hiteshbhoyar03/Cubesat/Electrical Power System_EPS/docs/eps pinout.xlsx

Sheet: Legend
PIN TYPE | REMARKS | Status | Date | Description | Item | Was | Is | Approved by | Protection Notes:
ANALOG | A | Created | 2025-06-10 | Created the sheet | Whole sheet |  | V1.0.0 | Hitesh
CAN | C
GPIO | G
I2C | I
USB_OTG | O
QUADSPI | Q
SPI | S
TIMER | T
UART | U
JTAG
NO CONNECTION | NC

Sheet: SRIC
PIN NUMBER | PIN SIGNAL | REMARK | PIN USAGE | Discription
PA05 | ADC1_IN10 |  | Ports | Adc Port for External device like bms
PA00 | ADC1_IN5 |  | Ports | Adc Port for External device like bms
PA01 | ADC1_IN6 |  | Ports | Adc Port for External device like bms
PA04 | ADC1_IN9 |  | Ports | Adc Port for External device like bms
PB09 | DEBUG_LED1_SR |  | Led | Digital OUTPUT:Active low push pull configuration Debug Led
PB08 | DEBUG_LED2_SR |  | Led | Digital OUTPUT:Active low push pull configuration Debug Led
PB07 | DEBUG_LED3_SR |  | Led | Digital OUTPUT:Active low push pull configuration Debug Led
PB06 | DEBUG_LED4_SR |  | Led | Digital OUTPUT:Active low push pull configuration Debug Led
PA12 | DONE_SR |  |  | Watchdog
PB13 | EN_3V3_1_BUCK_SR |  |  | Digital OUTPUT:Active high push pull configuration
PB14 | EN_3V3_1_SR |  |  | Digital OUTPUT:Active high push pull configuration
PB00 | EN_3V3_2_BUCK_SR |  |  | Digital OUTPUT:Active high push pull configuration
PB01 | EN_3V3_2_SR |  |  | Digital OUTPUT:Active high push pull configuration
PB15 | EN_5V_BOOST_SR |  |  | Digital OUTPUT:Active high push pull configuration
PA08 | EN_5V_SR |  |  | Digital OUTPUT:Active high push pull configuration
PA07 | EN_MCU_3V3_SR |  |  | Digital OUTPUT:Active high push pull configuration
PA06 | EN_MCU_BUCK_SR |  |  | Digital OUTPUT:Active high push pull configuration
PB02 | EN_UNREG1_SR |  |  | Digital OUTPUT:Active high push pull configuration
PB12 | EN_UNREG2_SR |  |  | Digital OUTPUT:Active high push pull configuration
PC13 | nEN_EPS_3V3_SR |  |  | Digital OUTPUT:Active low push pull configuration
PA11 | WAKE_SR
PH0-OSC_IN (PH0) | RCC_OSC_IN
PH1-OSC_OUT (PH1) | RCC_OSC_OUT
PC14-OSC32_IN (PC14) | RCC_OSC32_IN
PC15-OSC32_OUT (PC15) | RCC_OSC32_OUT
PA14 | SYS_JTCK-SWCLK |  |  | Jtag
PB03 | SYS EXTRA |  |  | Jtag
PA13 | SYS_JTMS-SWDIO |  |  | Jtag
PA10 | USART1_RX |  |  | DEBUG UART
PA09 | USART1_TX |  |  | DEBUG UART
PA03 | USART2_RX |  |  | Uart EPS -SR
PA02 | USART2_TX |  |  | Uart EPS -SR
PB11 | USART3_RX |  |  | Uart OBC -SR
PB10 | USART3_TX |  |  | Uart OBC -SR

Sheet: PMIC
PIN NUMBER | PIN SIGNAL | REMARK | PIN USAGE | Discription
PA05 | ADC1_IN05 | A |  | ISENS_3V3_1
PA06 | ADC1_IN06 | A |  | ISENS_MCU
PA07 | ADC1_IN07 | A |  | Iout_Z-
PC04 | ADC1_IN08 | A |  | Iout_Y+
PC05 | ADC1_IN09 | A |  | Iout_X-
PB00 | ADC1_IN10 | A |  | Iout_Z+
PB01 | ADC1_IN11 | A |  | Iout_Y-
PA00 | ADC1_IN12 | A |  | Iout_X+
PA01 | ADC1_IN13 | A |  | Vout_YZ
PA02 | ADC1_IN14 | A |  | Vout_ZX
PA03 | ADC1_IN15 | A |  | Vout_XY
PA04 | ADC1_IN16 | A |  | Vout_Panels
PC00 | ADC3_IN1 | A |  | ISENS_UNREG2
PC01 | ADC3_IN2 | A |  | ISENS_UNREG1
PC02 | ADC3_IN3 | A |  | ISENS_5V
PC03 | ADC3_IN4 | A |  | ISENS_3V3_2
PD00 | CAN1_RX | C | PC-104 | Can A
PD01 | CAN1_TX | C | PC-104 | Can A
PB12 | CAN2_RX | C | PC-104 | Can B
PB13 | CAN2_TX | C | PC-104 | Can B
PB06 | I2C1_SCL | I | Port
PB09 | I2C1_SDA | I | Port
PE01 | DEBUG_LED1 | G | Led | Digital OUTPUT:Active low push pull configuration Debug Led
PE02 | DEBUG_LED2 | G | Led | Digital OUTPUT:Active low push pull configuration Debug Led
PE03 | DEBUG_LED3 | G | Led | Digital OUTPUT:Active low push pull configuration Debug Led
PE04 | DEBUG_LED4 | G | Led | Digital OUTPUT:Active low push pull configuration Debug Led
PE05 | DEBUG_LED5 | G | Led | Digital OUTPUT:Active low push pull configuration Debug Led
PC08 | DONE | G |  | Watchdog
PD11 | EN_3V3_1_BUCK_PM | G |  | Digital OUTPUT:Active high push pull configuration
PE14 | EN_3V3_1_PM | G |  | Digital OUTPUT:Active high push pull configuration
PE15 | EN_3V3_2_BUCK_PM | G |  | Digital OUTPUT:Active high push pull configuration
PD10 | EN_3V3_2_PM | G |  | Digital OUTPUT:Active high push pull configuration
PB02 | EN_5V_BOOST_PM | G |  | Digital OUTPUT:Active high push pull configuration
PE07 | EN_5V_PM | G |  | Digital OUTPUT:Active high push pull configuration
PD08 | EN_MCU_3V3_PM | G |  | Digital OUTPUT:Active high push pull configuration
PD09 | EN_MCU_BUCK_PM | G |  | Digital OUTPUT:Active high push pull configuration
PE08 | EN_UNREG1_PM | G |  | Digital OUTPUT:Active high push pull configuration
PE09 | EN_UNREG2_PM | G |  | Digital OUTPUT:Active high push pull configuration
PC09 | WAKE | G |  | Watchdog
PE12 | QUADSPI_BK1_IO0 | Q |  | Mram
PE13 | QUADSPI_BK1_IO1 | Q |  | Mram
PE11 | QUADSPI_BK1_NCS | Q |  | Mram
PE10 | QUADSPI_CLK | Q |  | Mram
PH0-OSC_IN (PH0) | RCC_OSC_IN
PH1-OSC_OUT (PH1) | RCC_OSC_OUT
PC14-OSC32_IN (PC14) | RCC_OSC32_IN
PC15-OSC32_OUT (PC15) | RCC_OSC32_OUT
PB14 | SPI2_MISO | S |  | NA
PB15 | SPI2_MOSI | S |  | NA
PD03 | SPI2_SCK | S |  | NA
PA14 (JTCK/SWCLK) | SYS_JTCK-SWCLK |  |  | Jtag
PA15 (JTDI) | SYS_JTDI |  |  | Jtag
PB03 (JTDO/TRACESWO) | SYS_JTDO-SWO |  |  | Jtag
PA13 (JTMS/SWDIO) | SYS_JTMS-SWDIO |  |  | Jtag
PB04 (NJTRST) | SYS_JTRST |  |  | Jtag
PC06 | TIM3_CH1 | T |  | Battery Heater Pwm
PC07 | TIM3_CH2 | T |  | Battery Heater Pwm
PD12 | TIM4_CH1 | T |  | Mppt_Pwm1
PD13 | TIM4_CH2 | T |  | Mppt_Pwm2
PD14 | TIM4_CH3 | T |  | Mppt_Pwm3
PC11 | UART4_RX | U |  | Uart Port for External device like bms
PC10 | UART4_TX | U |  | Uart Port for External device like bms
PB07 | USART1_RX | U |  | DEBUG UART
PA09 | USART1_TX | U |  | DEBUG UART
PD06 | USART2_RX | U |  | Uart SR_EPS
PD05 | USART2_TX | U |  | Uart SR_EPS
PB11 | USART3_RX | U |  | Uart OBC -EPS
PB10 | USART3_TX | U |  | Uart OBC -EPS
PA11 | USB_OTG_FS_DM | O |  | micro usb port
PA12 | USB_OTG_FS_DP | O |  | micro usb port
PA10 | USB_OTG_FS_ID | O |  | micro usb port

Sheet: PMIC ordered
PIN NUMBER | PIN SIGNAL | REMARK
PA00 | ADC1_IN12 | A
PA01 | ADC1_IN13 | A
PA02 | ADC1_IN14 | A
PA03 | ADC1_IN15 | A
PA04 | ADC1_IN16 | A
PA05 | ADC1_IN05 | A
PA06 | ADC1_IN06 | A
PA07 | ADC1_IN07 | A
PA09 | USART1_TX | U
PA10 | USB_OTG_FS_ID | O
PA11 | USB_OTG_FS_DM | O
PA12 | USB_OTG_FS_DP | O
PA13 (JTMS/SWDIO) | SYS_JTMS-SWDIO
PA14 (JTCK/SWCLK) | SYS_JTCK-SWCLK
PA15 (JTDI) | SYS_JTDI
PB00 | ADC1_IN10 | A
PB01 | ADC1_IN11 | A
PB02 | EN_5V_BOOST_PM | G
PB03 (JTDO/TRACESWO) | SYS_JTDO-SWO
PB04 (NJTRST) | SYS_JTRST
PB06 | I2C1_SCL | I
PB07 | USART1_RX | U
PB09 | I2C1_SDA | I
PB10 | USART3_TX | U
PB11 | USART3_RX | U
PB12 | CAN2_RX | C
PB13 | CAN2_TX | C
PB14 | SPI2_MISO | S
PB15 | SPI2_MOSI | S
PC00 | ADC3_IN1 | A
PC01 | ADC3_IN2 | A
PC02 | ADC3_IN3 | A
PC03 | ADC3_IN4 | A
PC04 | ADC1_IN08 | A
PC05 | ADC1_IN09 | A
PC06 | TIM3_CH1 | T
PC07 | TIM3_CH2 | T
PC08 | DONE | G
PC09 | WAKE | G
PC10 | UART4_TX | U
PC11 | UART4_RX | U
PC14-OSC32_IN (PC14) | RCC_OSC32_IN
PC15-OSC32_OUT (PC15) | RCC_OSC32_OUT
PD00 | CAN1_RX | C
PD01 | CAN1_TX | C
PD03 | SPI2_SCK | S
PD05 | USART2_TX | U
PD06 | USART2_RX | U
PD08 | EN_MCU_3V3_PM | G
PD09 | EN_MCU_BUCK_PM | G
PD10 | EN_3V3_2_PM | G
PD11 | EN_3V3_1_BUCK_PM | G
PD12 | TIM4_CH1 | T
PD13 | TIM4_CH2 | T
PD14 | TIM4_CH3 | T
PE01 | DEBUG_LED1 | G
PE02 | DEBUG_LED2 | G
PE03 | DEBUG_LED3 | G
PE04 | DEBUG_LED4 | G
PE05 | DEBUG_LED5 | G
PE07 | EN_5V_PM | G
PE08 | EN_UNREG1_PM | G
PE09 | EN_UNREG2_PM | G
PE10 | QUADSPI_CLK | Q
PE11 | QUADSPI_BK1_NCS | Q
PE12 | QUADSPI_BK1_IO0 | Q
PE13 | QUADSPI_BK1_IO1 | Q
PE14 | EN_3V3_1_PM | G
PE15 | EN_3V3_2_BUCK_PM | G
PH0-OSC_IN (PH0) | RCC_OSC_IN
PH1-OSC_OUT (PH1) | RCC_OSC_OUT

Sheet: Uart Protocol data
 |  |  |  |  |  | PMIC_2_SRIC |  |  | SRIC_2_PMIC |  |  | OBC_2_SRIC |  |  | SRIC_2_OBC |  |  | OBC_2_PMIC |  |  | PMIC_2_OBC
 |  |  |  |  |  | DATA |  |  | DATA |  |  | DATA |  |  | DATA |  |  | DATA |  |  | DATA
SENDER | RECEIVER | HEADER1 | HEADER2 | Byte | Remark | Function | Byte | Remark | Function | Byte | Remark | Function | Byte | Remark | Function | Byte | Remark | Function | Byte | Remark | Function
 |  |  |  | 1 | HEADER1 | 0xEF | 1 | HEADER1 | 0xFE | 1 | HEADER1 | 0xBF | 1 | HEADER1 | 0xFB | 1 | HEADER1 | 0xBE | 1 | HEADER1 | 0xEB
ADCS | OBC | 0xAB |  | 2 | HEADER2 |  | 2 | HEADER2 |  | 2 | HEADER2 |  | 2 | HEADER2 |  | 2 | HEADER2 |  | 2 | HEADER2
OBC | ADCS | 0xBA |  | 3 | channel_0 | nEN_EPS_3V3 | 3 | channel_0 |  | 3 | channel_0 | EN_3V3_1_BUCK | 3 | channel_0 |  | 3 | channel_0 | EN_3V3_1_BUCK | 3 | channel_0
OBC | TEL1 | 0xBC |  | 4 | channel_1 |  | 4 | channel_1 |  | 4 | channel_1 | EN_3V3_1 | 4 | channel_1 |  | 4 | channel_1 | EN_3V3_1 | 4 | channel_1
OBC | TEL2 | 0xBD |  | 5 | channel_2 |  | 5 | channel_2 |  | 5 | channel_2 | EN_3V3_2_BUCK | 5 | channel_2 |  | 5 | channel_2 | EN_3V3_2_BUCK | 5 | channel_2
OBC | PMIC | 0xBE |  | 6 | channel_3 |  | 6 | channel_3 |  | 6 | channel_3 | EN_3V3_2 | 6 | channel_3 |  | 6 | channel_3 | EN_3V3_2 | 6 | channel_3
OBC | SRIC | 0xBF |  | 7 | channel_4 |  | 7 | channel_4 |  | 7 | channel_4 | EN_5V_BOOST | 7 | channel_4 |  | 7 | channel_4 | EN_5V_BOOST | 7 | channel_4
PMIC | SRIC | 0xEF |  | 8 | channel_5 |  | 8 | channel_5 |  | 8 | channel_5 | EN_5V | 8 | channel_5 |  | 8 | channel_5 | EN_5V | 8 | channel_5
PMIC | OBC | 0xEB |  | 9 | channel_6 |  | 9 | channel_6 |  | 9 | channel_6 | EN_UNREG1 | 9 | channel_6 |  | 9 | channel_6 | EN_UNREG1 | 9 | channel_6
SRIC | OBC | 0xFB |  | 10 | channel_7 |  | 10 | channel_7 |  | 10 | channel_7 | EN_UNREG2 | 10 | channel_7 |  | 10 | channel_7 | EN_UNREG2 | 10 | channel_7
SRIC | PMIC | 0xFE |  | 11 | channel_8 |  | 11 | channel_8 |  | 11 | channel_8 | EN_MCU_BUCK | 11 | channel_8 |  | 11 | channel_8 | EN_MCU_BUCK | 11 | channel_8
TEL1 | OBC | 0xCB |  | 12 | channel_9 |  | 12 | channel_9 |  | 12 | channel_9 | EN_MCU_3V3 | 12 | channel_9 |  | 12 | channel_9 | EN_MCU_3V3 | 12 | channel_9
TEL2 | OBC | 0xDB |  | 13 | channel_a |  | 13 | channel_a |  | 13 | channel_a | nEN_EPS_3V3 | 13 | channel_a |  | 13 | channel_a |  | 13 | channel_a
 |  |  |  | 14 | channel_b |  | 14 | channel_b |  | 14 | channel_b |  | 14 | channel_b |  | 14 | channel_b |  | 14 | channel_b
 |  |  |  | 15 | channel_c |  | 15 | channel_c |  | 15 | channel_c |  | 15 | channel_c |  | 15 | channel_c |  | 15 | channel_c
 |  |  |  | 16 | channel_d |  | 16 | channel_d |  | 16 | channel_d |  | 16 | channel_d |  | 16 | channel_d |  | 16 | channel_d
 |  |  |  | 17 | channel_e |  | 17 | channel_e |  | 17 | channel_e |  | 17 | channel_e |  | 17 | channel_e |  | 17 | channel_e
 |  |  |  | 18 | channel_f |  | 18 | channel_f |  | 18 | channel_f |  | 18 | channel_f |  | 18 | channel_f |  | 18 | channel_f
 |  |  |  | 19 | crc_low |  | 19 | crc_low |  | 19 | crc_low |  | 19 | crc_low |  | 19 | crc_low |  | 19 | crc_low
 |  |  |  | 20 | crc_high |  | 20 | crc_high |  | 20 | crc_high |  | 20 | crc_high |  | 20 | crc_high |  | 20 | crc_high

Sheet: PWR EN
 | BIT_7 | BIT_6 | BIT_5 | BIT_4 | BIT_3 | BIT_2 | BIT_1 | BIT_0
channel_0 | tbd | tbd | tbd | tbd | tbd | tbd | tbd | EN PWR | EN_3V3_1_BUCK | OBC 2 SRIC | OBC 2 PMIC
channel_1 | tbd | tbd | tbd | tbd | tbd | tbd | tbd | EN PWR | EN_3V3_1 | OBC 2 SRIC | OBC 2 PMIC
channel_2 | tbd | tbd | tbd | tbd | tbd | tbd | tbd | EN PWR | EN_3V3_2_BUCK | OBC 2 SRIC | OBC 2 PMIC
channel_3 | tbd | tbd | tbd | tbd | tbd | tbd | tbd | EN PWR | EN_3V3_2 | OBC 2 SRIC | OBC 2 PMIC
channel_4 | tbd | tbd | tbd | tbd | tbd | tbd | tbd | EN PWR | EN_5V_BOOST | OBC 2 SRIC | OBC 2 PMIC
channel_5 | tbd | tbd | tbd | tbd | tbd | tbd | tbd | EN PWR | EN_5V | OBC 2 SRIC | OBC 2 PMIC
channel_6 | tbd | tbd | tbd | tbd | tbd | tbd | tbd | EN PWR | EN_UNREG1 | OBC 2 SRIC | OBC 2 PMIC
channel_7 | tbd | tbd | tbd | tbd | tbd | tbd | tbd | EN PWR | EN_UNREG2 | OBC 2 SRIC | OBC 2 PMIC
channel_8 | tbd | tbd | tbd | tbd | tbd | tbd | tbd | EN PWR | EN_MCU_BUCK | OBC 2 SRIC | OBC 2 PMIC
channel_9 | tbd | tbd | tbd | tbd | tbd | tbd | tbd | EN PWR | EN_MCU_3V3 | OBC 2 SRIC | OBC 2 PMIC
channel_a | tbd | tbd | tbd | tbd | tbd | tbd | tbd | EN PWR | nEN_EPS_3V3 | OBC 2 SRIC
channel_0 | tbd | tbd | tbd | tbd | tbd | tbd | tbd | EN PWR | nEN_EPS_3V3 | PMIC 2 SRIC

Sheet: ADC BUFFER
SRIC |  | PMIC |  | PMIC
ADC1_IN5 | TBD | ADC1_IN05 | ISENS_3V3_1 | ADC3_IN1 | ISENS_UNREG2
ADC1_IN6 | TBD | ADC1_IN06 | ISENS_MCU | ADC3_IN2 | ISENS_UNREG1
ADC1_IN9 | TBD | ADC1_IN07 | Iout_Z- | ADC3_IN3 | ISENS_5V
ADC1_IN10 | TBD | ADC1_IN08 | Iout_Y+ | ADC3_IN4 | ISENS_3V3_2
Internal | VBAT | ADC1_IN09 | Iout_X- | Internal | Temperature
Internal | VREFINT | ADC1_IN10 | Iout_Z+ | Internal | VBAT
 |  | ADC1_IN11 | Iout_Y-
 |  | ADC1_IN12 | Iout_X+
 |  | ADC1_IN13 | Vout_YZ
 |  | ADC1_IN14 | Vout_ZX
 |  | ADC1_IN15 | Vout_XY
 |  | ADC1_IN16 | Vout_Panels
 |  | Internal | Temperature
 |  | Internal | VBAT
 |  | Internal | VREFINT
