hiteshbhoyar03/Cubesat/Sun Sensor/docs/sun sensor pinout.xlsx

Sheet: Legend
PIN TYPE | REMARKS | Status | Date | Description | Item | Was | Is | Approved by | Protection Notes:
ANALOG | A | Created | 2025-06-10 | Created the sheet | Whole sheet |  | V1.0.0 | Hitesh
GPIO | G
SPI | S
JTAG
NO CONNECTION | NC

Sheet: PinFunctions
PIN NUMBER | PIN SIGNAL | REMARK | PIN USAGE | Discription | Register Map
PA00 | ADC_IN0 | A | Y2_PSD1 |  | 0x00 | Y2_PSD1
PA01 | ADC_IN1 | A | X1_PSD1 |  | 0x01 | X1_PSD1
PA02 | ADC_IN2 | A | Y1_PSD1 |  | 0x02 | Y1_PSD1
PA03 | ADC_IN3 | A | X2_PSD1 |  | 0x03 | X2_PSD1
PA04 | ADC_IN4 | A | Y2_PSD2 |  | 0x04 | Y2_PSD2
PA05 | ADC_IN5 | A | X1_PSD2 |  | 0x05 | X1_PSD2
PA06 | ADC_IN6 | A | Y1_PSD2 |  | 0x06 | Y1_PSD2
PA07 | ADC_IN7 | A | X2_PSD2 |  | 0x07 | X2_PSD2
PA13 | SYS_SWDIO |  |  |  | 0x08 | Temp
PA14 | SYS_SWCLK |  |  |  | 0x09 | Vdd
PB0 | SPI1_MISO | S |  |  | 0x0A | position_x_psd1
PB1 | SPI1_MOSI | S |  |  | 0x0B | position_y_psd1
PB3 | SPI1_SCK | S |  |  | 0x0C | intensity_psd1
PB6 | GPIO | G | NCS | Digital INPUT: Active low input | 0x0D | position_x_psd2
 |  |  |  |  | 0x0E | position_y_psd2
 |  |  |  |  | 0x0F | intensity_psd2
