hiteshbhoyar03/Cubesat/OnBoard Computer_OBC/docs/obc pinout.xlsx

Sheet: Legend
PIN TYPE | REMARKS | Status | Date | Description | Item | Was | Is | Approved by | Protection Notes:
ANALOG | A | Created | 2025-06-10 | Created the sheet | Whole sheet |  | V1.0.0 | Hitesh
CAN | C
GPIO | G
I2C | I
USB_OTG | O
QUADSPI | Q
SPI | S
UART | U
JTAG
NO CONNECTION | NC

Sheet: PinFunctions
PIN NUMBER | PIN SIGNAL | REMARK | PIN USAGE | Discription
PA05 | ADC1_IN10 | A |  | tbd
PA06 | ADC1_IN11 | A |  | tbd
PA07 | ADC1_IN12 | A |  | tbd
PA00 | ADC1_IN5 | A |  | tbd
PA01 | ADC1_IN6 | A |  | tbd
PA02 | ADC1_IN7 | A |  | tbd
PA03 | ADC1_IN8 | A |  | tbd
PA04 | ADC1_IN9 | A |  | tbd
PC00 | ADC3_IN1 | A |  | tbd
PC01 | ADC3_IN2 | A |  | tbd
PC02 | ADC3_IN3 | A |  | tbd
PC03 | ADC3_IN4 | A |  | tbd
PD00 | CAN1_RX | C | PC-104 | Can A
PD01 | CAN1_TX | C | PC-104 | Can A
PB12 | CAN2_RX | C | PC-104 | Can B
PB13 | CAN2_TX | C | PC-104 | Can B
PG14 | I2C1_SCL | I
PG13 | I2C1_SDA | I
PF01 | I2C2_SCL | I | PC-104 | tbd
PF00 | I2C2_SDA | I | PC-104 | tbd
PG07 | I2C3_SCL | I | PC-104 | tbd
PC09 | I2C3_SDA | I | PC-104 | tbd
PG08 | LPUART1_RX | U |  | Uart Gps
PB11 | LPUART1_TX | U |  | Uart Gps
PD07 | DEBUG_LED1 | G | Led | Digital OUTPUT:Active low push pull configuration Debug Led
PG12 | DEBUG_LED2 | G | Led | Digital OUTPUT:Active low push pull configuration Debug Led
PG15 | DEBUG_LED3 | G | Led | Digital OUTPUT:Active low push pull configuration Debug Led
PB05 | DEBUG_LED4 | G | Led | Digital OUTPUT:Active low push pull configuration Debug Led
PB06 | DEBUG_LED5 | G | Led | Digital OUTPUT:Active low push pull configuration Debug Led
PB08 | DEBUG_LED6 | G | Led | Digital OUTPUT:Active low push pull configuration Debug Led
PB09 | DEBUG_LED7 | G | Led | Digital OUTPUT:Active low push pull configuration Debug Led
PE00 | DEBUG_LED8 | G | Led | Digital OUTPUT:Active low push pull configuration Debug Led
PF05 | DONE | G |  | Watchdog
PD8 | DRDY_MMC5983MA | G |  | Digital INPUT: Ready Interrupt from MMC5983MA
PB02 | INT1_ISM330ISN | G |  | Digital INPUT: Interrupt from ISM330ISN
PF11 | INT2_ISM330ISN | G |  | Digital INPUT: Interrupt from ISM330ISN
PA08 | n/a | G | PC-104 | tbd
PC07 | n/a | G | PC-104 | tbd
PC08 | n/a | G | PC-104 | tbd
PD10 | n/a | G | PC-104 | tbd
PD12 | n/a | G | PC-104 | tbd
PD13 | n/a | G | PC-104 | tbd
PD15 | n/a | G | PC-104 | tbd
PE07 | n/a | G | PC-104 | tbd
PE08 | n/a | G | PC-104 | tbd
PE09 | n/a | G | PC-104 | tbd
PG01 | n/a | G | PC-104 | tbd
PG02 | n/a | G | PC-104 | tbd
PG03 | n/a | G | PC-104 | tbd
PG04 | n/a | G | PC-104 | tbd
PG05 | n/a | G | PC-104 | tbd
PG06 | n/a | G | PC-104 | tbd
PB00 | nCS_ISM330ISN | G |  | Digital OUPUT: Active Low SPI Chip Select for ISM330ISN
PD9 | nCS_MMC5983MA | G |  | Digital OUPUT: Active Low SPI Chip Select for MMC5983MA
PC06 | nCS_MRAM1 | G |  | Digital OUPUT: Active Low SPI Chip Select for Mram1
PD14 | nCS_MRAM2 | G |  | Digital OUPUT: Active Low SPI Chip Select for Mram2
PF12 | nRESET_GPS | G |  | Digital OUPUT: Active Low Reset pin for Gps
PF03 | SPI1_nCS1 | G |  | Digital OUPUT: Active Low SPI Chip Select for Sunsensor1
PE03 | SPI1_nCS2 | G |  | Digital OUPUT: Active Low SPI Chip Select for Sunsensor2
PE02 | SPI1_nCS3 | G |  | Digital OUPUT: Active Low SPI Chip Select for Sunsensor3
PF04 | WAKE | G |  | Watchdog
PF08 | QUADSPI_BK1_IO0 | Q |  | Nor Flash
PF09 | QUADSPI_BK1_IO1 | Q |  | Nor Flash
PF07 | QUADSPI_BK1_IO2 | Q |  | Nor Flash
PF06 | QUADSPI_BK1_IO3 | Q |  | Nor Flash
PE11 | QUADSPI_BK1_NCS | Q |  | Nor Flash
PF10 | QUADSPI_CLK | Q |  | Nor Flash
PH00-OSC_IN (PH0) | RCC_OSC_IN
PH01-OSC_OUT (PH1) | RCC_OSC_OUT
PC14-OSC32_IN (PC14) | RCC_OSC32_IN
PC15-OSC32_OUT (PC15) | RCC_OSC32_OUT
PE14 | SPI1_MISO | S |  | Imu & Mag & Sunsensor
PE15 | SPI1_MOSI | S |  | Imu & Mag & Sunsensor
PE13 | SPI1_SCK | S |  | Imu & Mag & Sunsensor
PB14 | SPI2_MISO | S |  | Mram & PC-104
PB15 | SPI2_MOSI | S |  | Mram & PC-104
PB10 | SPI2_SCK | S |  | Mram & PC-104
PG10 | SPI3_MISO | S |  | PC-104
PG11 | SPI3_MOSI | S |  | PC-104
PG09 | SPI3_SCK | S |  | PC-104
PA14 (JTCK/SWCLK) | SYS_JTCK-SWCLK |  |  | Jtag
PA15 (JTDI) | SYS_JTDI |  |  | Jtag
PB03 (JTDO/TRACESWO) | SYS_JTDO-SWO |  |  | Jtag
PA13 (JTMS/SWDIO) | SYS_JTMS-SWDIO |  |  | Jtag
PB04 (NJTRST) | SYS_JTRST |  |  | Jtag
PC11 | UART4_RX | U |  | Uart OBC -EPS
PC10 | UART4_TX | U |  | Uart OBC -EPS
PD02 | UART5_RX | U |  | Uart OBC -SR
PC12 | UART5_TX | U |  | Uart OBC -SR
PB07 | USART1_RX | U |  | DEBUG UART
PA09 | USART1_TX | U |  | DEBUG UART
PD03 | USART2_CTS | U |  | Telemetry1
PD04 | USART2_RTS | U |  | Telemetry1
PD06 | USART2_RX | U |  | Telemetry1
PD05 | USART2_TX | U |  | Telemetry1
PD11 | USART3_CTS | U |  | Telemetry2
PB01 | USART3_RTS | U |  | Telemetry2
PC05 | USART3_RX | U |  | Telemetry2
PC04 | USART3_TX | U |  | Telemetry2
PA11 | USB_OTG_FS_DM | O |  | micro usb port
PA12 | USB_OTG_FS_DP | O |  | micro usb port
PA10 | USB_OTG_FS_ID | O |  | micro usb port
