hiteshbhoyar03/Cubesat/Battery Board/gallery/battery board back blue.png

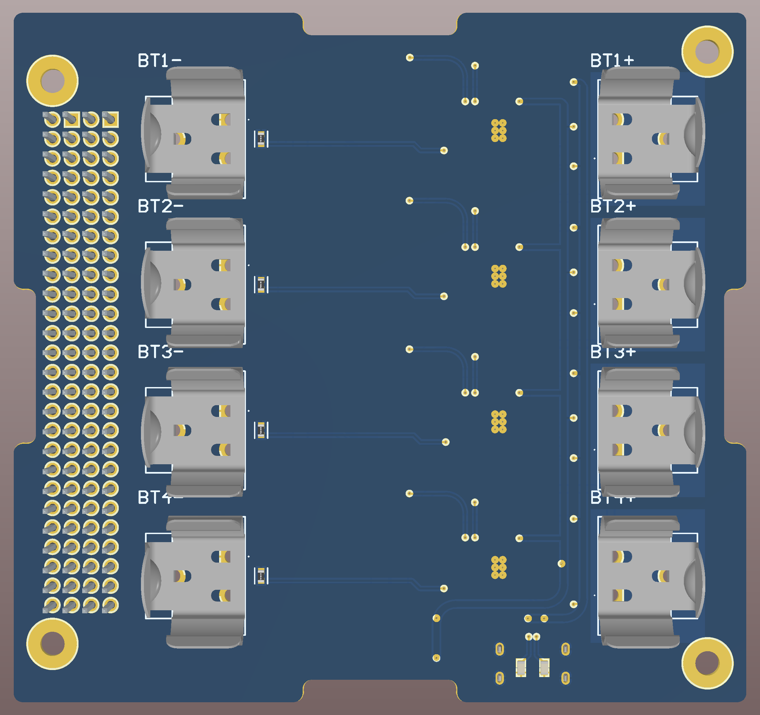
Battery Board/gallery/battery board back blue.png
