hiteshbhoyar03/Cubesat/Battery Board/gallery/battery board front blue.png

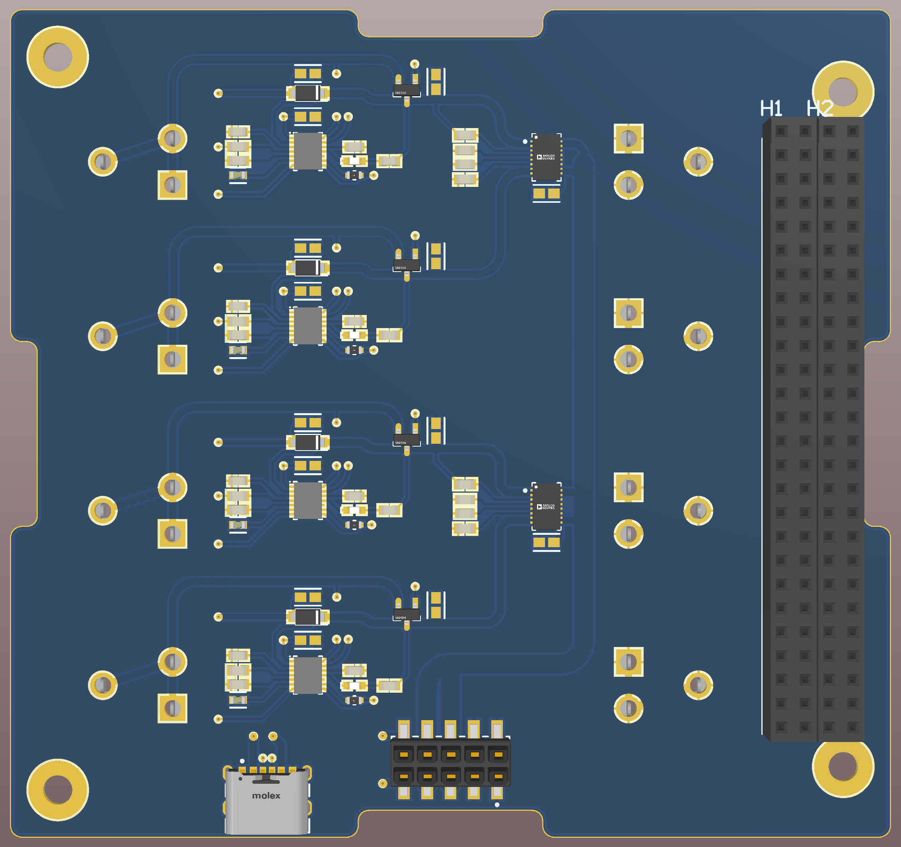
Battery Board/gallery/battery board front blue.png
