hiteshbhoyar03/Cubesat/Battery Board/gallery/battery board layer 1.png

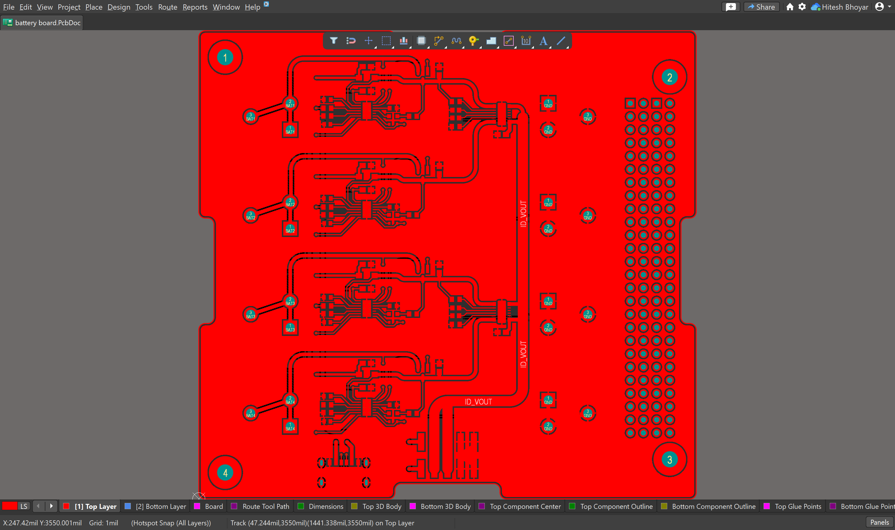
Battery Board/gallery/battery board layer 1.png
