hiteshbhoyar03/Cubesat/Battery Board/gallery/battery board layer 2.png

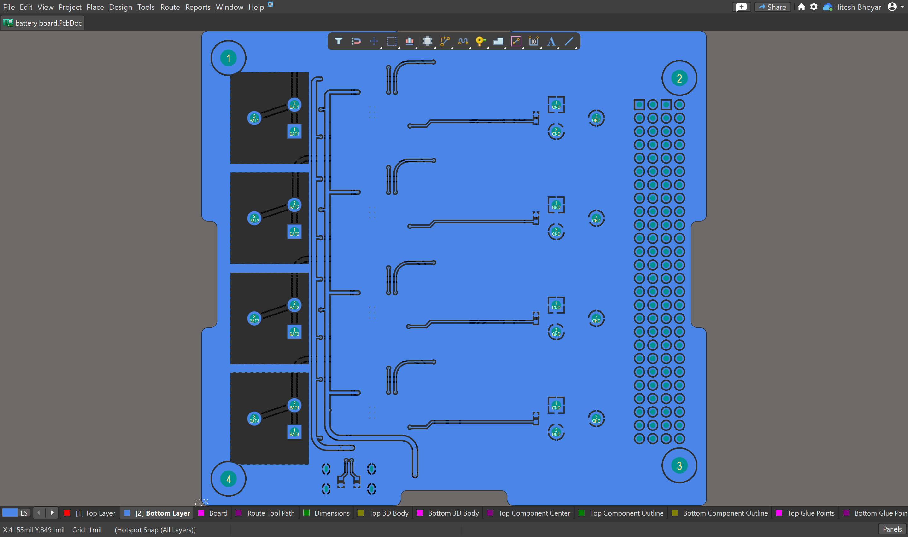
Battery Board/gallery/battery board layer 2.png
