hiteshbhoyar03/Cubesat/Electrical Power System_EPS/gallery/EPS_v1 back blue.png

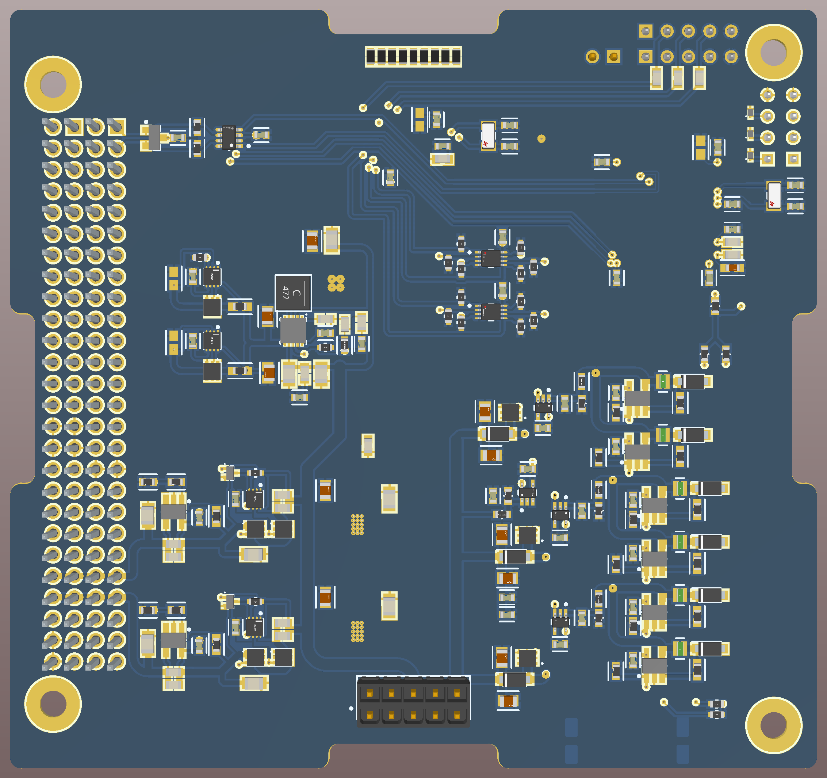
Electrical Power System_EPS/gallery/EPS_v1 back blue.png
