hiteshbhoyar03/Cubesat/Electrical Power System_EPS/gallery/EPS_v1 layer 1.png

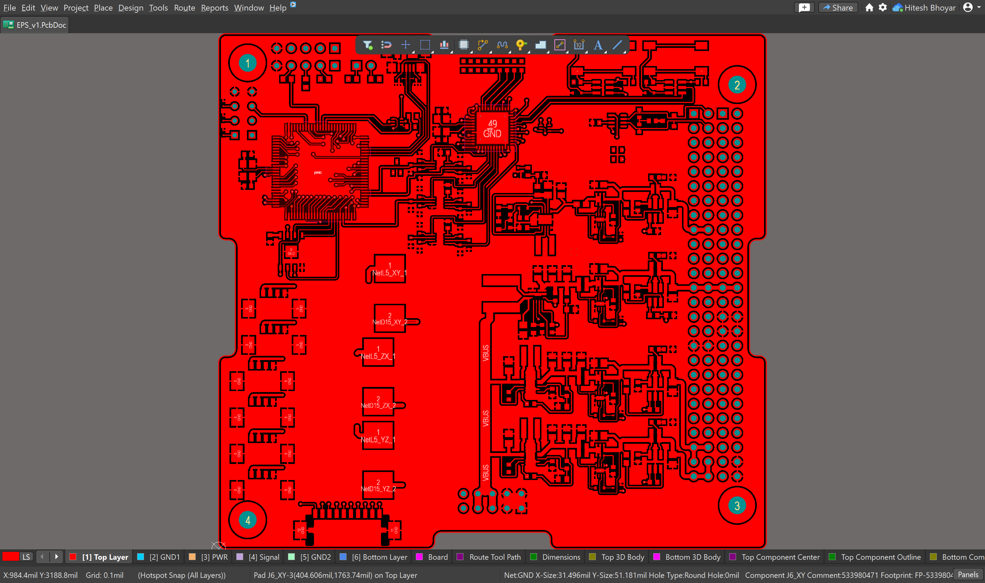
Electrical Power System_EPS/gallery/EPS_v1 layer 1.png
