hiteshbhoyar03/Cubesat/Electrical Power System_EPS/gallery/EPS_v1 layer 5.png

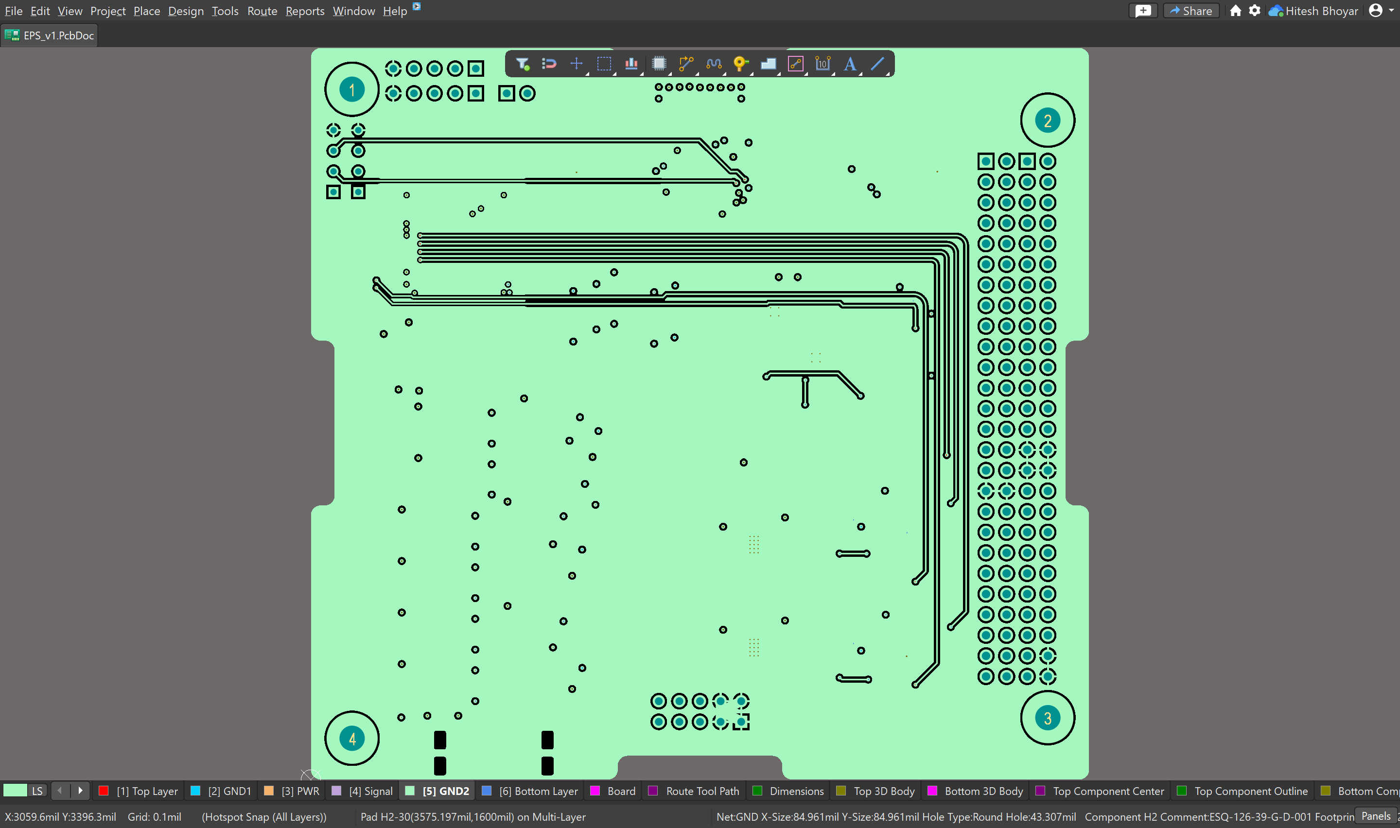
Electrical Power System_EPS/gallery/EPS_v1 layer 5.png
