hiteshbhoyar03/Cubesat/OnBoard Computer_OBC/gallery/obc back blue.png

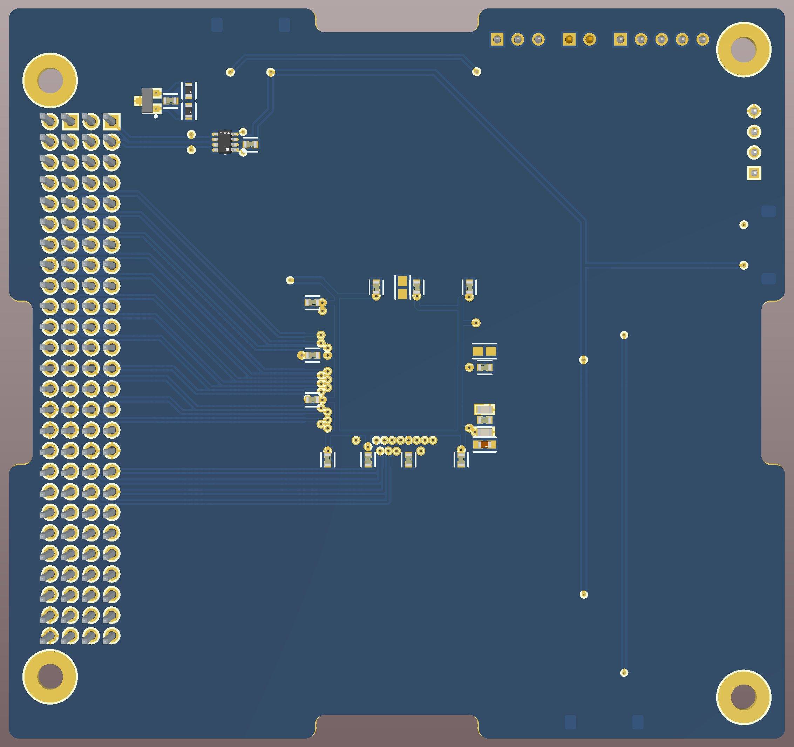
OnBoard Computer_OBC/gallery/obc back blue.png
