hiteshbhoyar03/Cubesat/OnBoard Computer_OBC/gallery/obc front blue.png

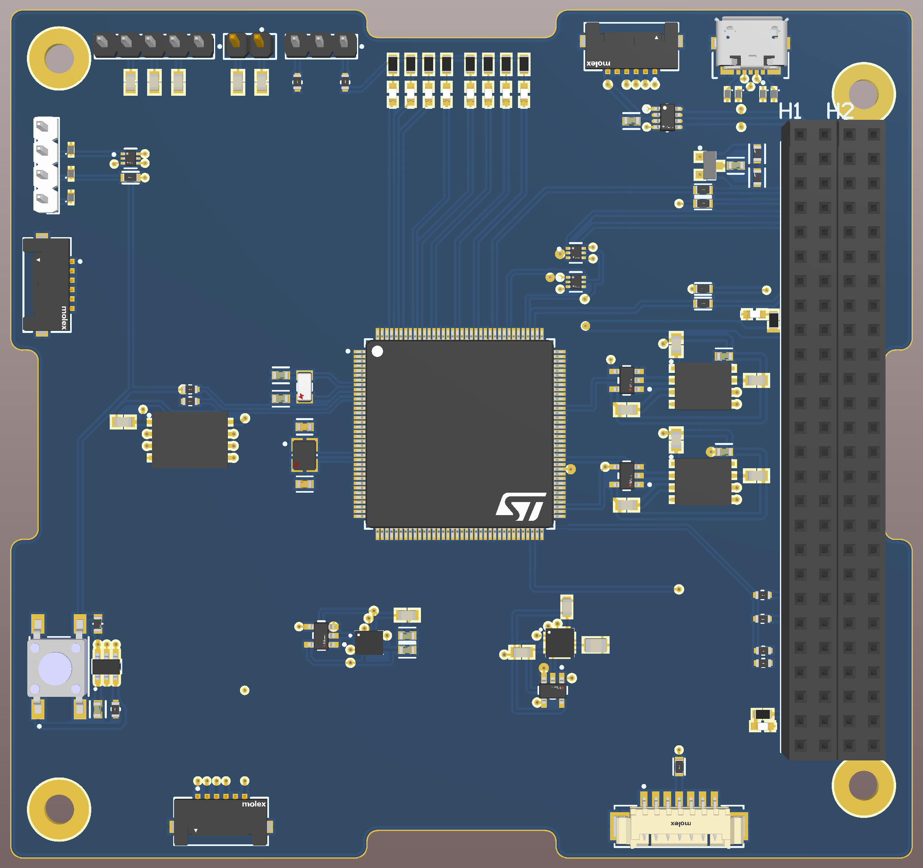
OnBoard Computer_OBC/gallery/obc front blue.png
