hiteshbhoyar03/Cubesat/OnBoard Computer_OBC/gallery/obc layer 1.png

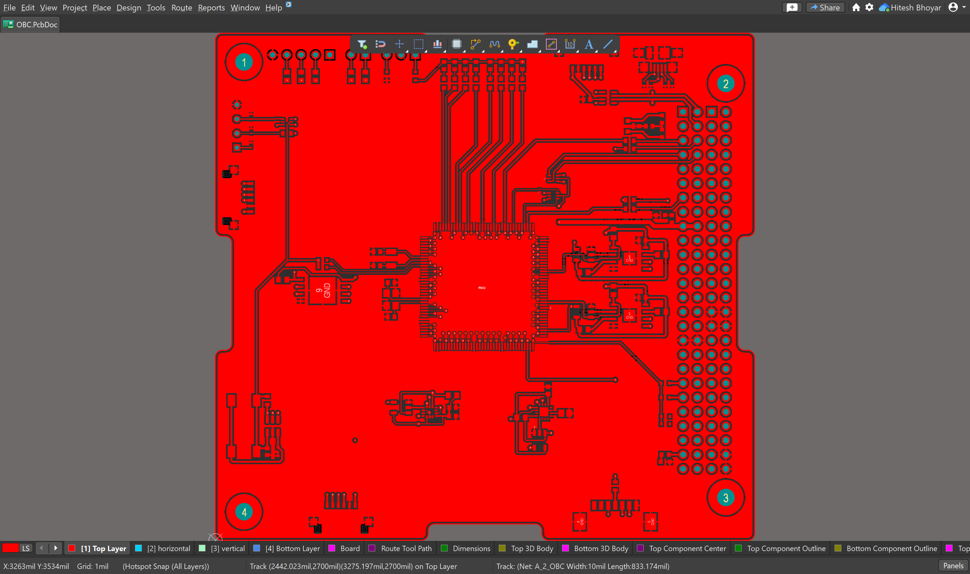
OnBoard Computer_OBC/gallery/obc layer 1.png
