hiteshbhoyar03/Cubesat/OnBoard Computer_OBC/gallery/obc layer 2.png

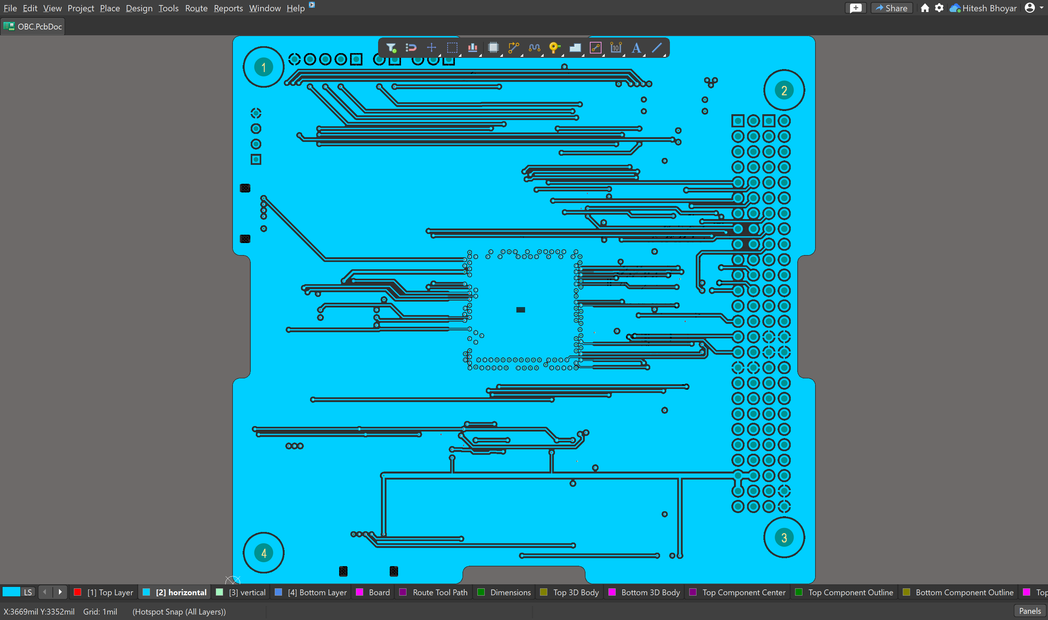
OnBoard Computer_OBC/gallery/obc layer 2.png
