hiteshbhoyar03/Cubesat/OnBoard Computer_OBC/gallery/obc layer 3.png

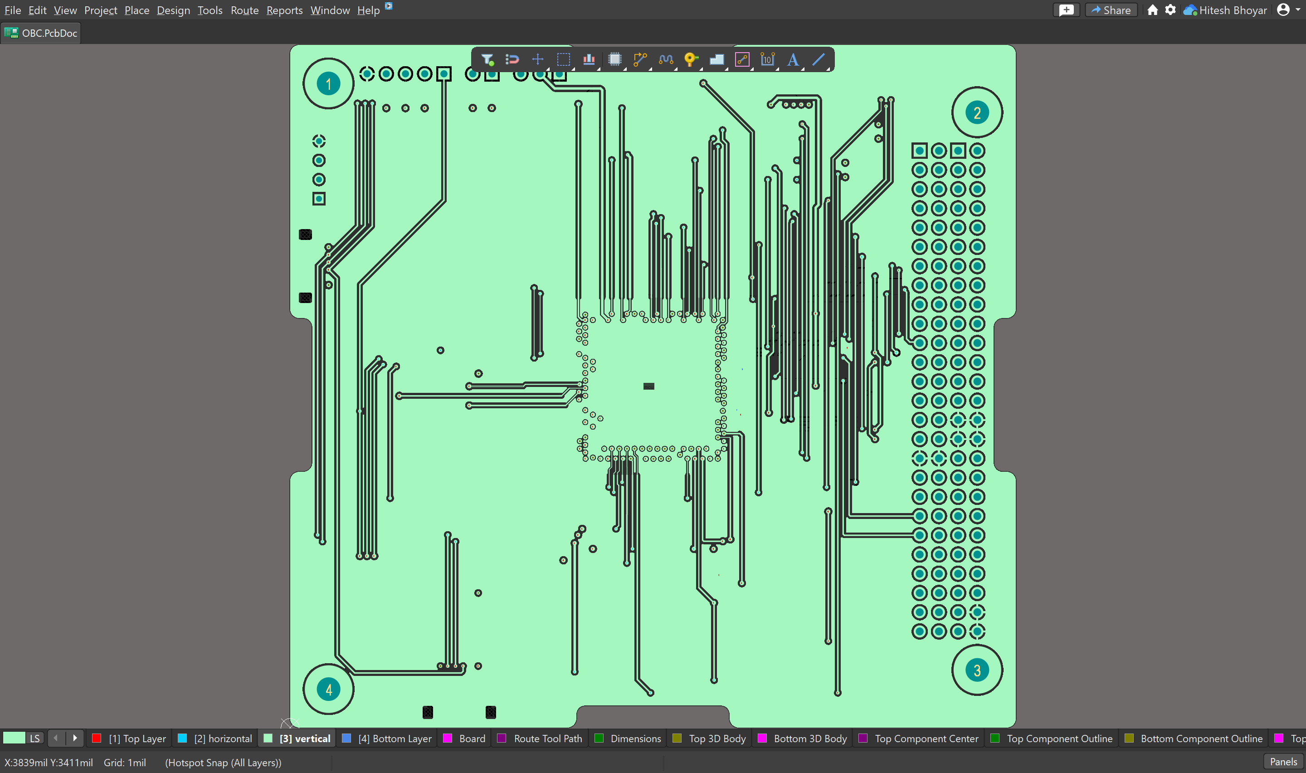
OnBoard Computer_OBC/gallery/obc layer 3.png
