hiteshbhoyar03/Cubesat/OnBoard Computer_OBC/gallery/obc layer 4.png

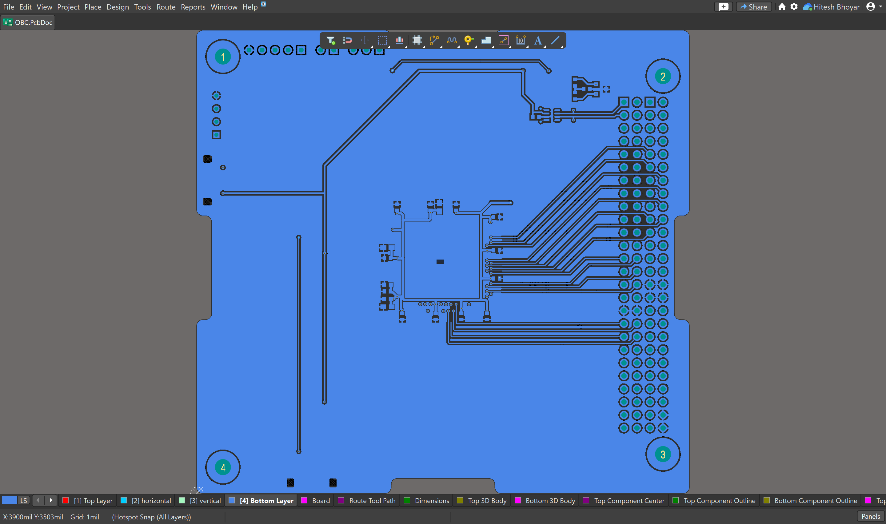
OnBoard Computer_OBC/gallery/obc layer 4.png
