hiteshbhoyar03/Cubesat/Sun Sensor/gallery/sunsensor back blue.png

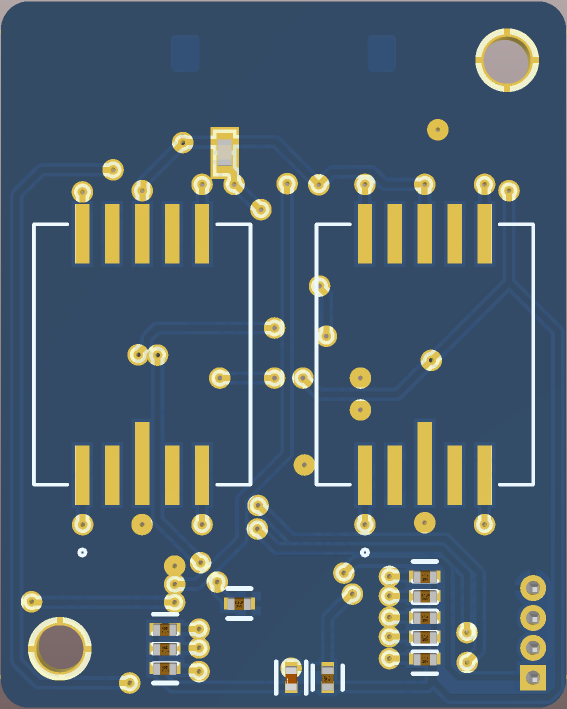
Sun Sensor/gallery/sunsensor back blue.png
