hiteshbhoyar03/Cubesat/Sun Sensor/gallery/sunsensor front blue.png

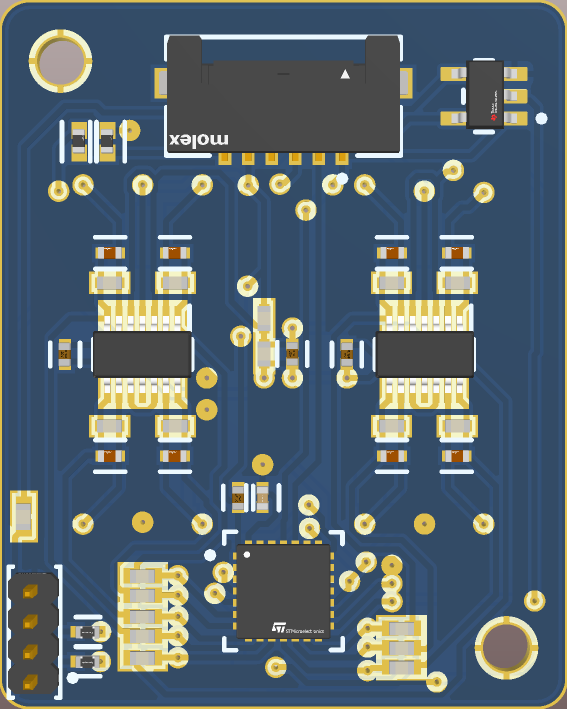
Sun Sensor/gallery/sunsensor front blue.png
