hiteshbhoyar03/Cubesat/Sun Sensor/gallery/sunsensor layer 1.png

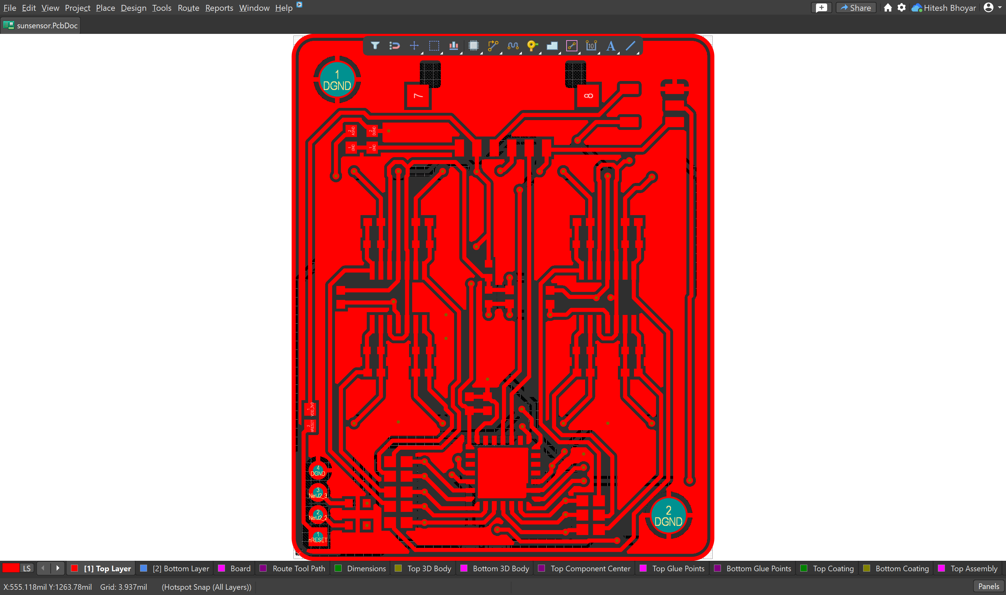
Sun Sensor/gallery/sunsensor layer 1.png
