hiteshbhoyar03/Cubesat/Sun Sensor/gallery/sunsensor layer 2.png

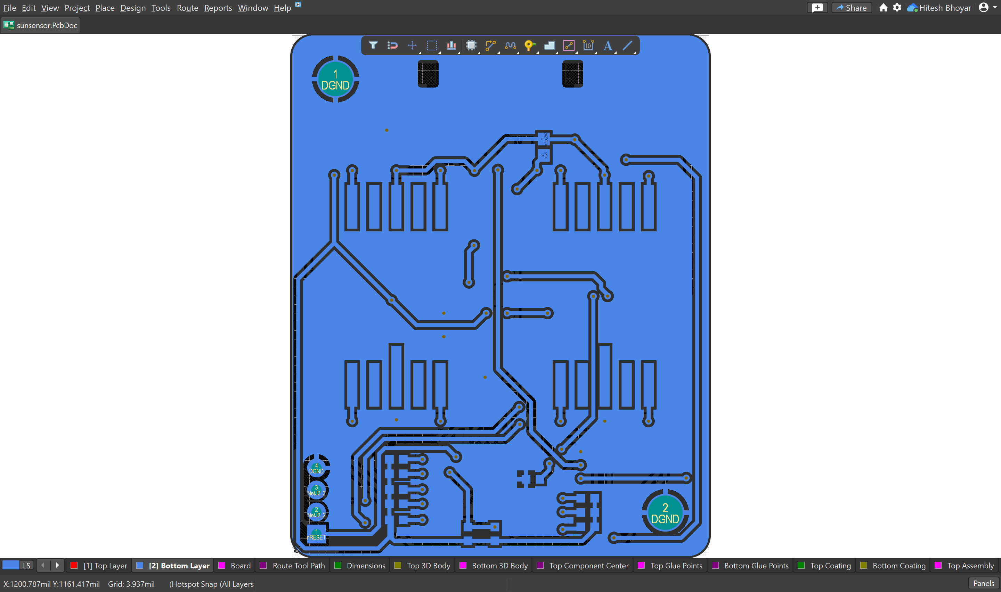
Sun Sensor/gallery/sunsensor layer 2.png
