hiteshbhoyar03/Cubesat/Schematic battery board.pdf

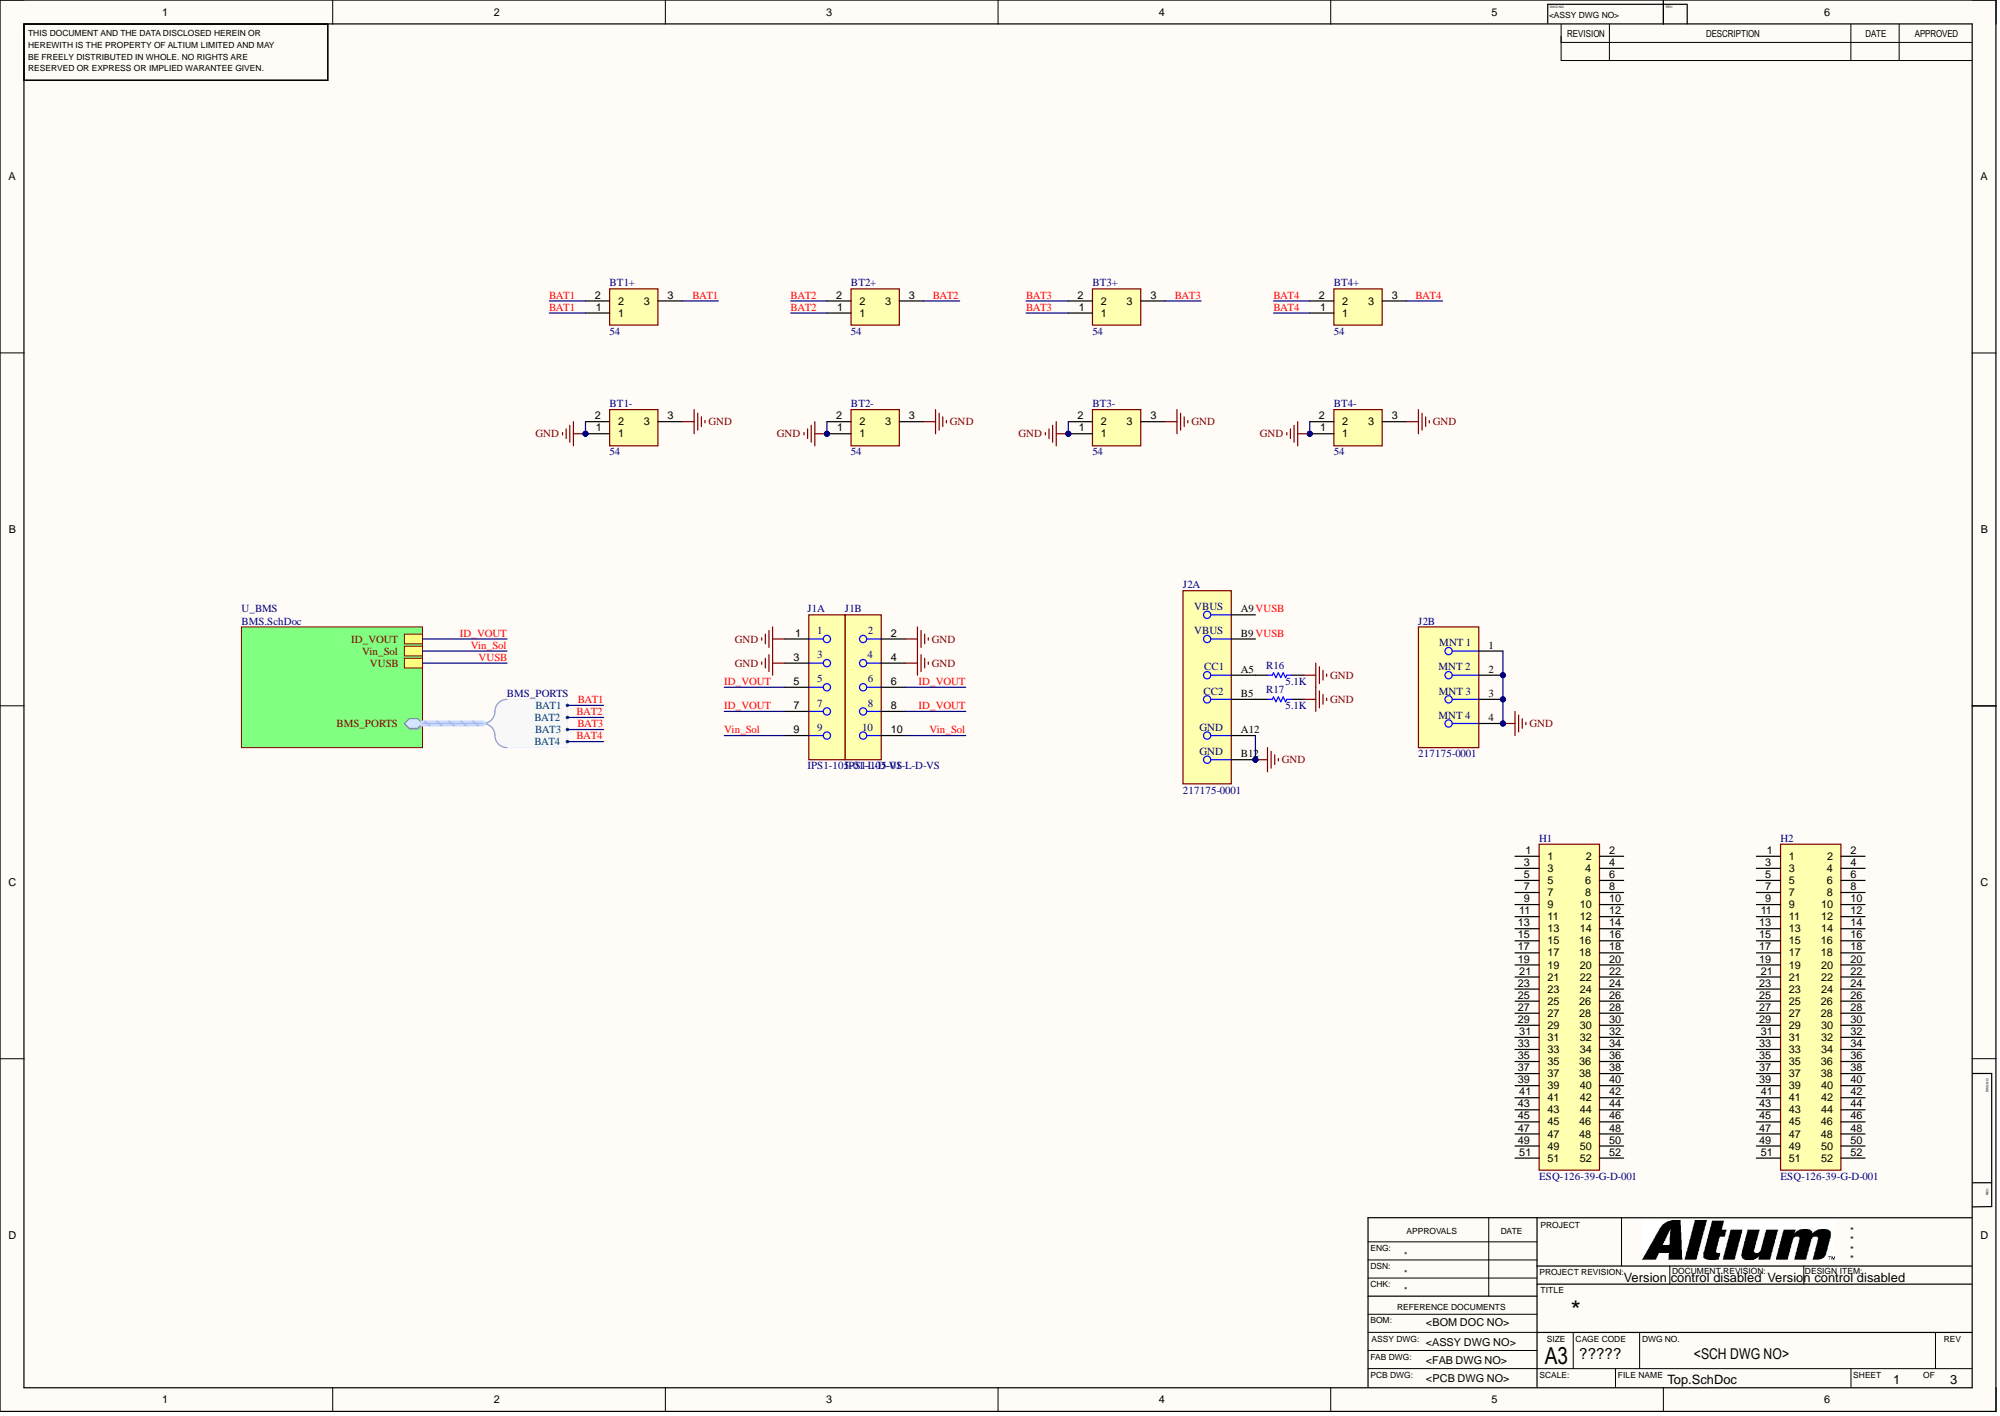
[picture p31: page 1]
<SCH DWG NO>; SIZE; DWG NO.; FILE NAME; SHEET; CAGE CODE; ASSY DWG:; FAB DWG:; PCB DWG:; <PCB DWG NO>; PROJECT REVISION:; DOCUMENT REVISION:; DESIGN ITEM:; Version; control disabled Version control disabled; MNT 1; MNT 2; MNT 3; MNT 4; BMS_PORTS BAT1

DWG NO: <ASSY DWG NO> | REV:

THIS DOCUMENT AND THE DATA DISCLOSED HEREIN OR HEREWITH IS THE PROPERTY OF ALTIUM LIMITED AND MAY BE FREELY DISTRIBUTED IN WHOLE. NO RIGHTS ARE RESERVED OR EXPRESS OR IMPLIED WARANTEE GIVEN. | BT1+ BT2+ BT3+ BT4+ | REVISION | DESCRIPTION | DATE | APPROVED

DWG NO: REV:

DATE | PROJECT | * * APPROVALS * *

ENG: *

DSN: *

CHK: *

REFERENCE DOCUMENTS
<BOM DOC NO>

<FAB DWG NO>

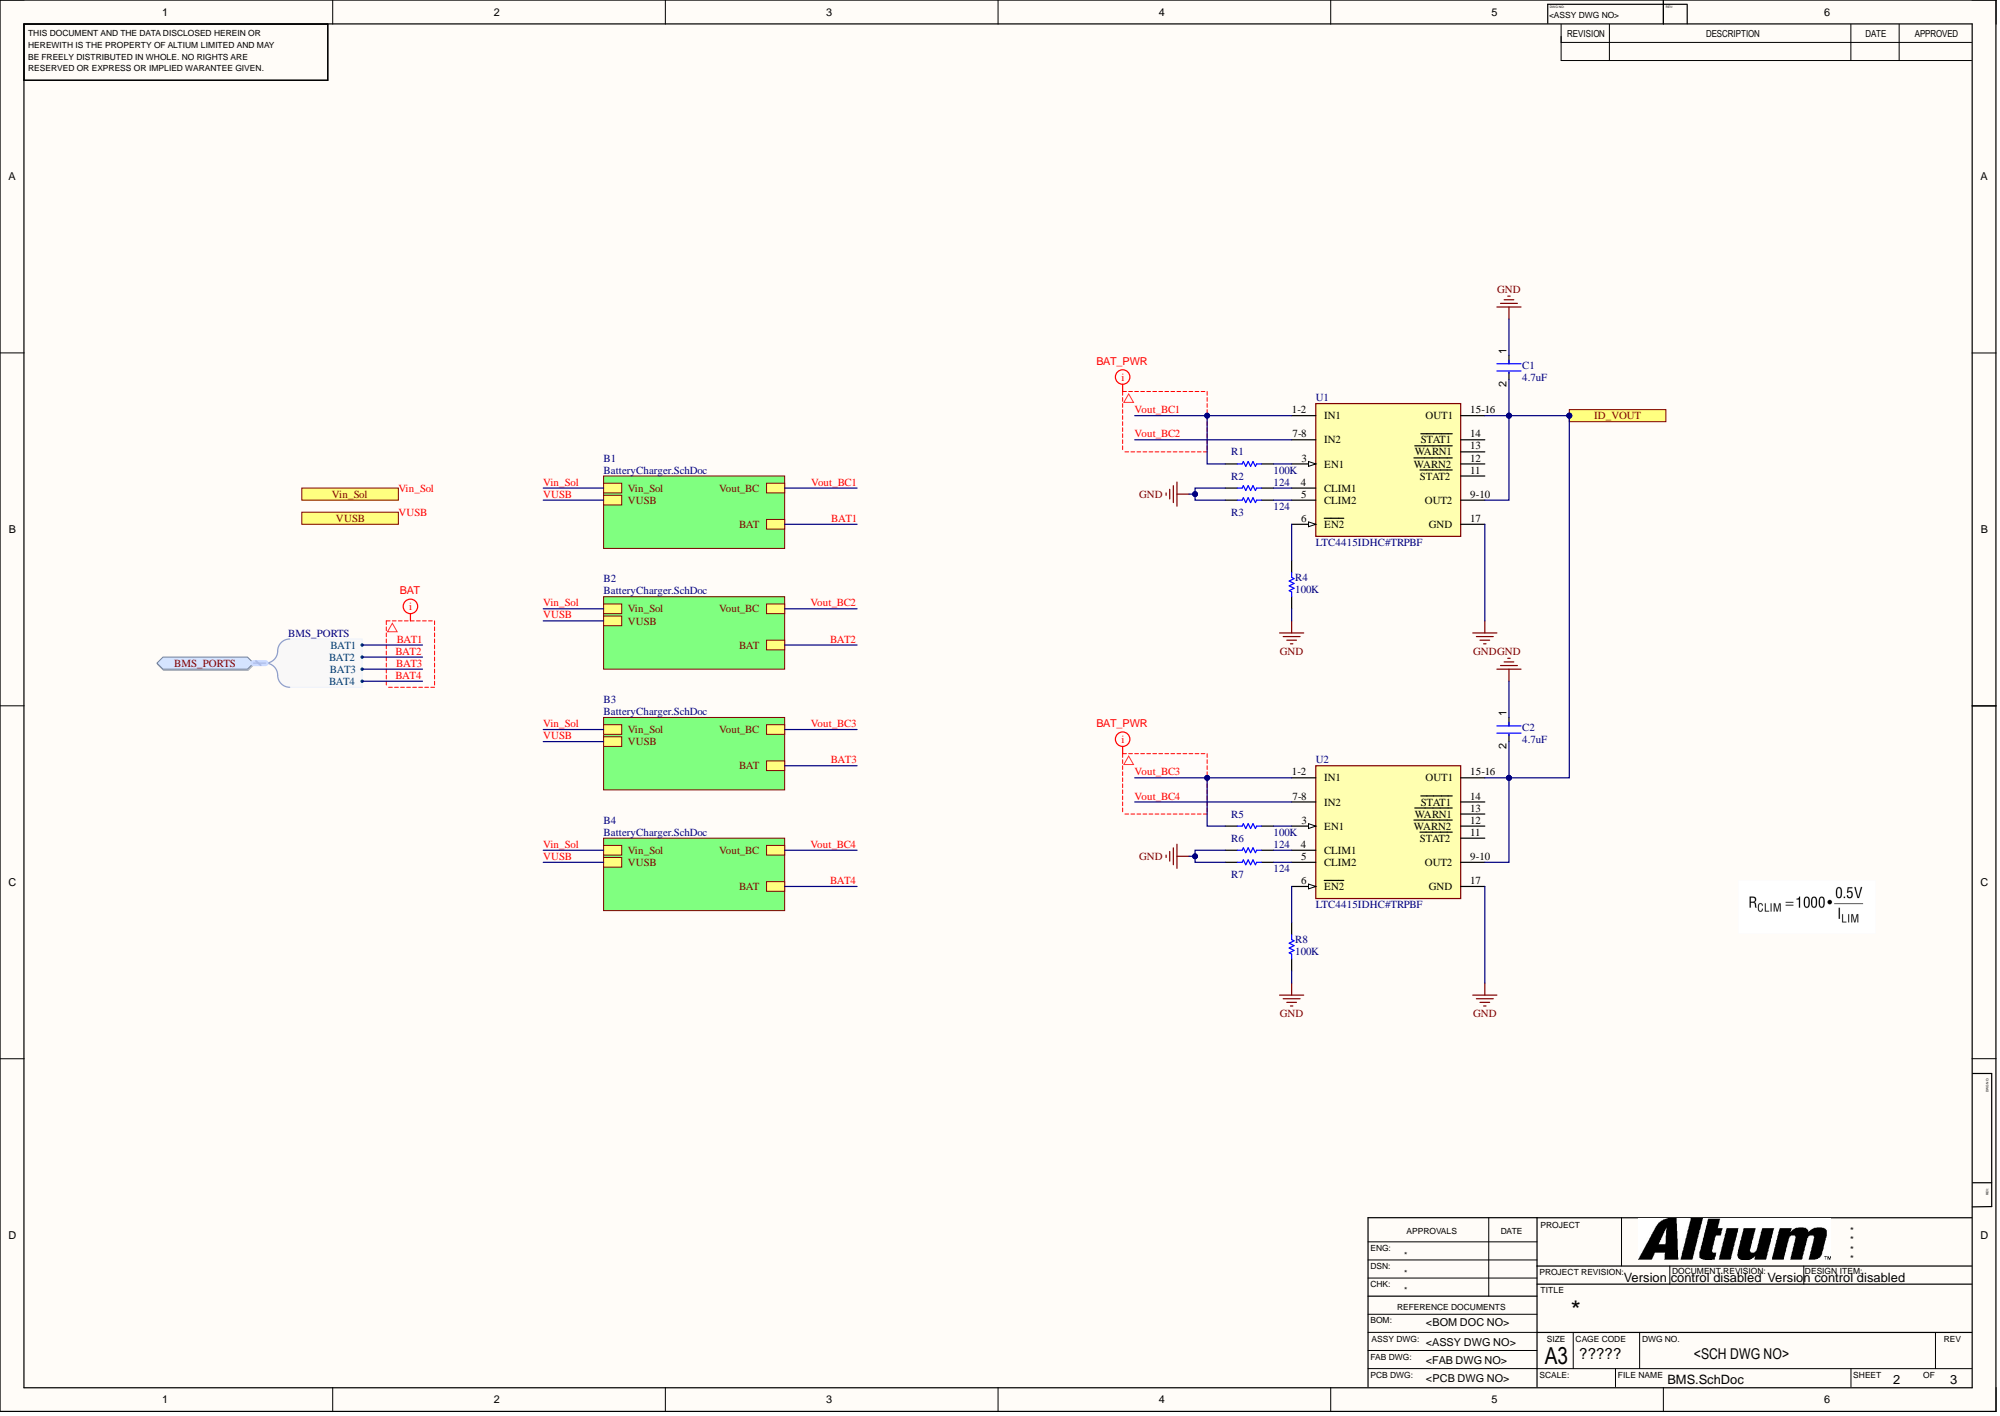
[picture p32: page 2]

D W G N O : <ASSY DWG NO > | R E V :

THIS DOCUMENT AND THE DA TA DISCL OSED HEREIN O R HEREWITH IS THE PROPERTY OF ALTIUM LIMITED AND M AY BE FREELY DISTRIBUTED IN WHO LE. NO RIGHTS ARE | G N D | REVISI O N | DESCRIPTI O N | DATE | APPROVED

DATE | PRO JECT | **** APPROVALS

ENG :
** DSN:

CHK: *

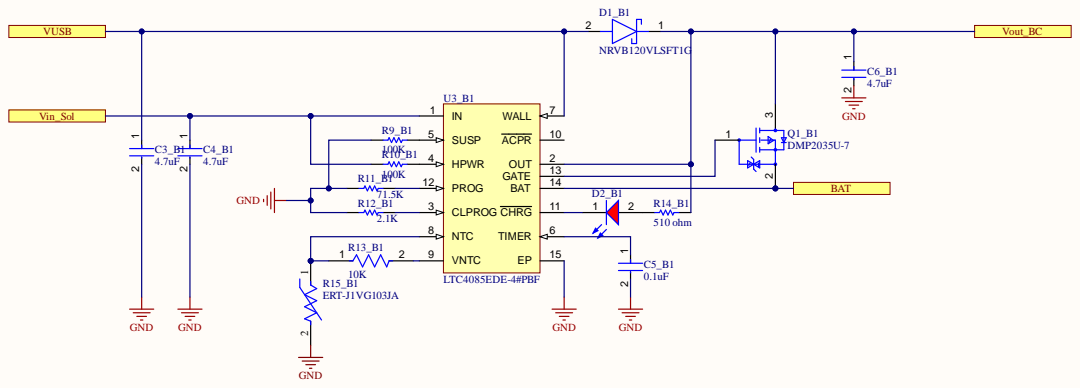
[picture p33: page 3]
PROJECT REVISION:; DOCUMENT REVISION:; DESIGN ITEM:; Version; control disabled Version control disabled; CLPROG 3; HPWR 4; SUSP 5; NTC 8; VNTC 9; PROG 12; GATE; 510 ohm; NRVB120VLSFT1G; 71.5K GND

DWG NO: REV:

DATE | PROJECT | * * APPROVALS * *

ENG: *

DSN: *

CHK: *

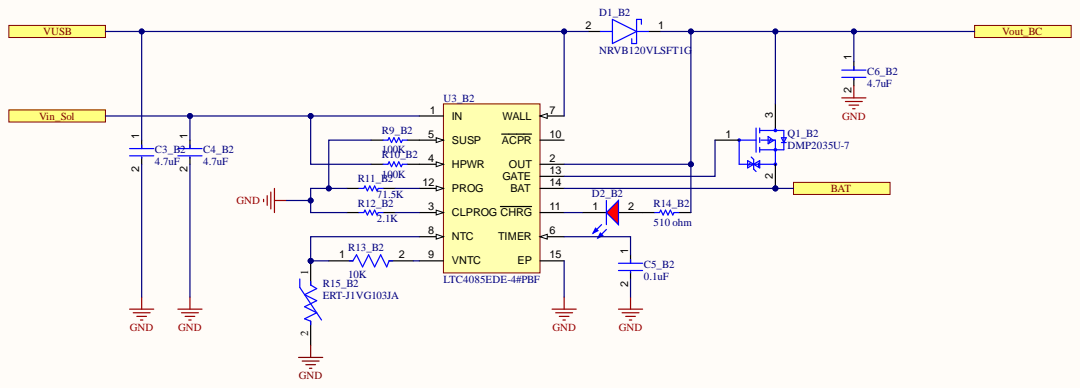
[picture p34: page 4]
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

DWG NO: REV:

DATE | PROJECT | * * APPROVALS * *

ENG: *

DSN: *

CHK: *

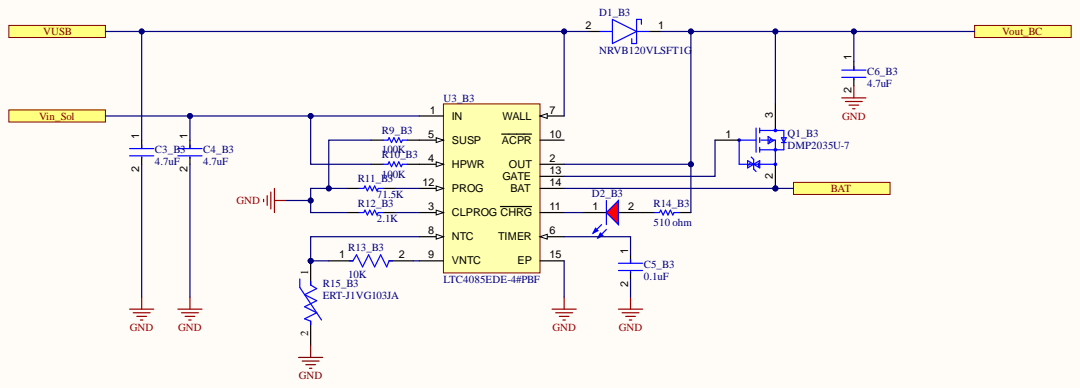
[picture p35: page 5]
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

DWG NO: REV:

DATE | PROJECT | * * APPROVALS * *

ENG: *

DSN: *

CHK: *

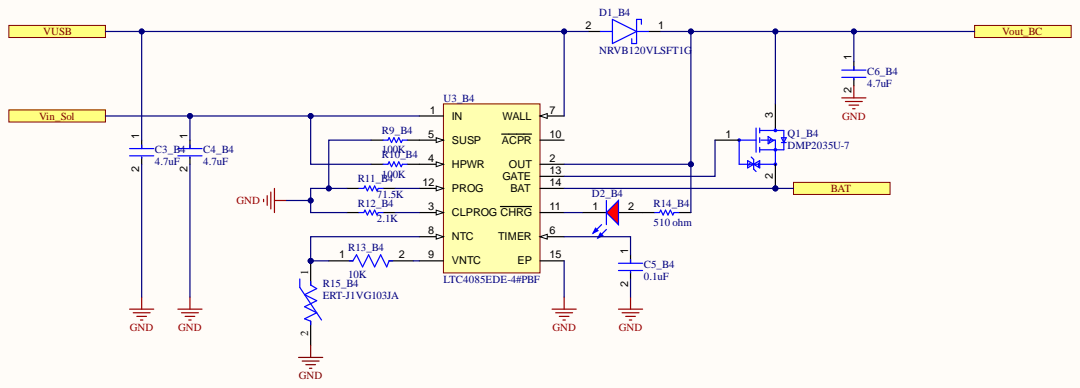
[picture p36: page 6]
<SCH DWG NO; SIZE; DWG NO; FILE NAM; ASSY DWG; FAB DWG; PCB DWG; JECT REVISION:; DOCUMENT REVISION:; DESIGN ITEM; Version; control disabled; GAT

D W G N O : <ASSY DWG NO > | R E V :

THIS DOCUMENT AND THE DA TA DISCL OSED HEREIN O R HEREWITH IS THE PROPERTY OF ALTIUM LIMITED AND M AY BE FREELY DISTRIBUTED IN WHO LE. NO RIGHTS ARE | | REVISI O N | DESCRIPTI O N | DATE | APPROVED

A DWG NO: REV:

DATE | PRO JECT | **** APPROVALS

ENG :
** DSN:

CHK: *

Version control disabled
