hiteshbhoyar03/Cubesat/Schematic On board Computer.pdf

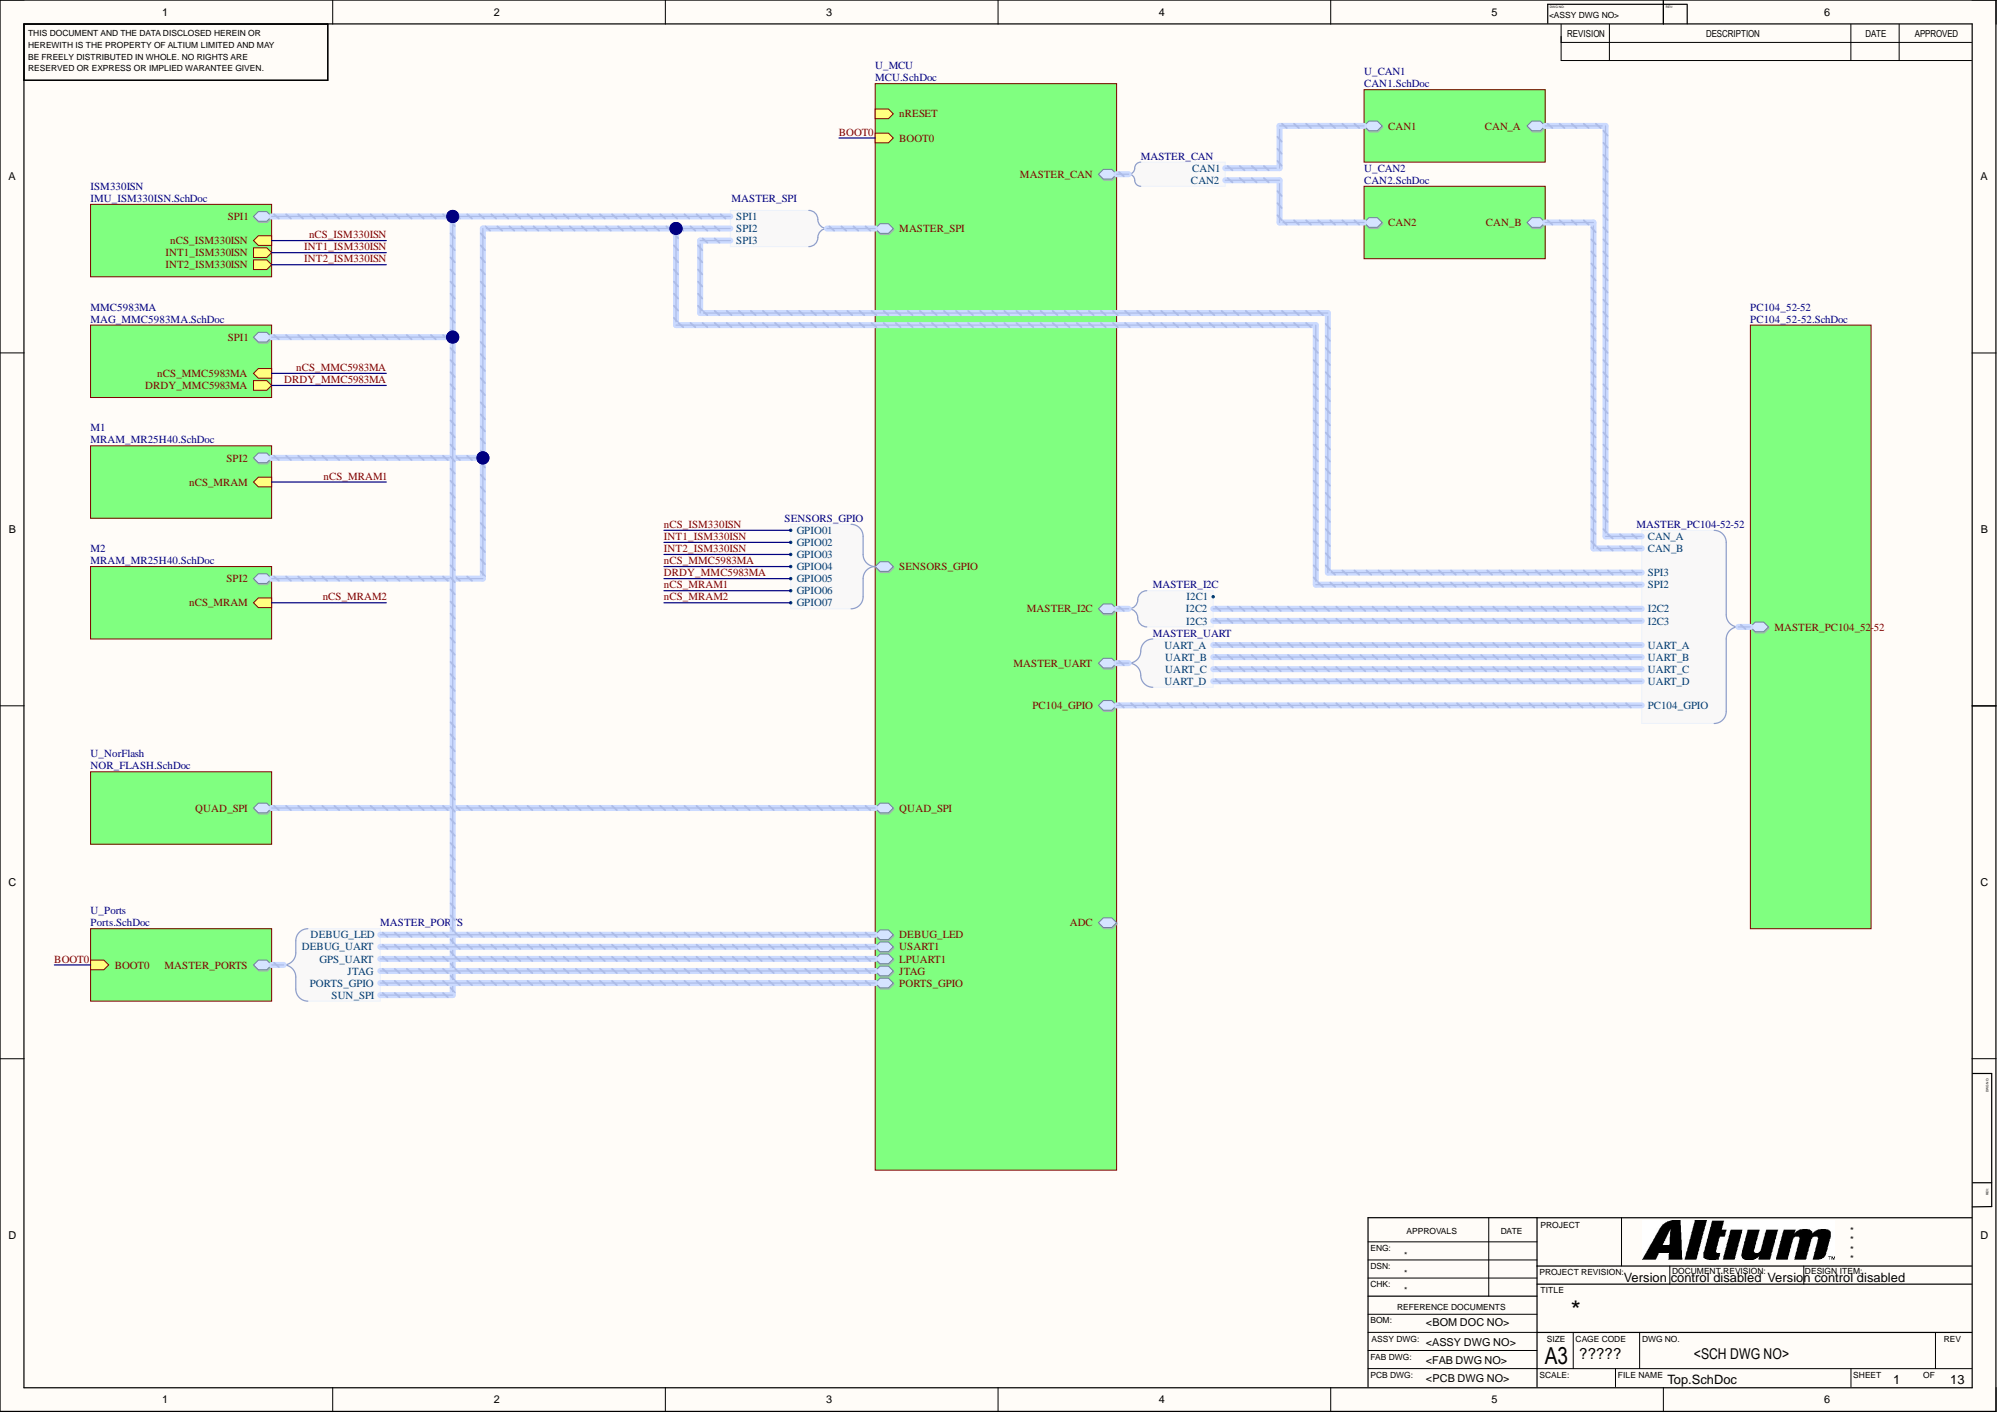
[picture p37: page 1]
<SCH DWG NO>; SIZE; DWG NO.; FILE NAME; SHEET; CAGE CODE; ASSY DWG:; FAB DWG:; PCB DWG:; <PCB DWG NO>; PROJECT REVISION:; DOCUMENT REVISION:; DESIGN ITEM:; Version; control disabled Version control disabled; SENSORS_GPIO nCS_ISM330ISN; NLBOOT0 BOOT0

DWG NO: <ASSY DWG NO> | REV:

THIS DOCUMENT AND THE DATA DISCLOSED HEREIN OR HEREWITH IS THE PROPERTY OF ALTIUM LIMITED AND MAY BE FREELY DISTRIBUTED IN WHOLE. NO RIGHTS ARE RESERVED OR EXPRESS OR IMPLIED WARANTEE GIVEN. | U_MCU MCU.SchDoc | REVISION | DESCRIPTION | DATE | APPROVED

DWG NO: REV:

DATE | PROJECT | * * APPROVALS * *

ENG: *

DSN: *

CHK: *

REFERENCE DOCUMENTS
<BOM DOC NO>

<FAB DWG NO>

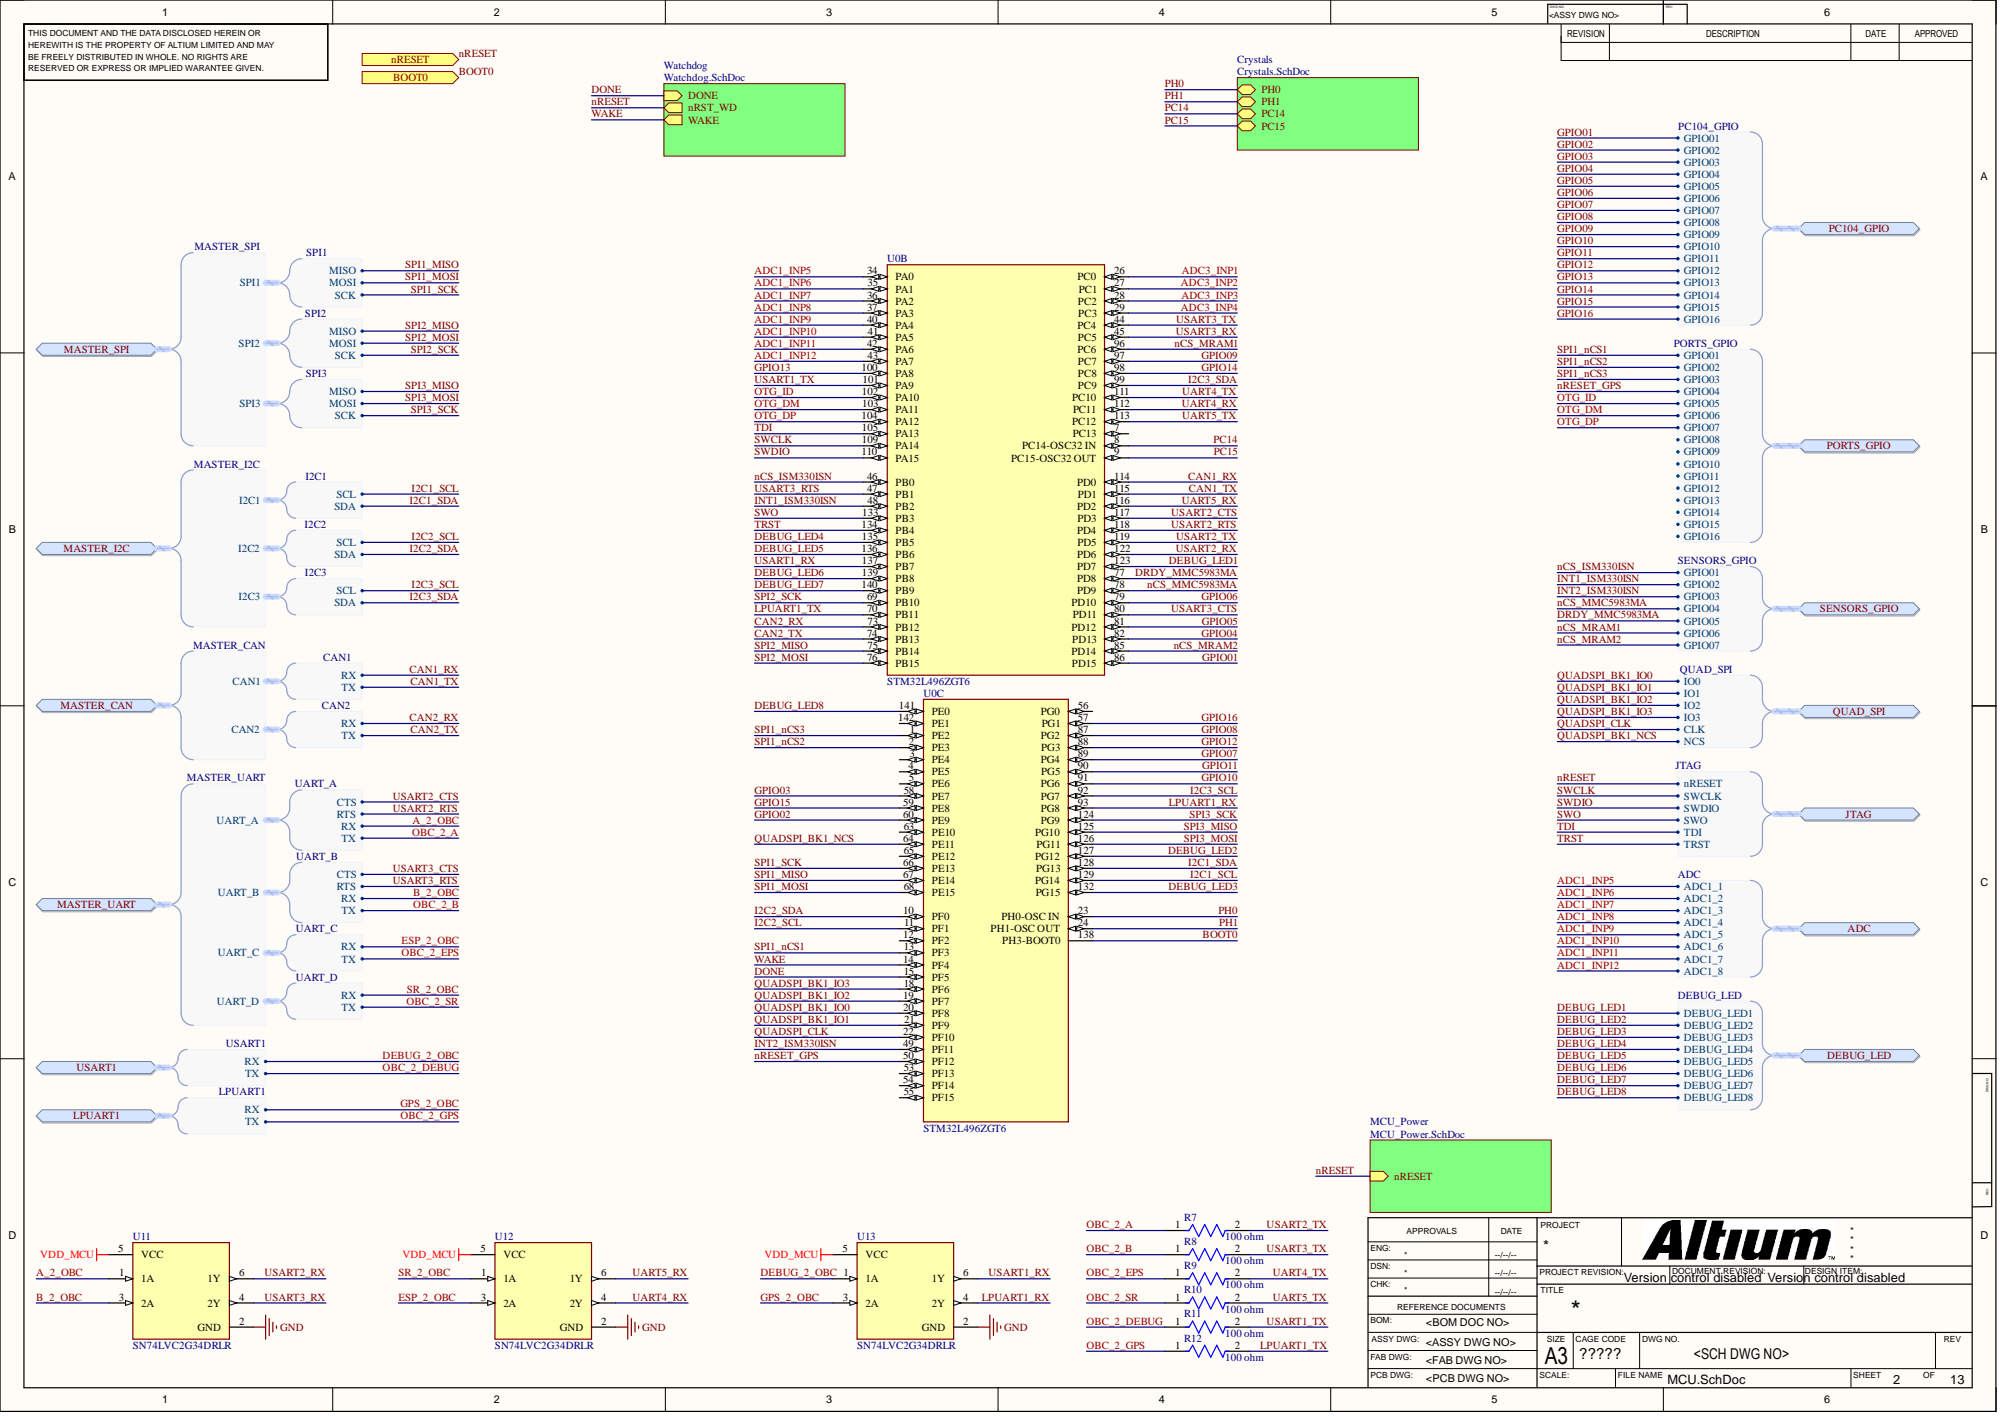
[picture p38: page 2]

D W G N O : <ASSY DWG NO > | E V

THIS DOCUMENT AND THE DA TA DISCL OSED HEREIN O R HEREWITH IS THE PROPERTY OF ALTIUM LIMITED AND M AY BE FREELY DISTRIBUTED IN WHO LE. NO RIGHTS ARE | Watch d o g Cry s tal s.Sc h o c | REVISI N | DESCRIPTI N | DATE | APPROVED

DATE | PRO JECT * | **** APPROVALS

** DSN: | --/--/--

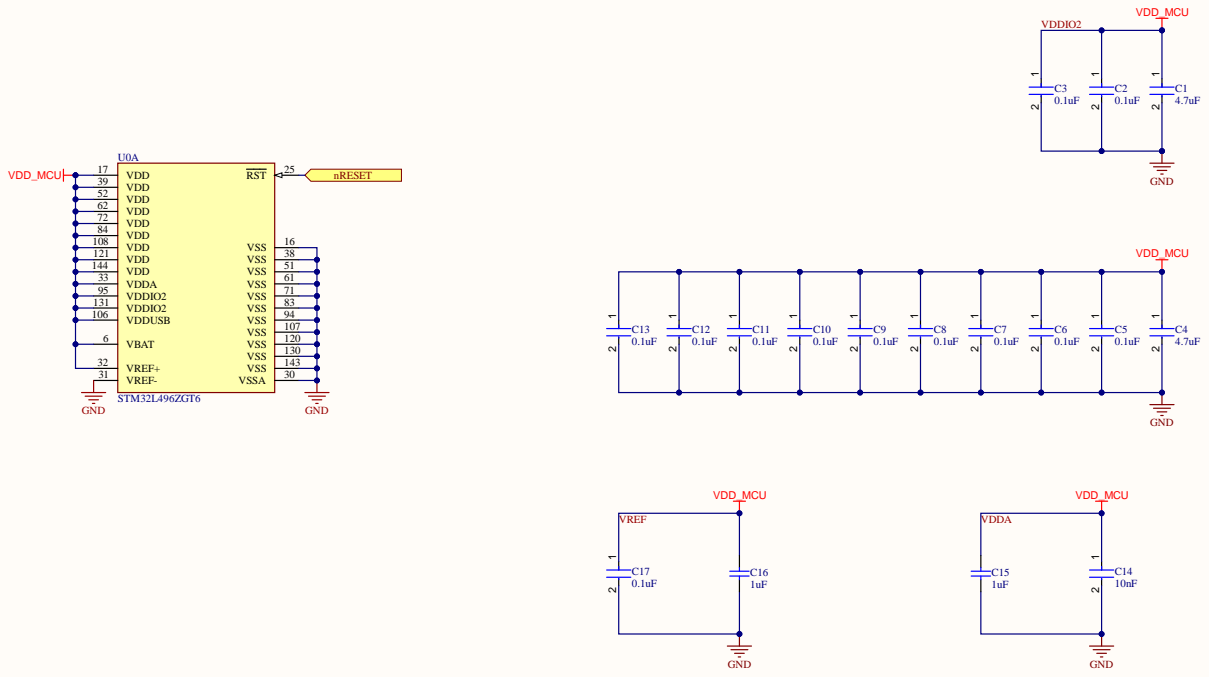
[picture p39: page 3]

DATE | PROJECT | * * APPROVALS * *

ENG: *

DSN: *

CHK: *

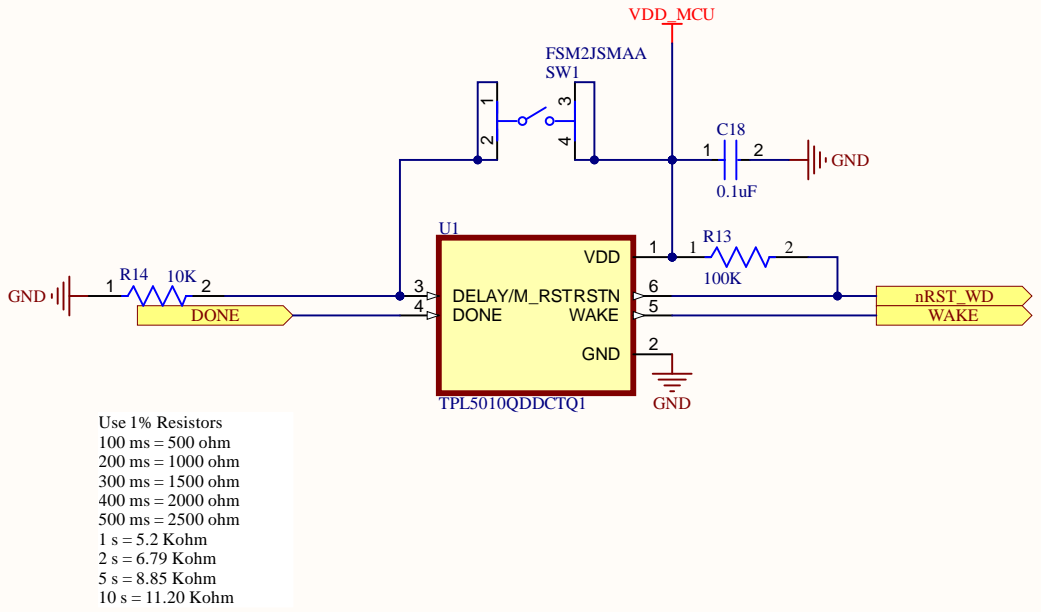
[picture p40: page 4]
PROJECT REVISION:; DOCUMENT REVISION:; DESIGN ITEM:; Version; control disabled Version control disabled; DELAY/M_RST 3 DONE 4; Use 1% Resistors 100 ms = 500 ohm 200 ms = 1000 ohm 300 ms = 1500 ohm 400 ms = 2000 ohm 500 ms = 2500 ohm 1 s = 5.2 Kohm 2 s = 6.79 Kohm 5 s = 8.85 Kohm 10 s = 11.20 Kohm

DWG NO: REV:

DATE | PROJECT | * * APPROVALS * *

ENG: *

DSN: *

CHK: *

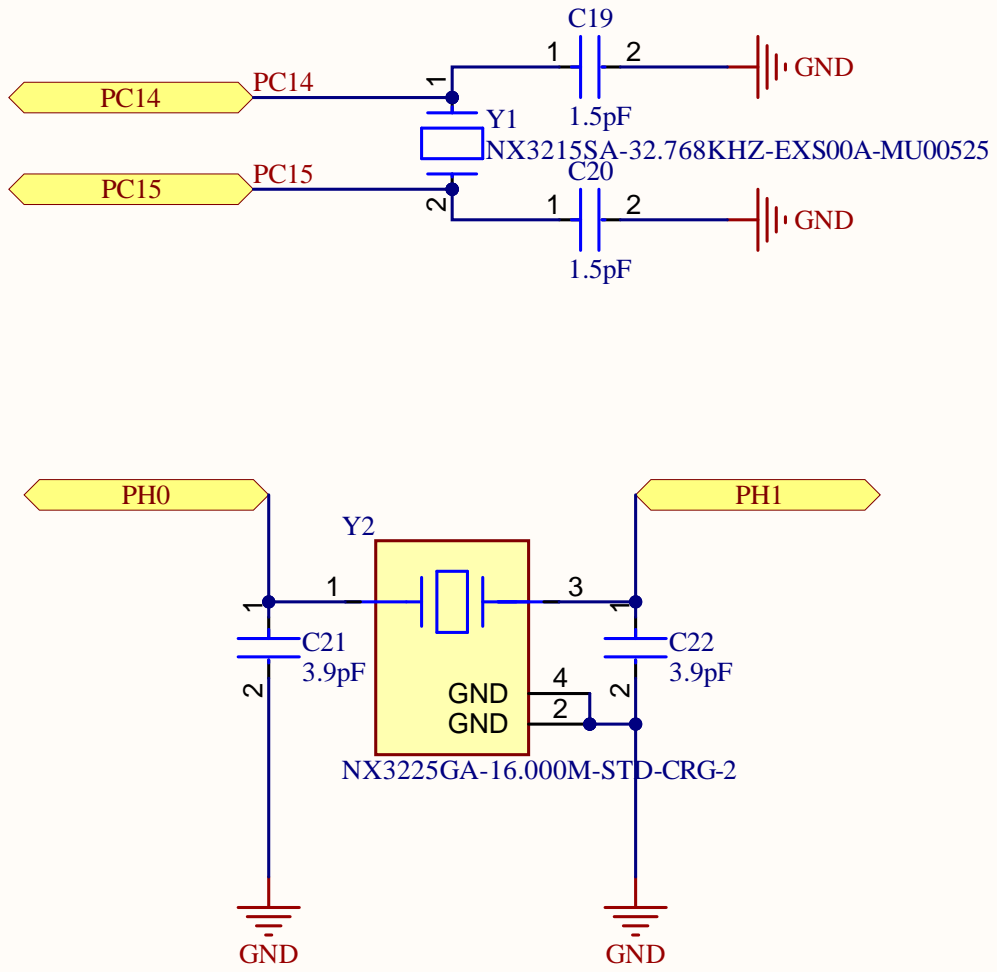
[picture p41: page 5]
PROJECT REVISION:; DOCUMENT REVISION:; DESIGN ITEM:; Version; control disabled Version control disabled; GND; 2 GND

DWG NO: REV:

DATE | PROJECT | * * APPROVALS * *

ENG: *

DSN: *

CHK: *

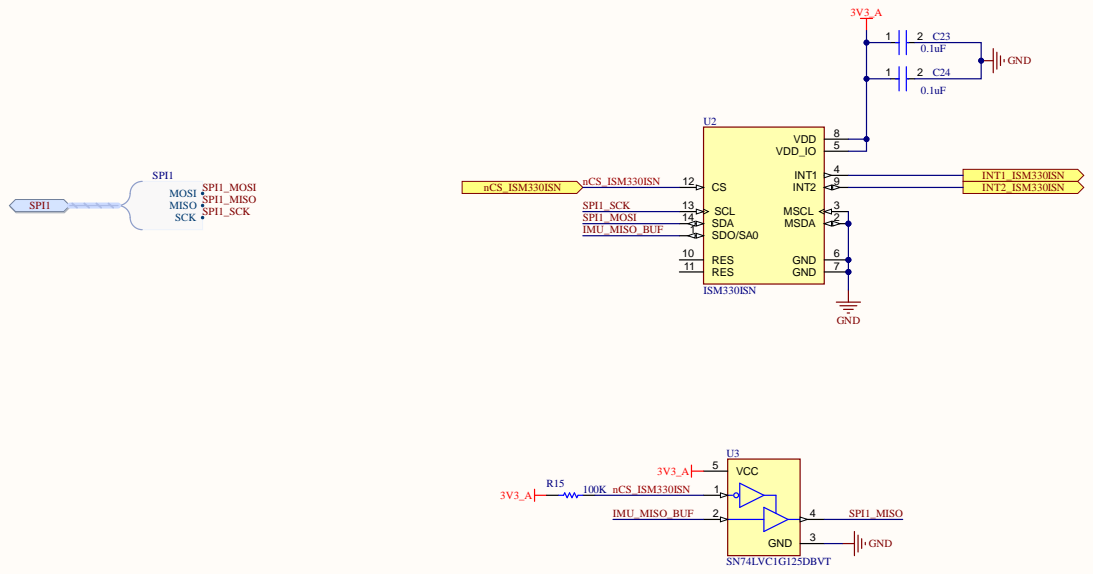
[picture p42: page 6]
PROJECT REVISION:; DOCUMENT REVISION:; DESIGN ITEM:; Version; control disabled Version control disabled; nCS_ISM330ISN; INT2_ISM330ISN 12; SCL 13 SDA 14 SDO/SA0 1; RES 10 RES 11; VCC 5

DWG NO: REV:

DATE | PROJECT | * * APPROVALS * *

ENG: *

DSN: *

CHK: *

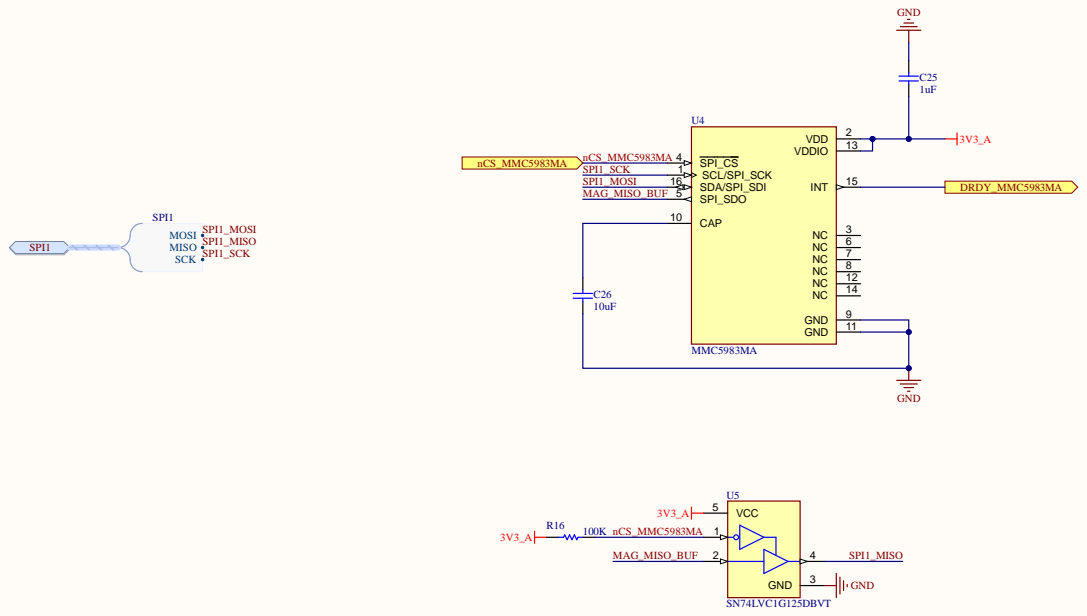
[picture p43: page 7]
PROJECT REVISION:; DOCUMENT REVISION:; DESIGN ITEM:; Version; control disabled Version control disabled; DRDY_MMC5983MA SPI1_MOSI; SPI_CS 4 SCL/SPI_SCK 1 SDA/SPI_SDI 16 SPI_SDO 5; CAP 10; VCC 5

DWG NO: REV:

DATE | PROJECT | * * APPROVALS * *

ENG: *

DSN: *

CHK: *

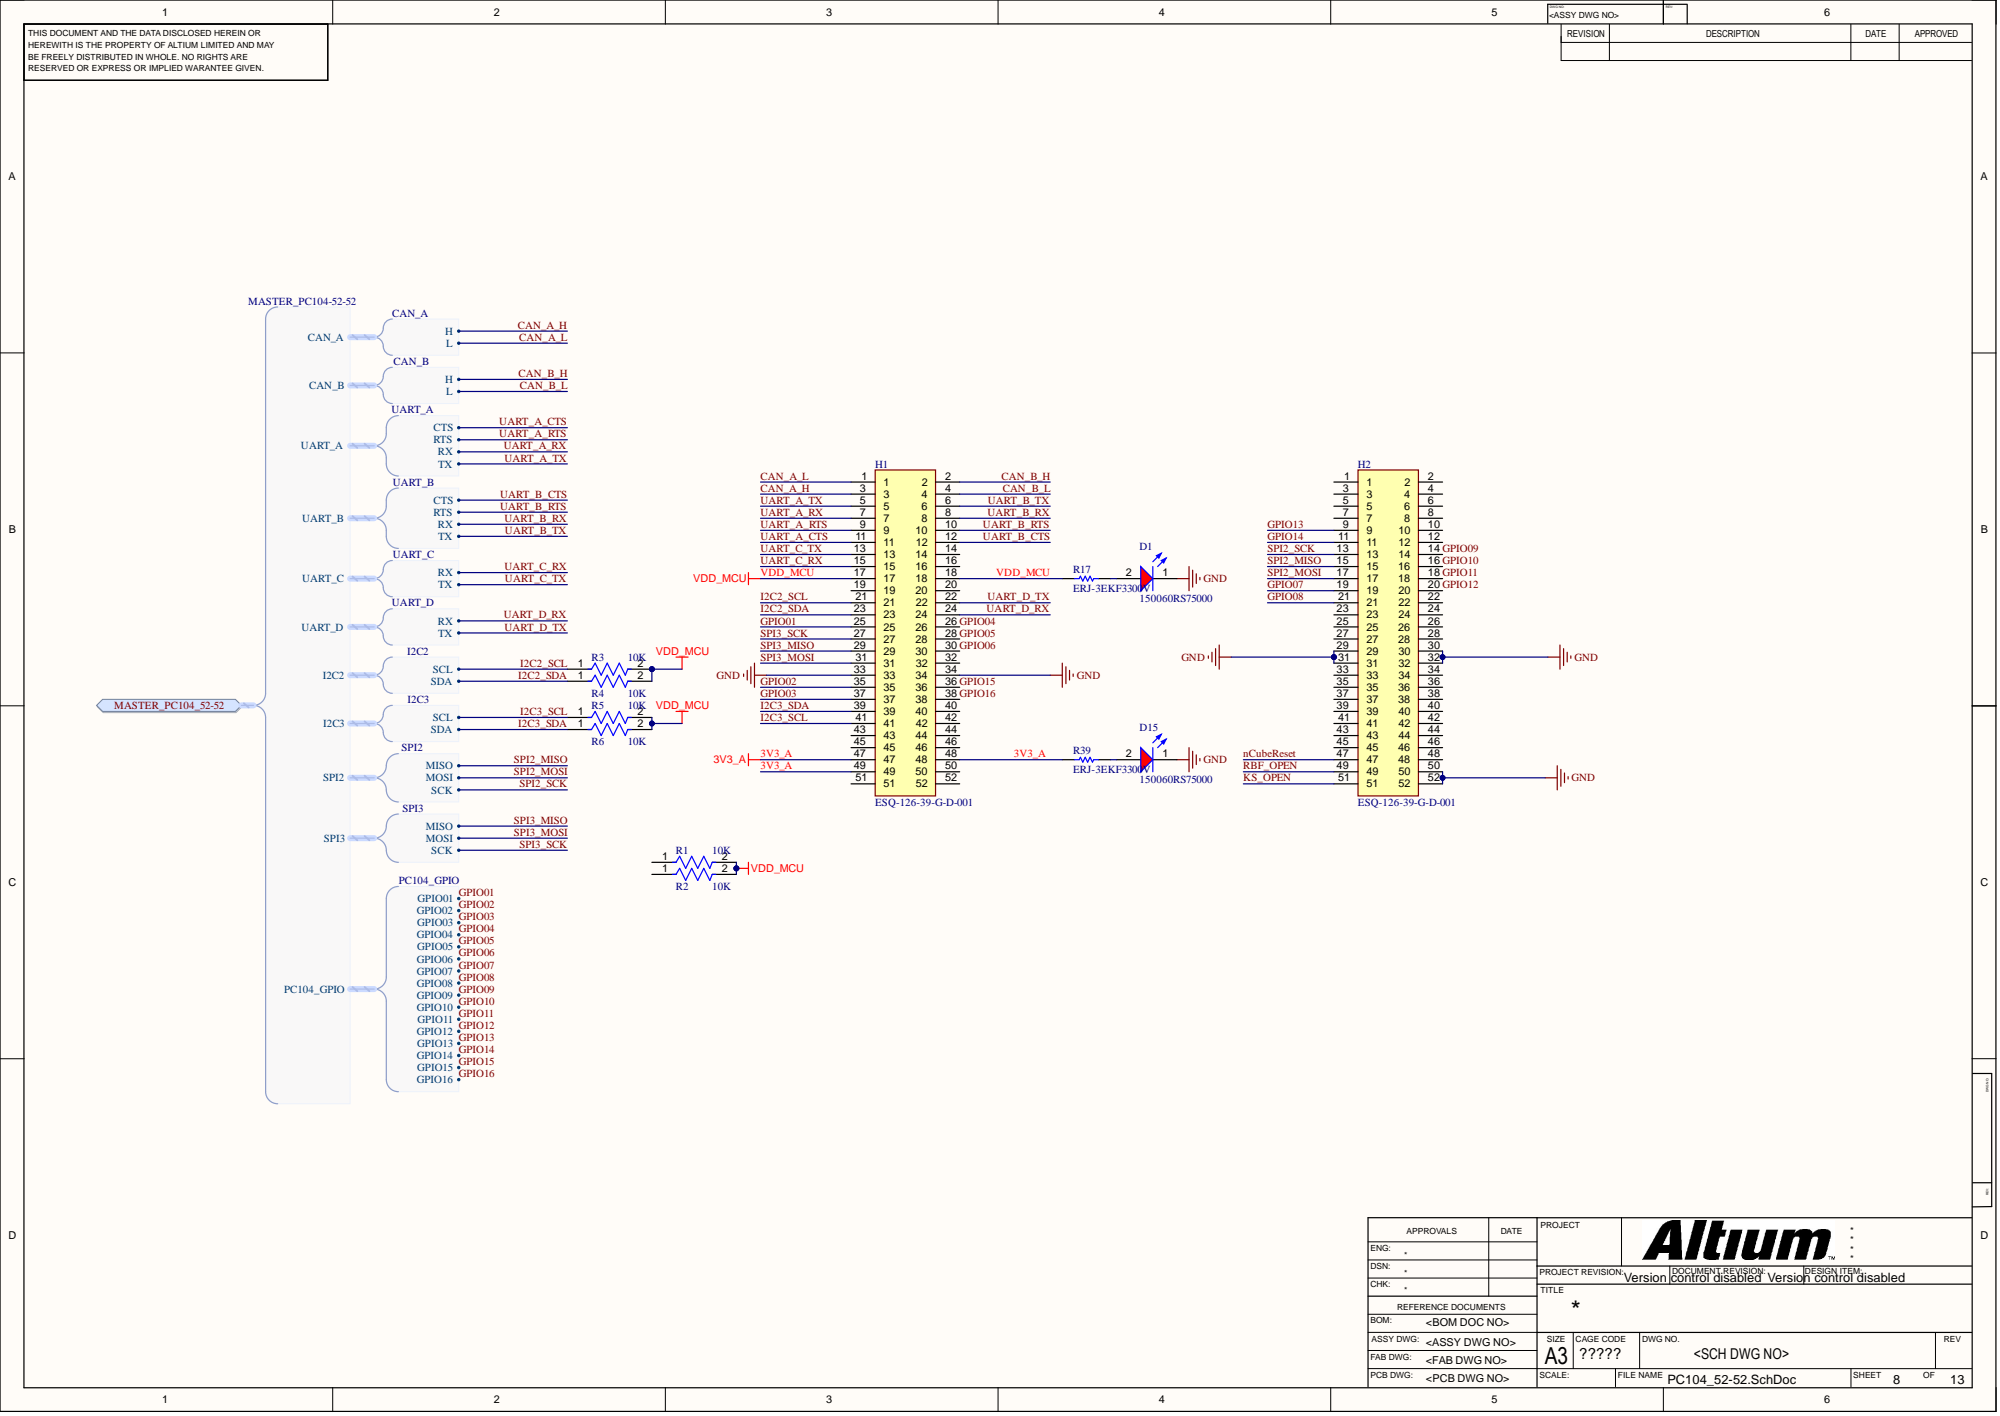
[picture p44: page 8]
JECT REVISION:; DOCUMENT REVISION:; DESIGN ITEM; Version; control disabled; RX RTS

A DWG NO: REV:

DATE | PRO JECT | **** APPROVALS

ENG :
** DSN:

CHK: *

Version control disabled

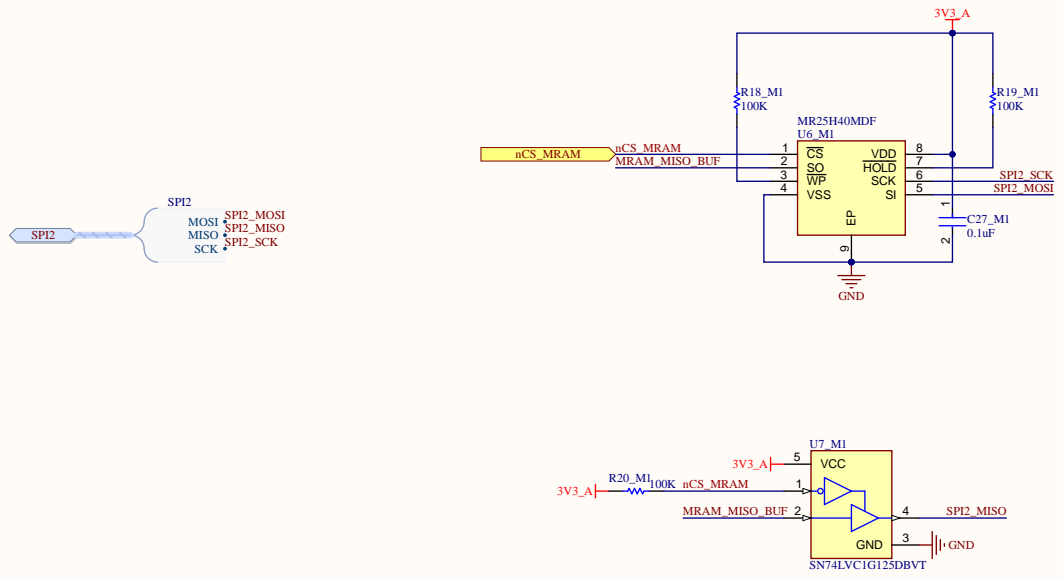
[picture p45: page 9]
PROJECT REVISION:; DOCUMENT REVISION:; DESIGN ITEM:; Version; control disabled Version control disabled; nCS_MRAM; SO 2 WP 3 VSS 4; VCC 5

DWG NO: REV:

DATE | PROJECT | * * APPROVALS * *

ENG: *

DSN: *

CHK: *

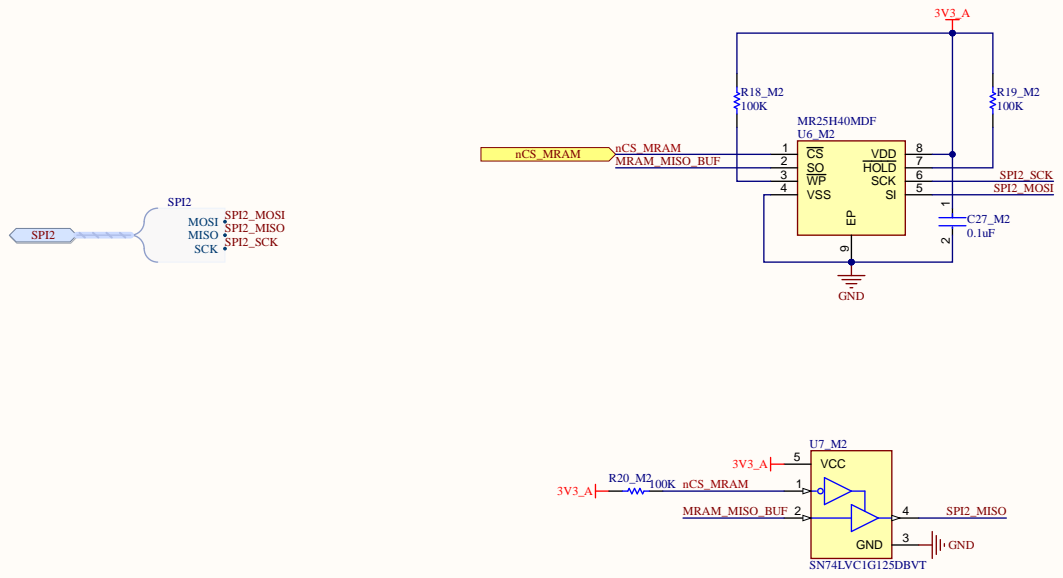
[picture p46: page 10]
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

DWG NO: REV:

DATE | PROJECT | * * APPROVALS * *

ENG: *

DSN: *

CHK: *

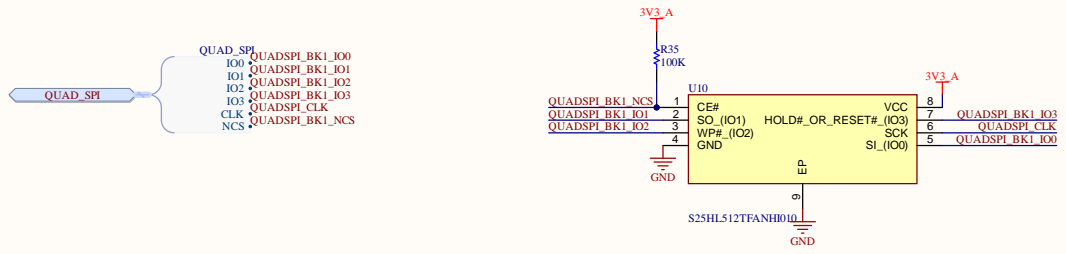
[picture p47: page 11]
JECT REVISION:; DOCUMENT REVISION:; DESIGN ITEM; Version; control disabled

A DWG NO: REV:

DATE | PRO JECT | **** APPROVALS

ENG :
** DSN:

CHK: *

Version control disabled

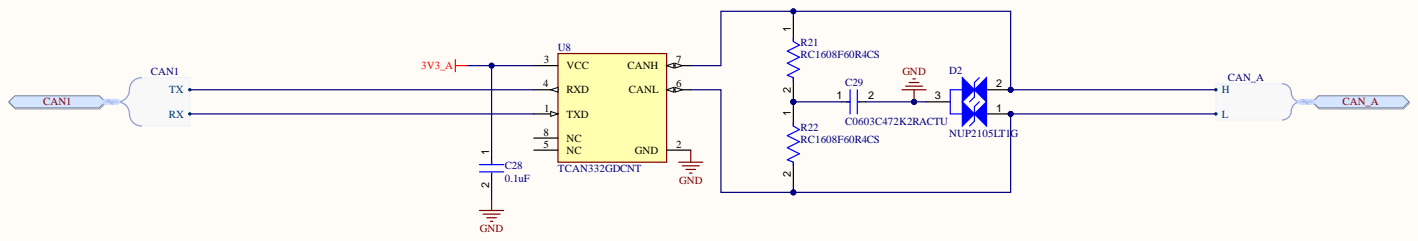
[picture p48: page 12]
JECT REVISION:; DOCUMENT REVISION:; DESIGN ITEM; Version; control disabled; 6 RXD

A DWG NO: REV:

DATE | PRO JECT | **** APPROVALS

ENG :
** DSN:

CHK: *

Version control disabled

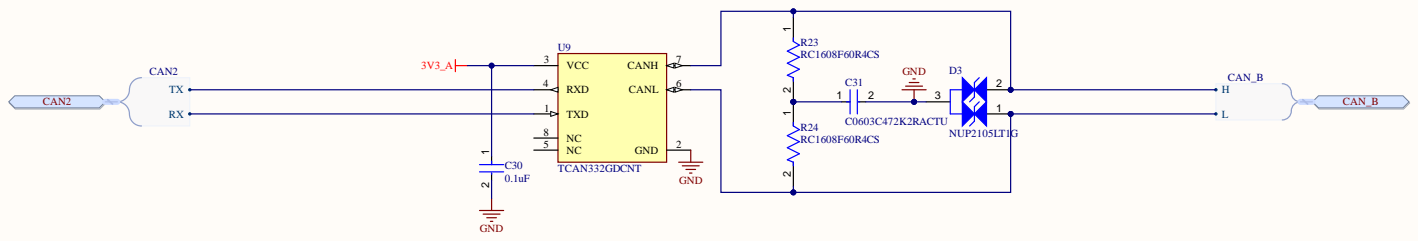
[picture p49: page 13]
JECT REVISION:; DOCUMENT REVISION:; DESIGN ITEM; Version; control disabled; 6 RXD

A DWG NO: REV:

DATE | PRO JECT | **** APPROVALS

ENG :
** DSN:

CHK: *

Version control disabled

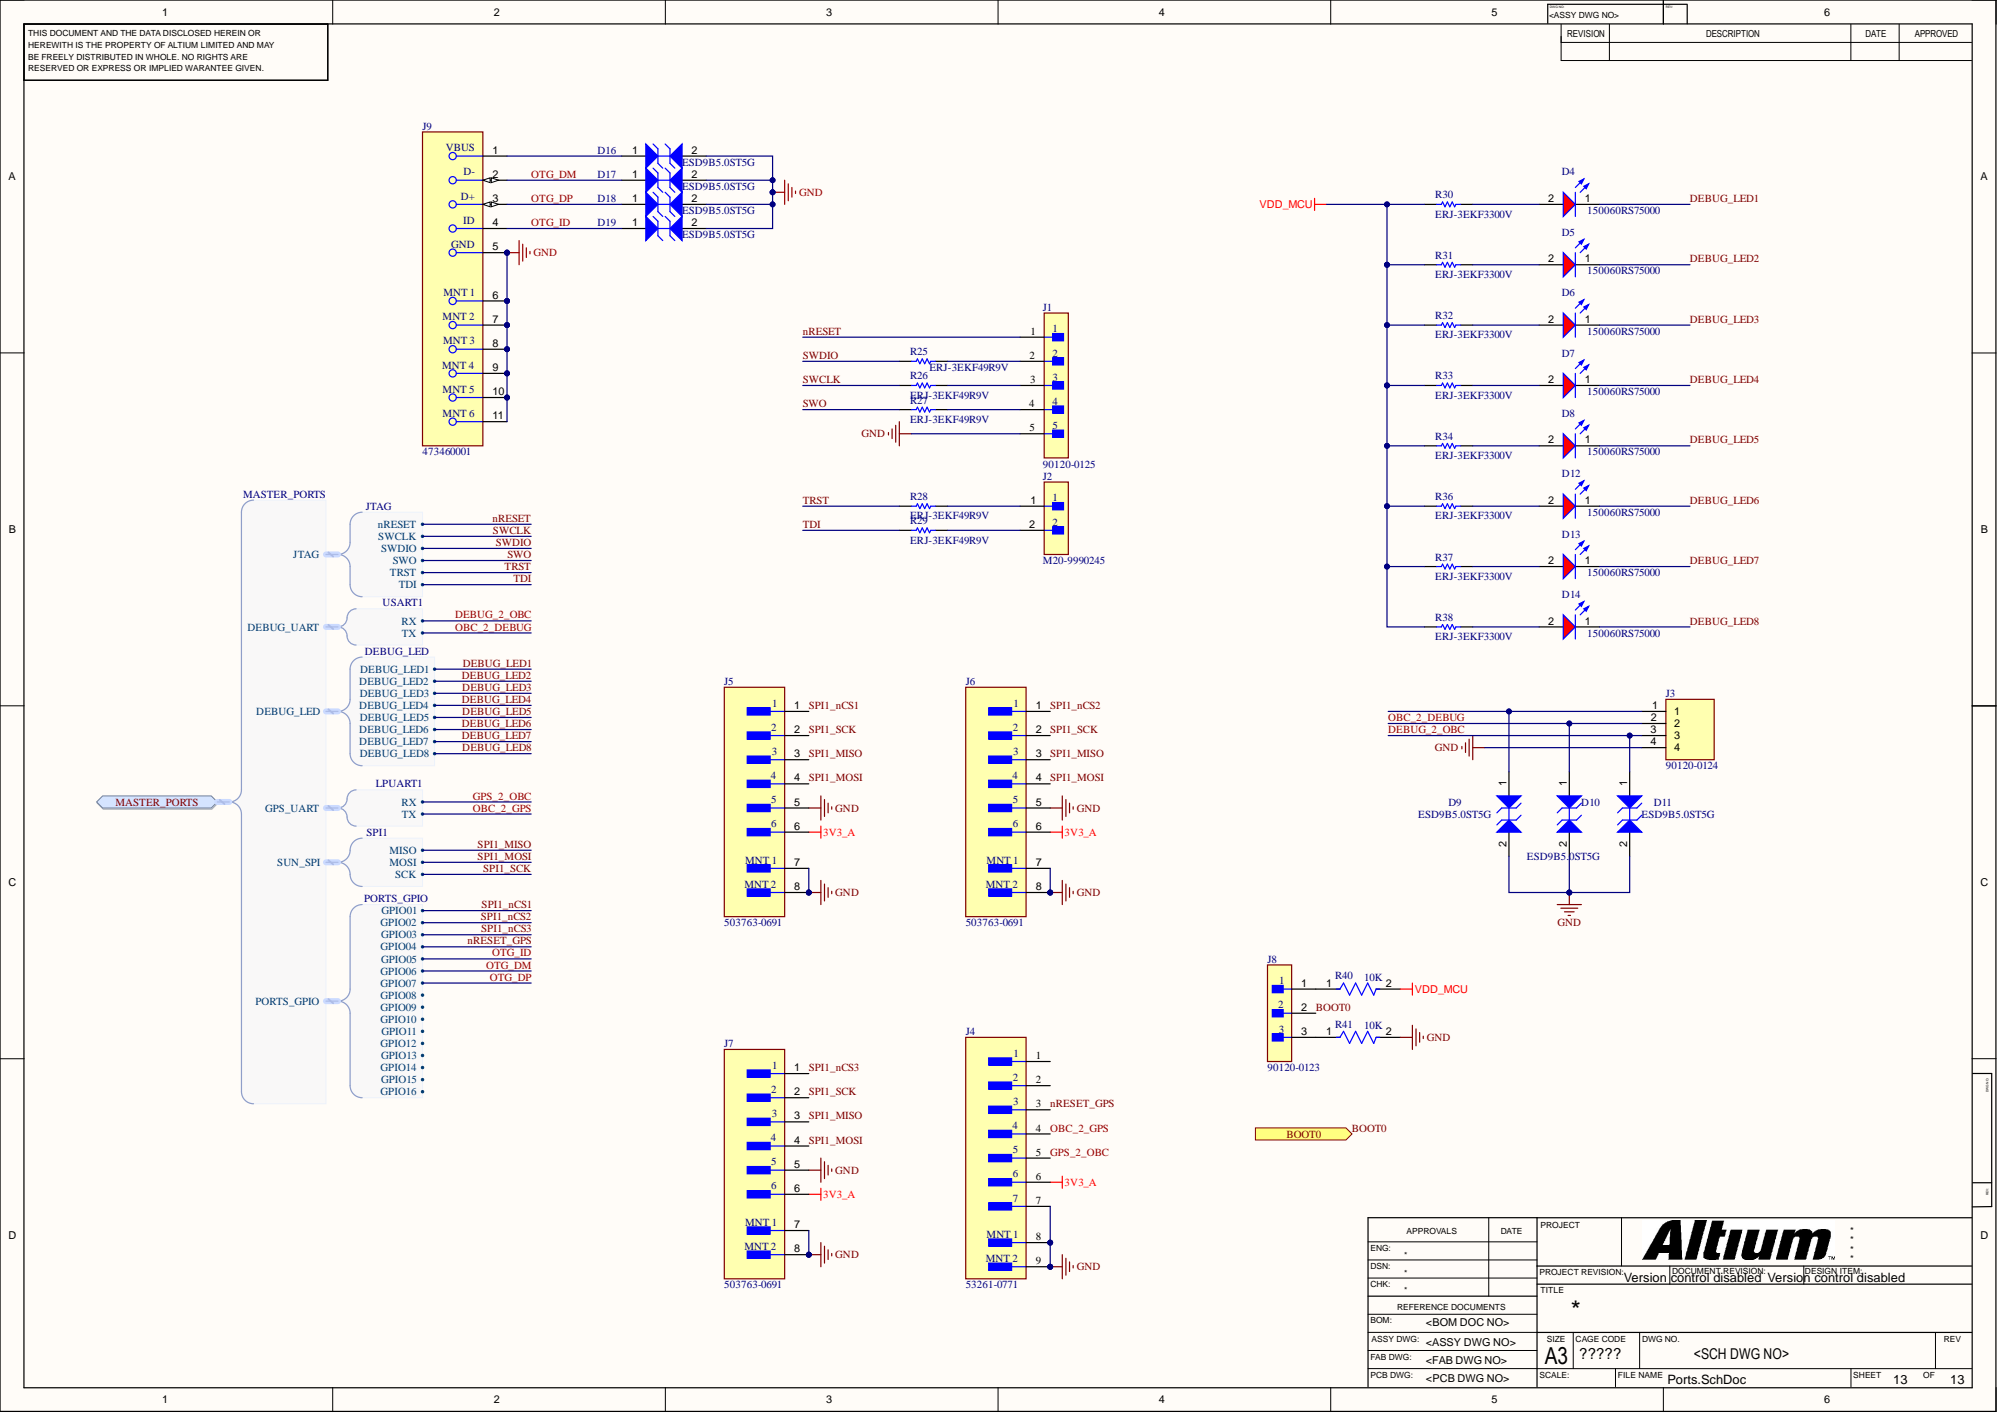
[picture p50: page 14]
JECT REVISION:; DOCUMENT REVISION:; DESIGN ITEM; Version; control disabled; V R29 ERJ-3EKF49R9V; _A GND; 0 BOOT0

A DWG NO: REV:

OBC_ 2 _ D E B U G | 2
D EBU G_ 2 _ O B C | | 3

DATE | PRO JECT | **** APPROVALS

** DSN:

Version control disabled
