hiteshbhoyar03/Cubesat/Schematic EPS.pdf

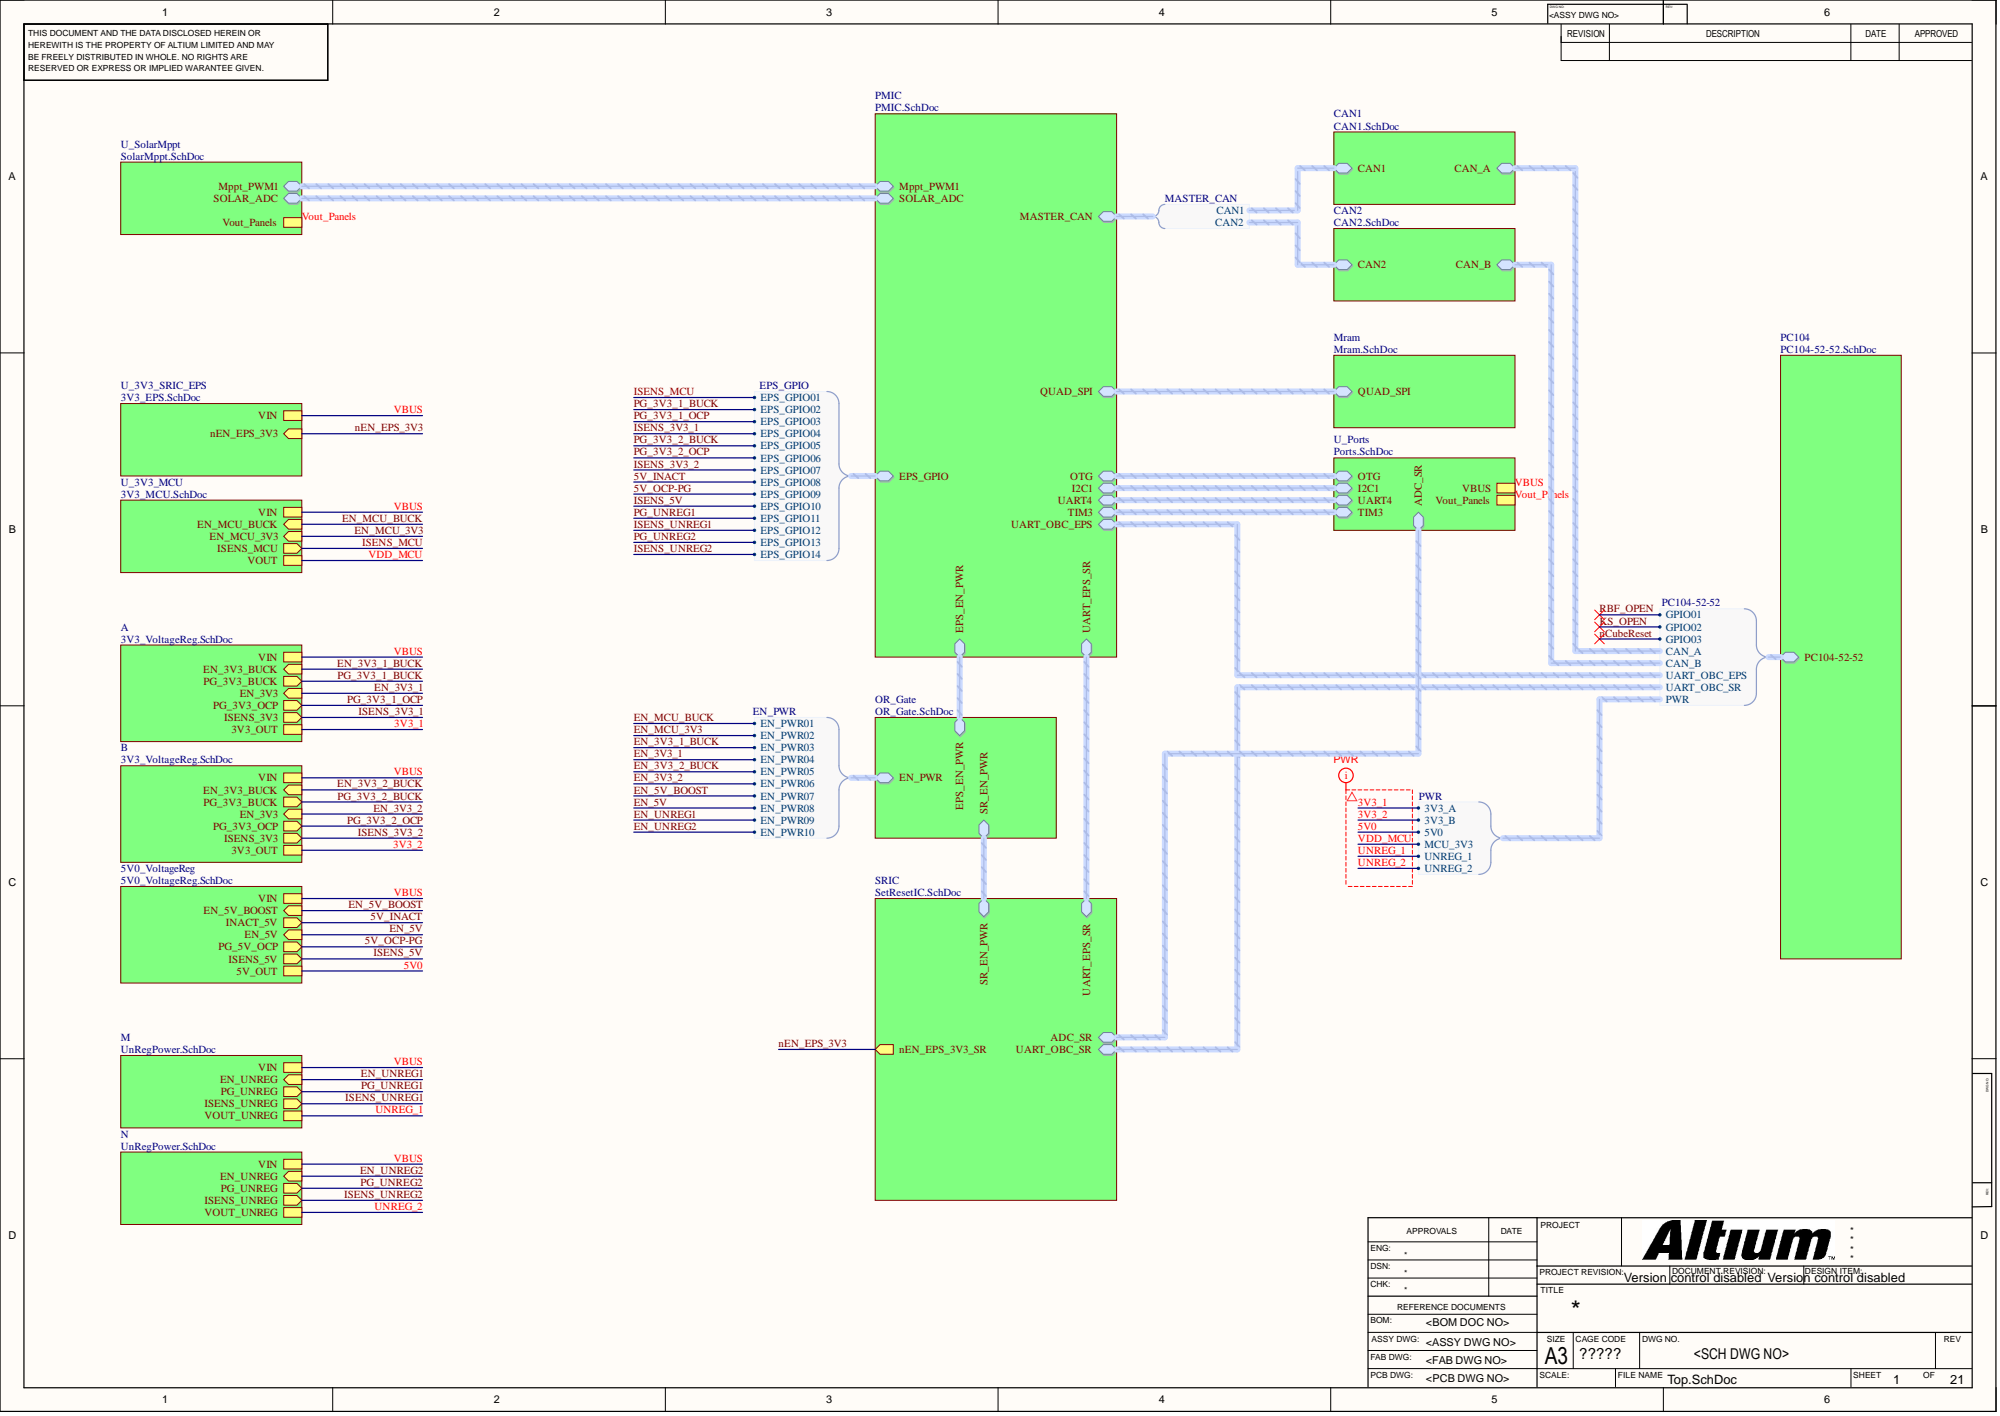
[picture p51: page 1]
<SCH DWG NO; SIZE; DWG NO; FILE NAM; CAGE CODE; REFERENCE DOCUMENTS; ASSY DWG; FAB DWG; PCB DWG; JECT REVISION:; DOCUMENT REVISION:; DESIGN ITEM; Version; control disabled; c EPS; G2 ISENS_MCU

D W G N O : <ASSY DWG NO > | E V

THIS DOCUMENT AND THE DA TA DISCL OSED HEREIN O R HEREWITH IS THE PROPERTY OF ALTIUM LIMITED AND M AY BE FREELY DISTRIBUTED IN WHO LE. NO RIGHTS ARE RESERVED OR EXPRESS OR IMPLIED WARANTEE GIVEN. | PMIC PMIC.Sch o c | REVISI N | DESCRIPTI N | DATE | APPROVED

A DWG NO: REV:

DATE | PRO JECT | **** APPROVALS

ENG :
** DSN:

CHK: *

Version control disabled

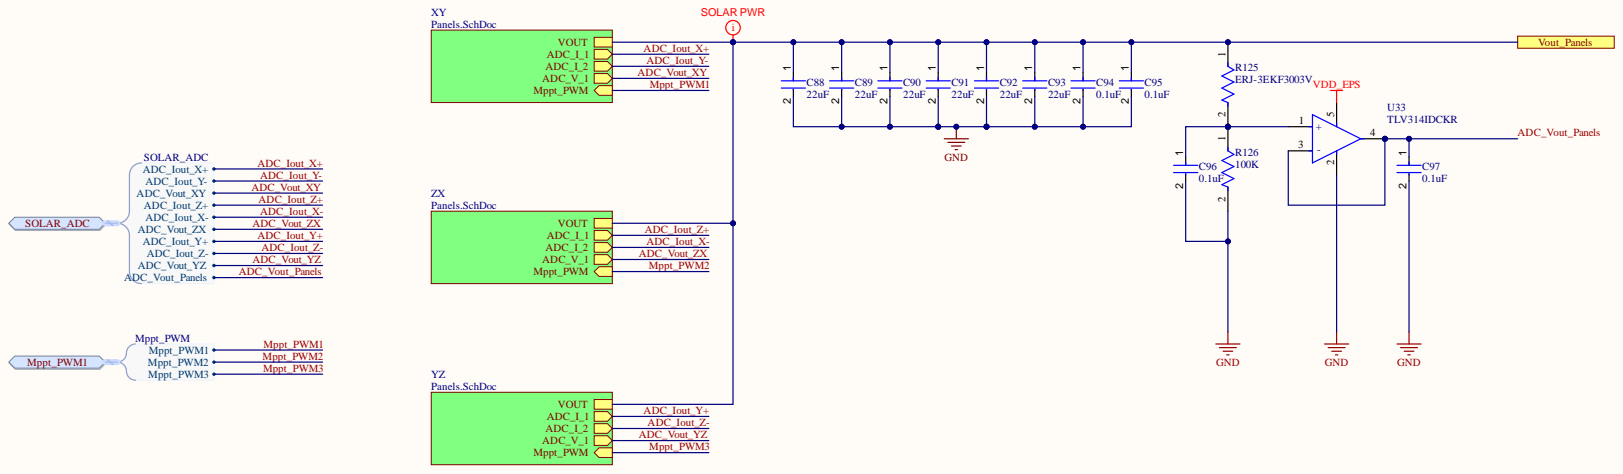
[picture p52: page 2]
JECT REVISION:; DOCUMENT REVISION:; DESIGN ITEM; Version; control disabled; ADC_Iout_Z- ADC_Iout_X+ ADC_Iout_Y+ ADC_Vout_XY ADC_Vout_YZ ADC_Iout_X- ADC_Iout_Z+ ADC_Vout_ZX; ADC_Vout_XY ADC_Iout_Z+ ADC_Iout_X- ADC_Vout_ZX ADC_Iout_Y+ ADC_Iout_Z- ADC_Vout_YZ; ADC_Iout_X+ ADC_Vout_XY; SOLAR PW

A DWG NO: REV:

DATE | PRO JECT | **** APPROVALS

ENG :
** DSN:

CHK: *

Version control disabled

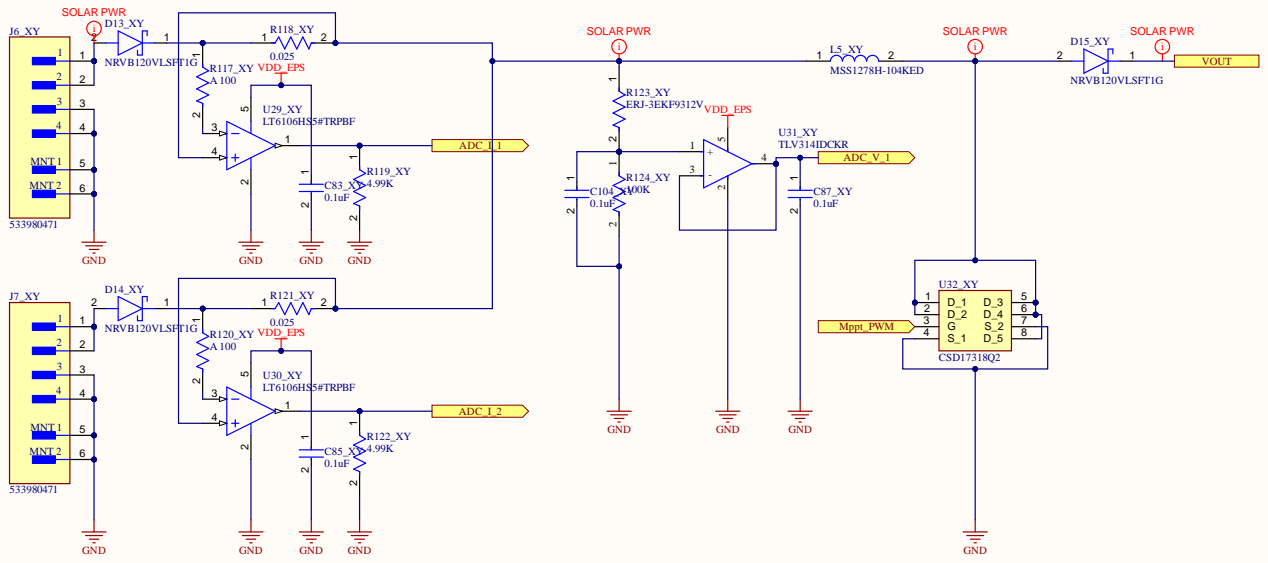
[picture p53: page 3]
<SCH DWG NO>; SIZE; DWG NO.; FILE NAME; SHEET; ASSY DWG:; FAB DWG:; PCB DWG:; <PCB DWG NO>; PROJECT REVISION:; DOCUMENT REVISION:; DESIGN ITEM:; Version; control disabled Version control disabled; NRVB120VLSFT1G 1; MNT 1; MNT 2; SOLAR PWR

DWG NO: <ASSY DWG NO> | REV:

THIS DOCUMENT AND THE DATA DISCLOSED HEREIN OR HEREWITH IS THE PROPERTY OF ALTIUM LIMITED AND MAY BE FREELY DISTRIBUTED IN WHOLE. NO RIGHTS ARE | | REVISION | DESCRIPTION | DATE | APPROVED

DWG NO: REV:

DATE | PROJECT | * * APPROVALS * *

ENG: *

DSN: *

CHK: *

<BOM DOC NO>

<FAB DWG NO>

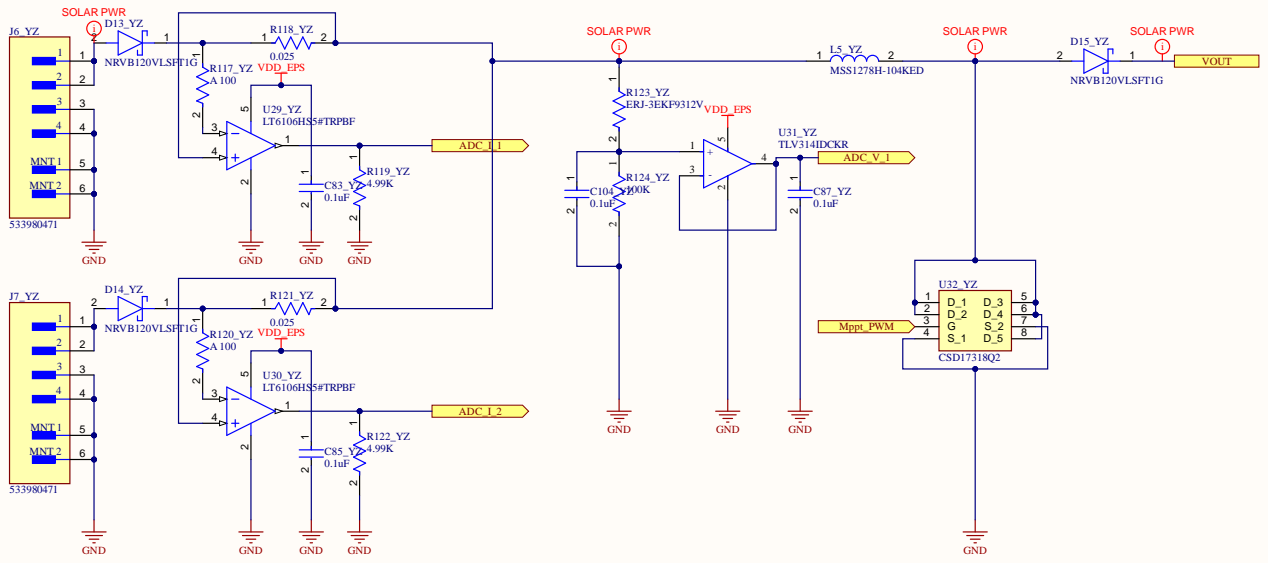
[picture p54: page 4]
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

DWG NO: REV:

DATE | PROJECT | * * APPROVALS * *

ENG: *

DSN: *

CHK: *

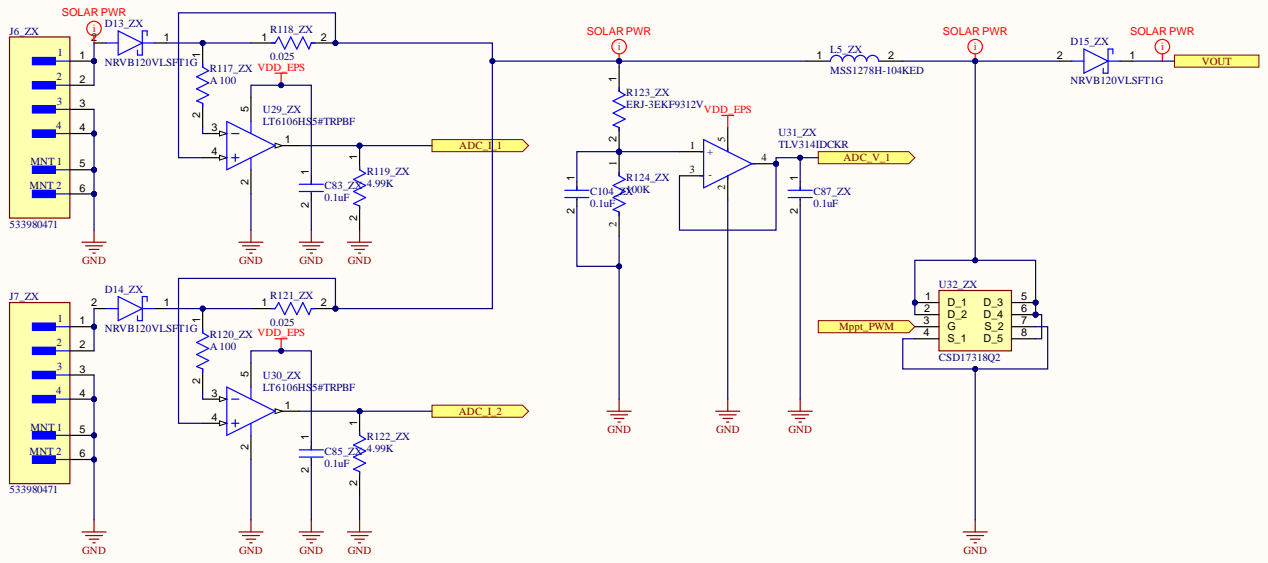
[picture p55: page 5]
JECT REVISION:; DOCUMENT REVISION:; DESIGN ITEM; Version; control disabled; SOLAR PW

A DWG NO: REV:

DATE | PRO JECT | **** APPROVALS

ENG :
** DSN:

CHK: *

Version control disabled

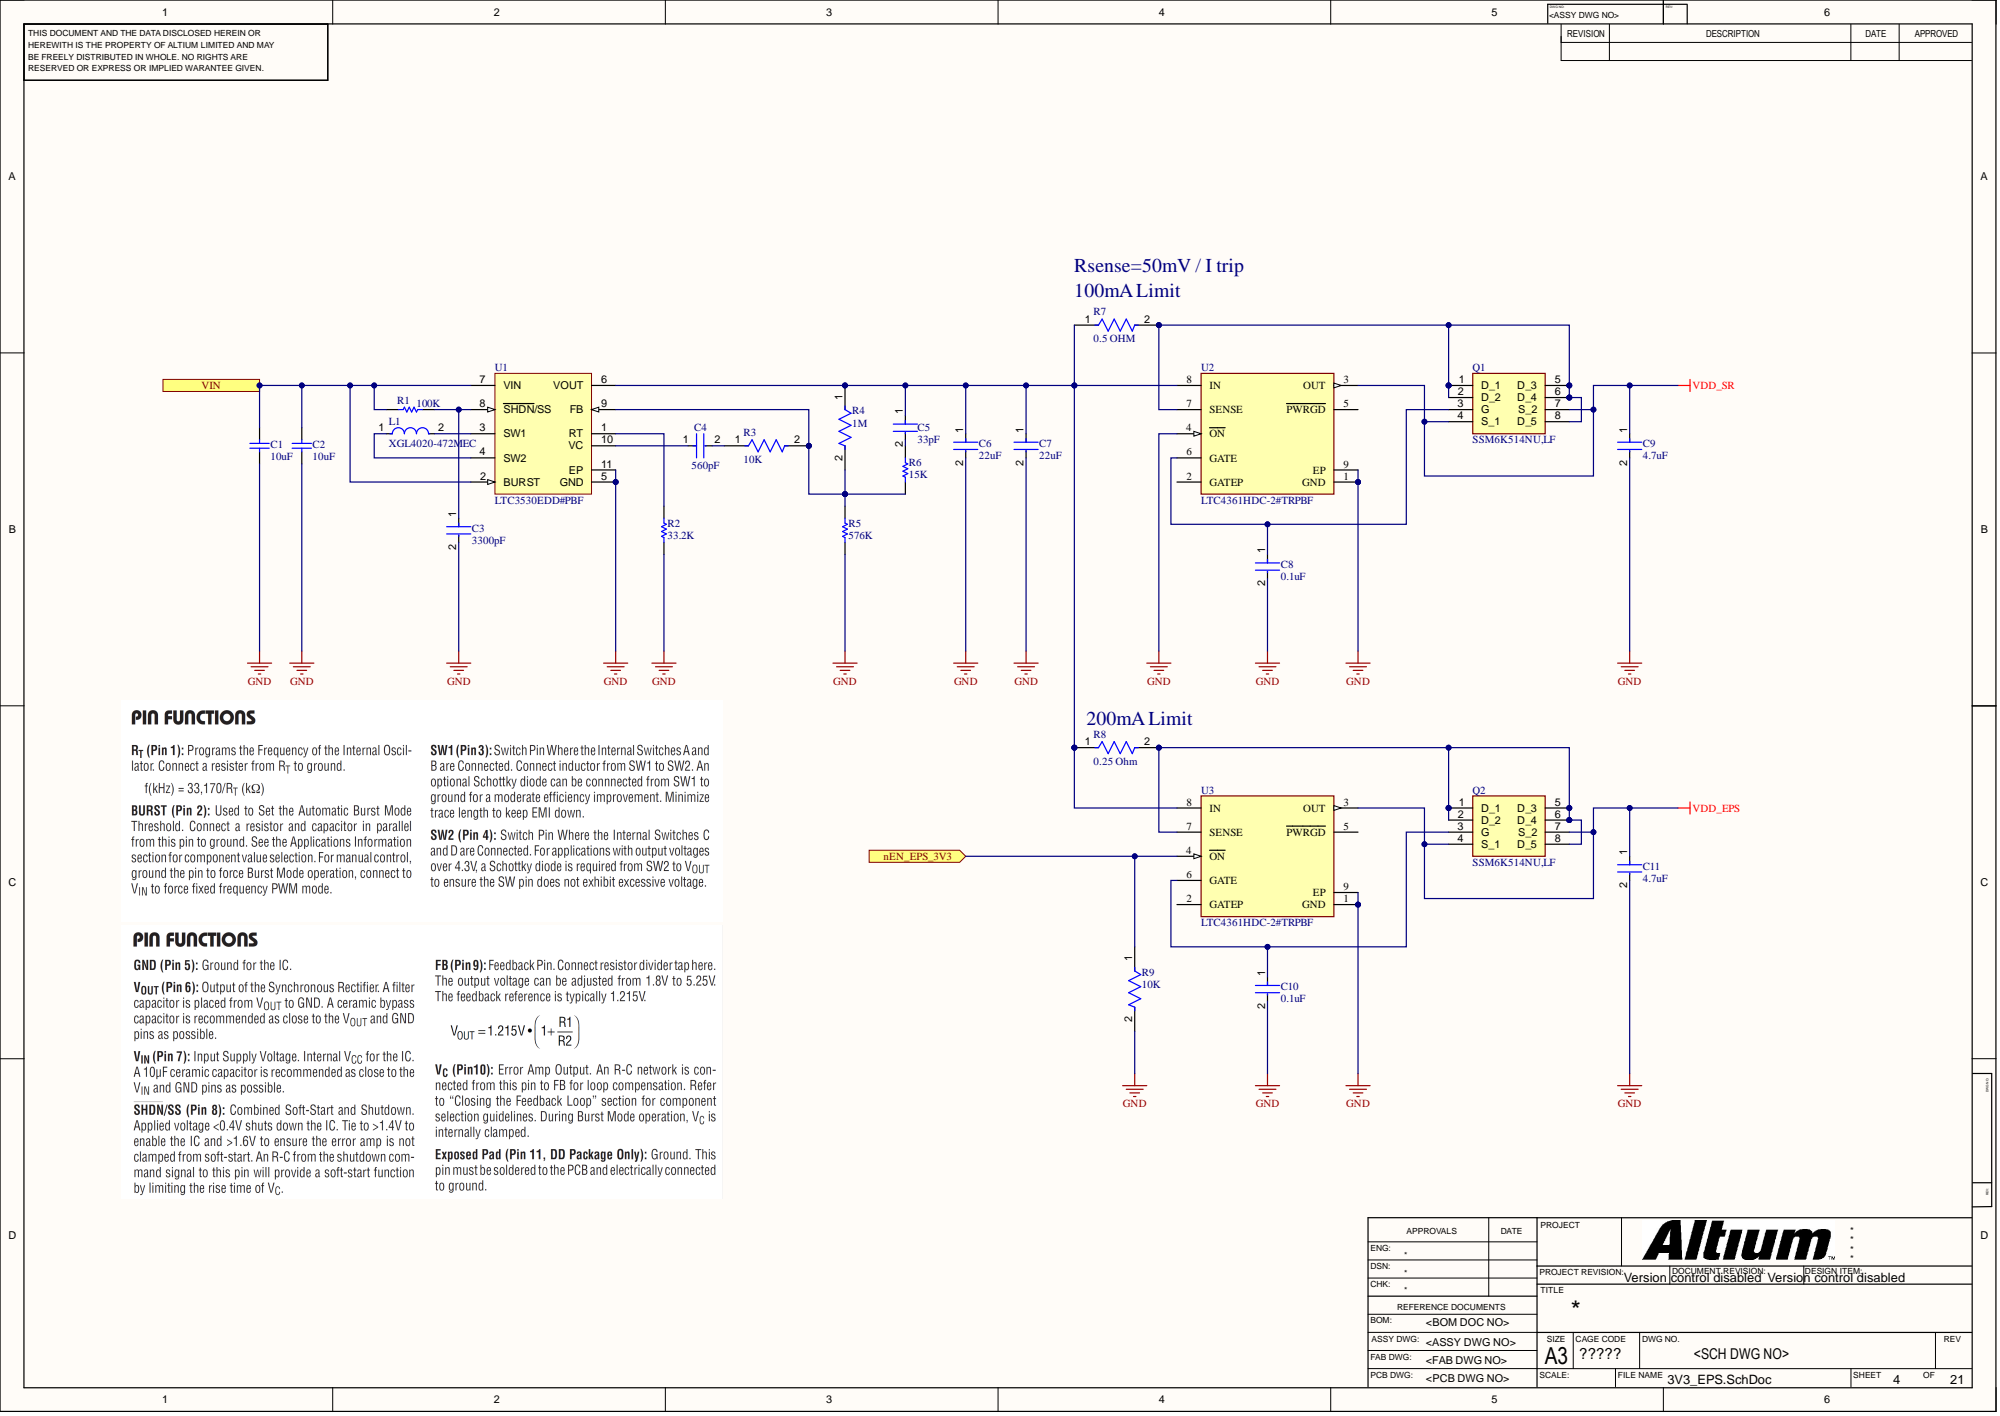
[picture p56: page 6]

DATE | PROJECT | * * APPROVALS * *

ENG: *

DSN: *

CHK: *

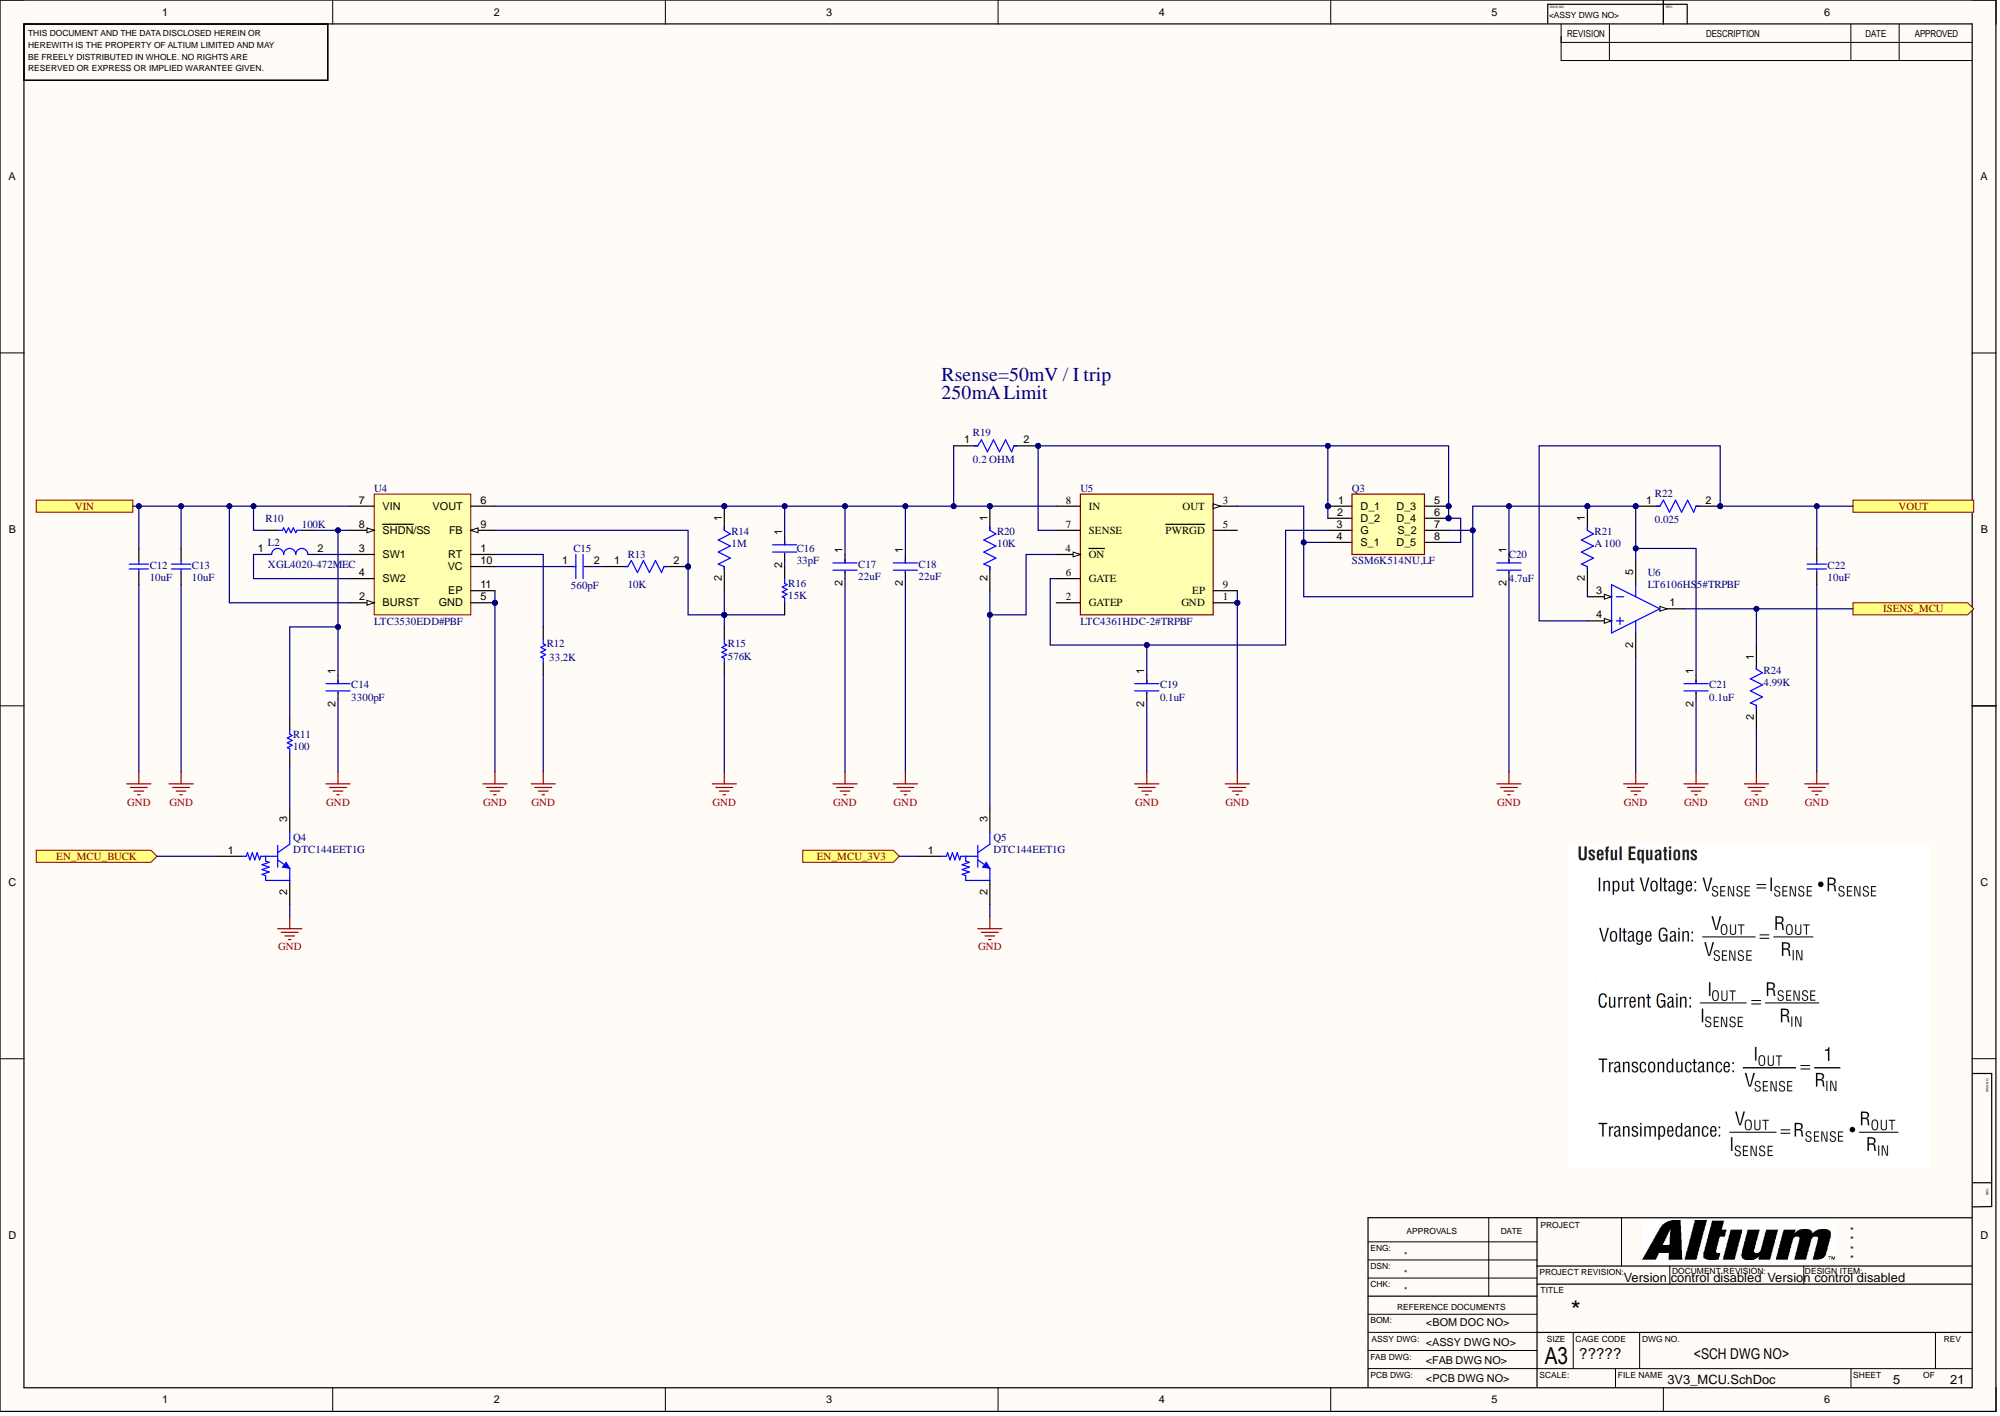
[picture p57: page 7]
JECT REVISION:; DOCUMENT REVISION:; DESIGN ITEM; Version; control disabled; 0mA Limit; 6 VIN; 2 R19 0.2 OHM; 0mV / I trip

A DWG NO: REV:

DATE | PRO JECT | **** APPROVALS

ENG :
** DSN:

CHK: *

Version control disabled

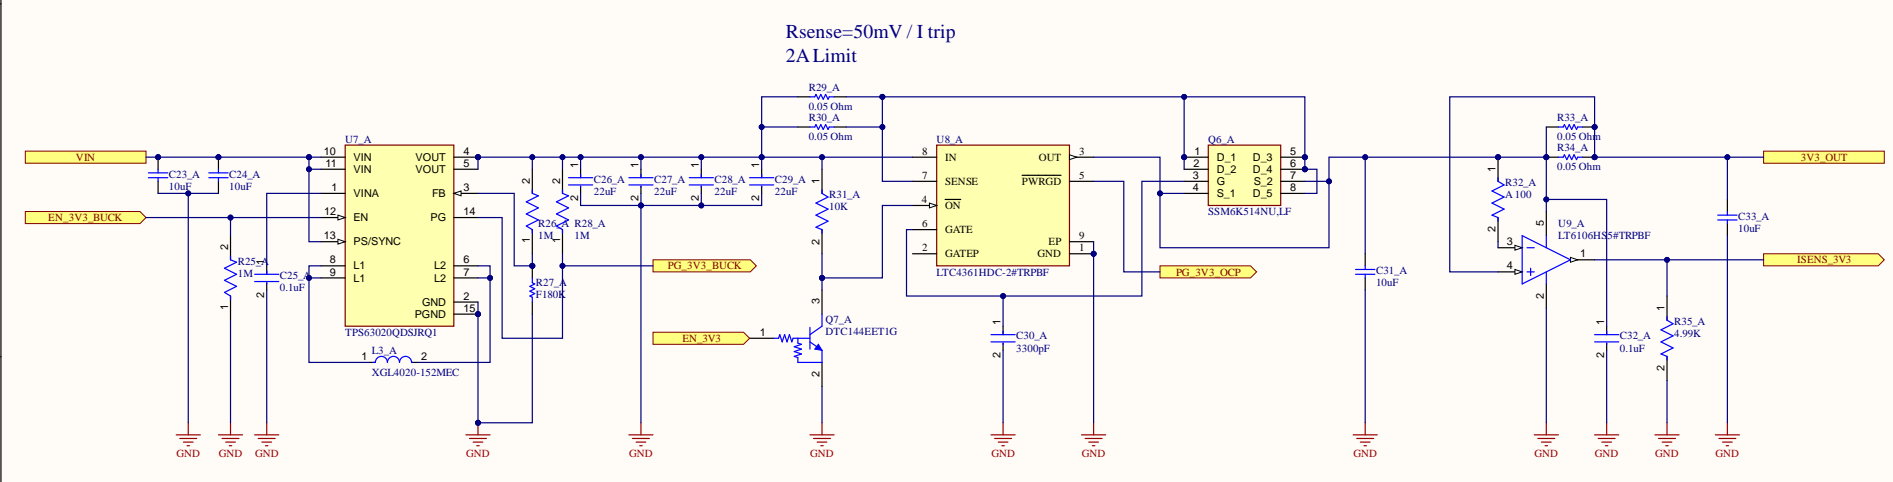
[picture p58: page 8]
PROJECT REVISION:; DOCUMENT REVISION:; DESIGN ITEM:; Version; control disabled Version control disabled; VIN 10 VIN 11; VINA 1; PS/SYNC 13; 9 GATE 6; GATEP 2; OUT; SENSE 7; 2 Q7_A DTC144EET1G EN_3V3; Rsense=50mV / I trip; 0.05 Ohm

DWG NO: REV:

DATE | PROJECT | * * APPROVALS * *

ENG: *

DSN: *

CHK: *

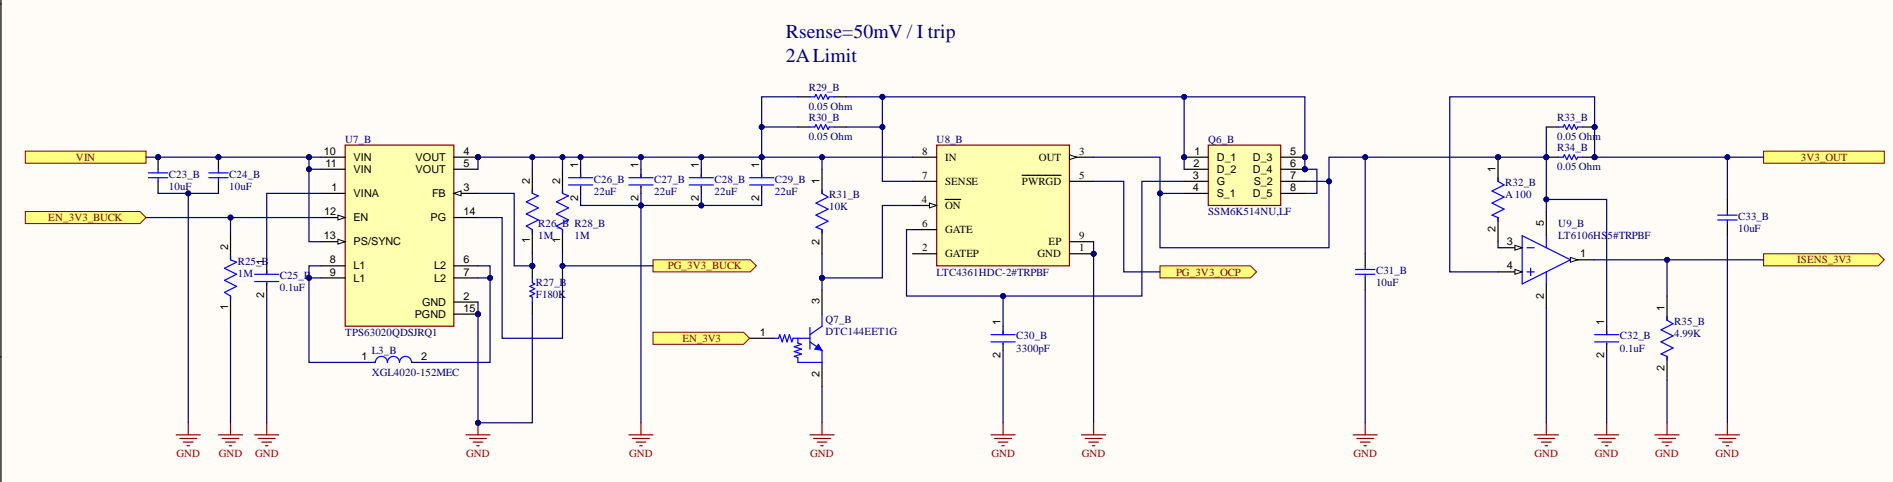
[picture p59: page 9]
JECT REVISION:; DOCUMENT REVISION:; DESIGN ITEM; Version; control disabled; 0mV / I trip

A DWG NO: REV:

1 | 3 | | 7 | SE N S E PWRG D O N G AT E E P G AT E P G N D | 5 | 3 | G S_2 S_1 D _5 | 7

DATE | PRO JECT | **** APPROVALS

ENG :
** DSN:

CHK: *

Version control disabled

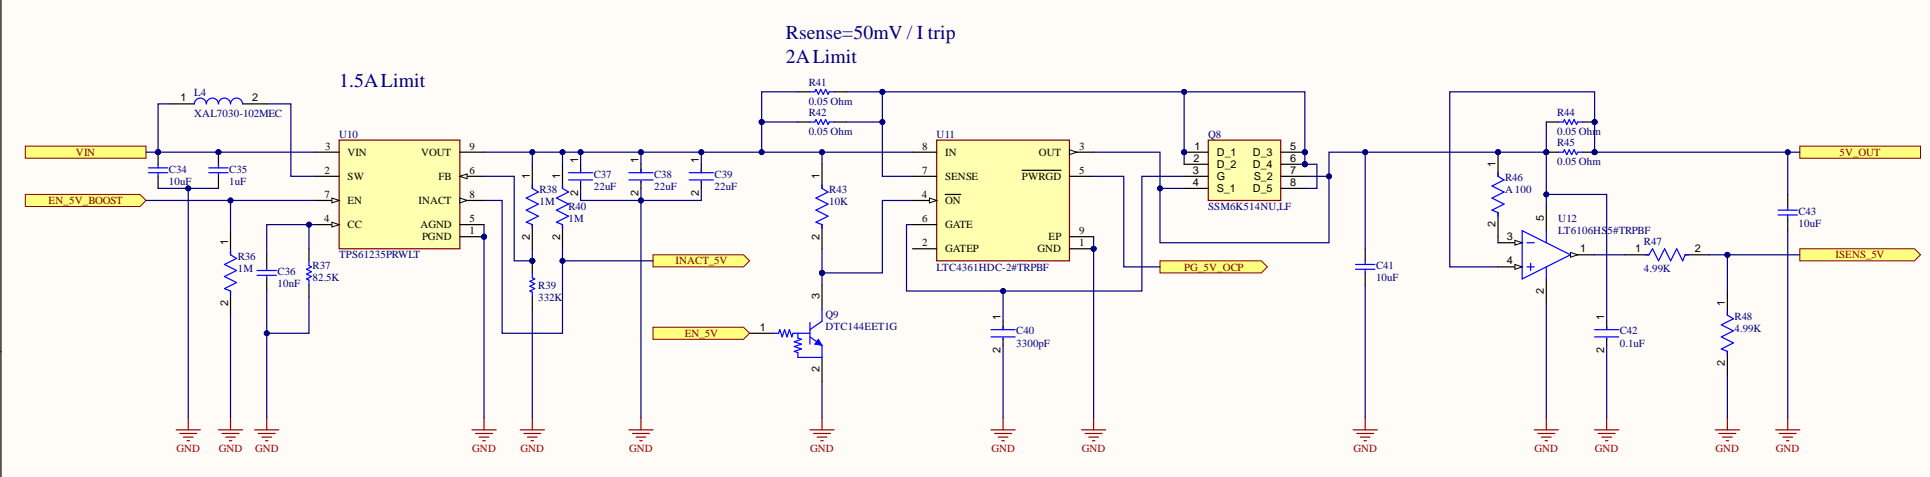
[picture p60: page 10]
JECT REVISION:; DOCUMENT REVISION:; DESIGN ITEM; Version; control disabled; 0mV / I trip

A DWG NO: REV:

DATE | PRO JECT | **** APPROVALS

ENG :
** DSN:

CHK: *

Version control disabled

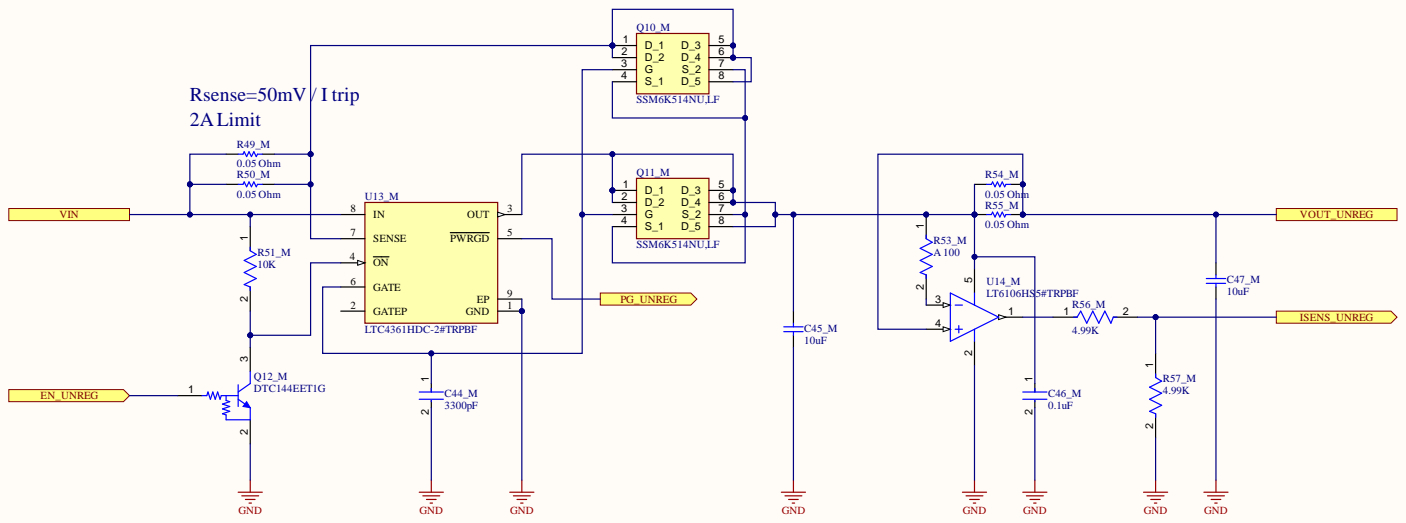
[picture p61: page 11]
PROJECT REVISION:; DOCUMENT REVISION:; DESIGN ITEM:; Version; control disabled Version control disabled; 9 GATE 6; GATEP 2; OUT; SENSE 7; ISENS_UNREG C45_M; DTC144EET1G; Rsense=50mV / I trip; 0.05 Ohm

DWG NO: REV:

DATE | PROJECT | * * APPROVALS * *

ENG: *

DSN: *

CHK: *

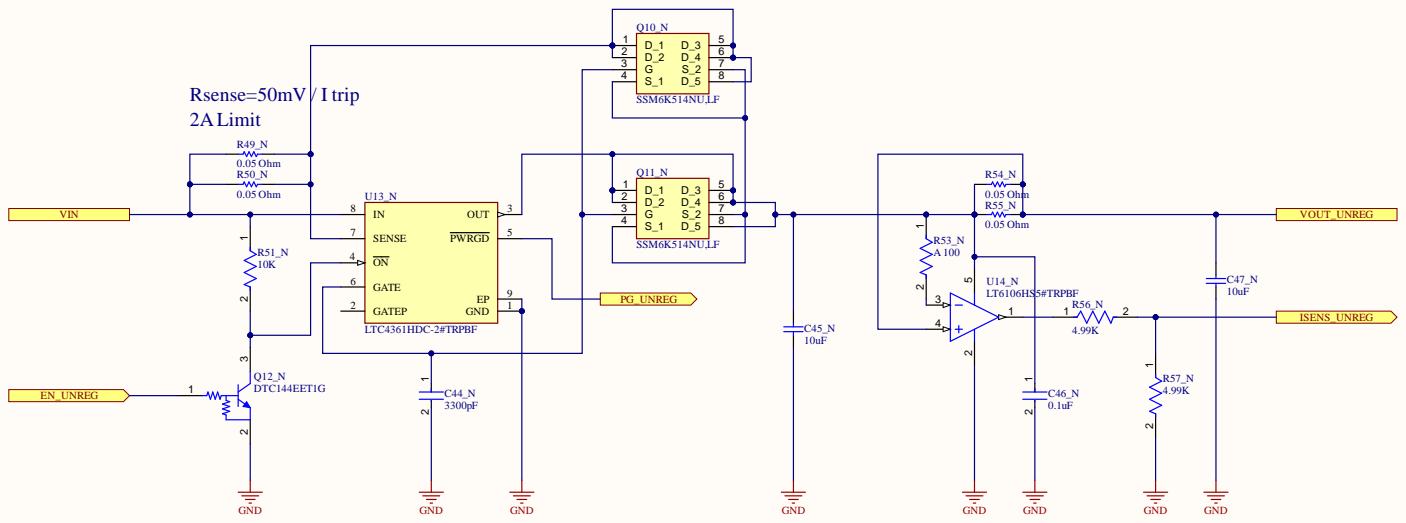
[picture p62: page 12]
JECT REVISION:; DOCUMENT REVISION:; DESIGN ITEM; Version; control disabled; 0mV / I trip

A DWG NO: REV:

3 | G S_2 | 7
4 | S_1 D _5 | 8

DATE | PRO JECT | **** APPROVALS

ENG :
** DSN:

CHK: *

Version control disabled

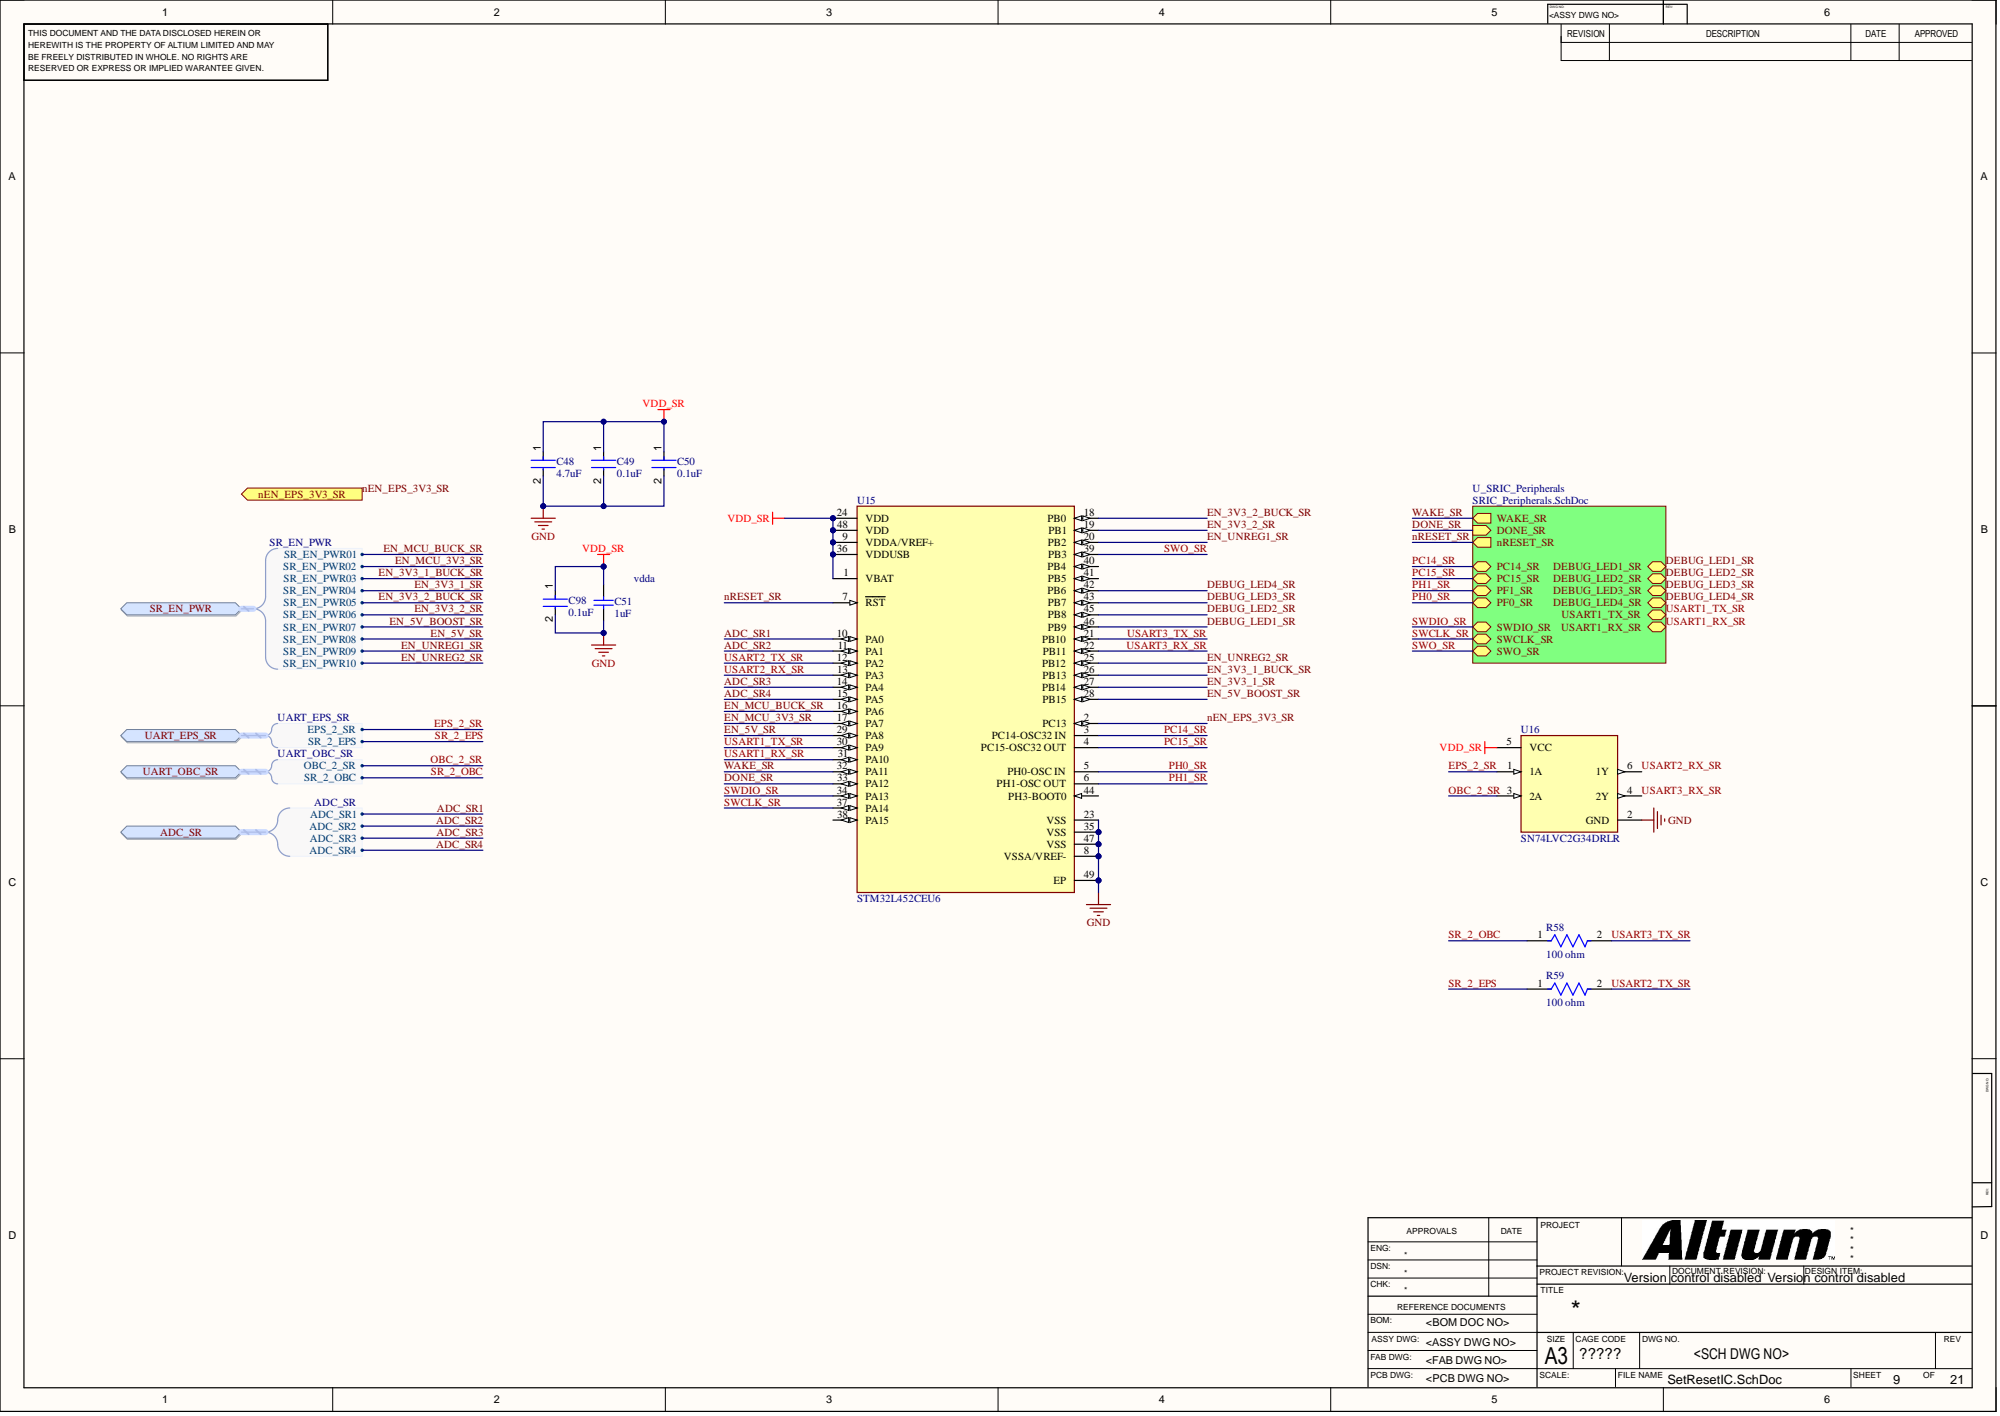
[picture p63: page 13]
JECT REVISION:; DOCUMENT REVISION:; DESIGN ITEM; Version; control disabled; R SR_EN_PWR01; 2 R58 100 ohm; 2 R59 100 ohm; 0-OSC IN

A DWG NO: REV:

DATE | PRO JECT | **** APPROVALS

ENG :
** DSN:

CHK: *

Version control disabled

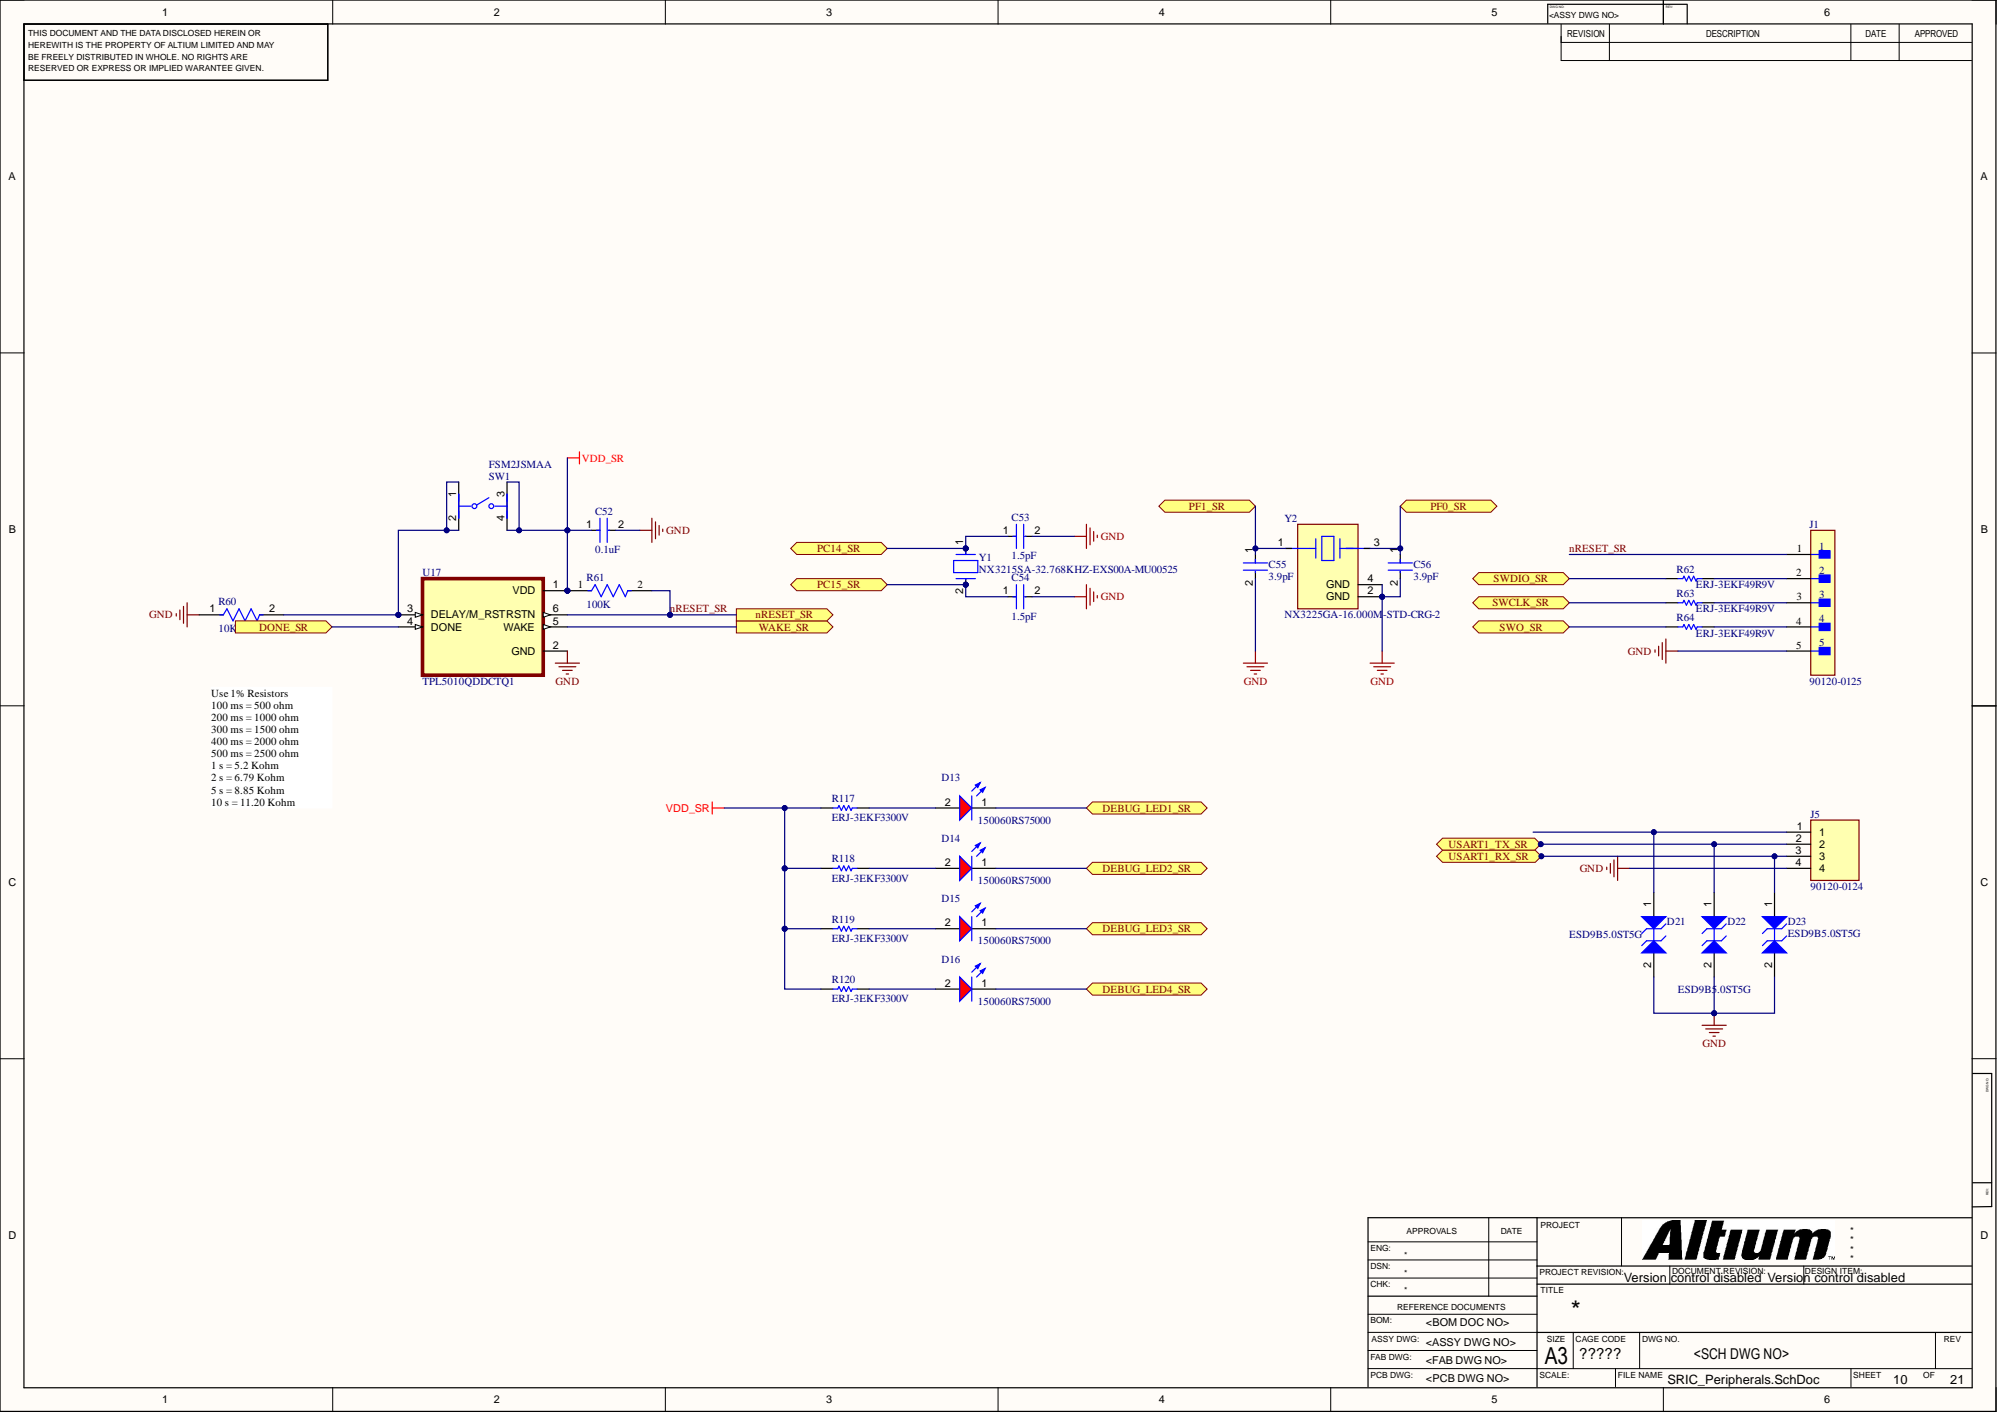
[picture p64: page 14]

DATE | PROJECT | * * APPROVALS * *

ENG: *

DSN: *

CHK: *

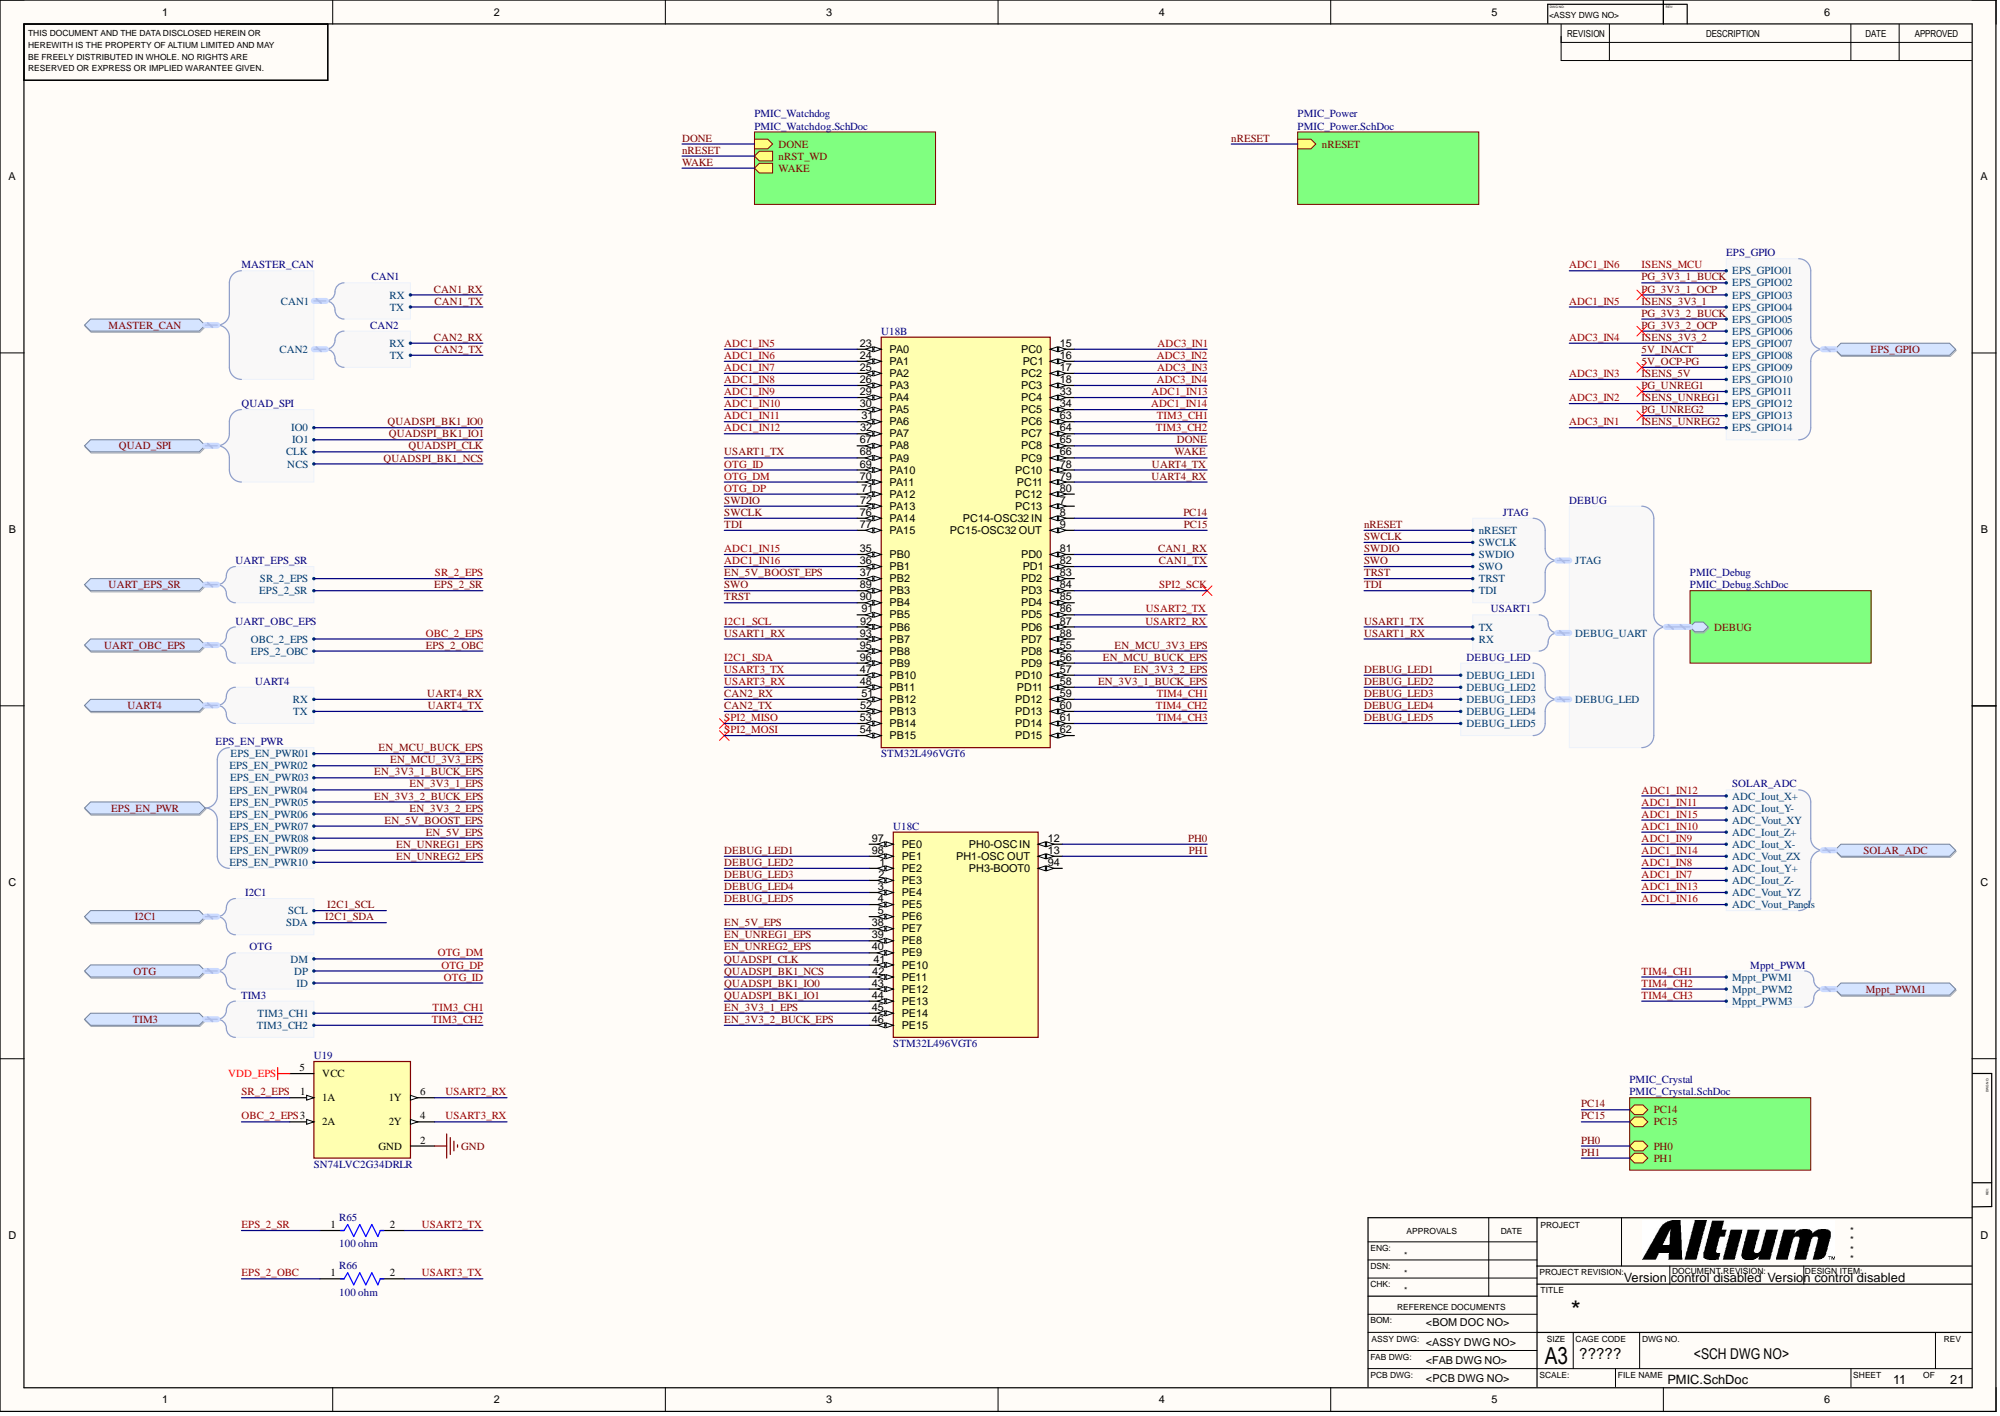
[picture p65: page 15]
JECT REVISION:; DOCUMENT REVISION:; DESIGN ITEM; Version; control disabled; PC15-OSC32 OU; PH1-OSC OU; 2 R65 100 ohm; 2 R66 100 ohm; A SDA

A DWG NO: REV:

DATE | PRO JECT | **** APPROVALS

ENG :
** DSN:

CHK: *

Version control disabled

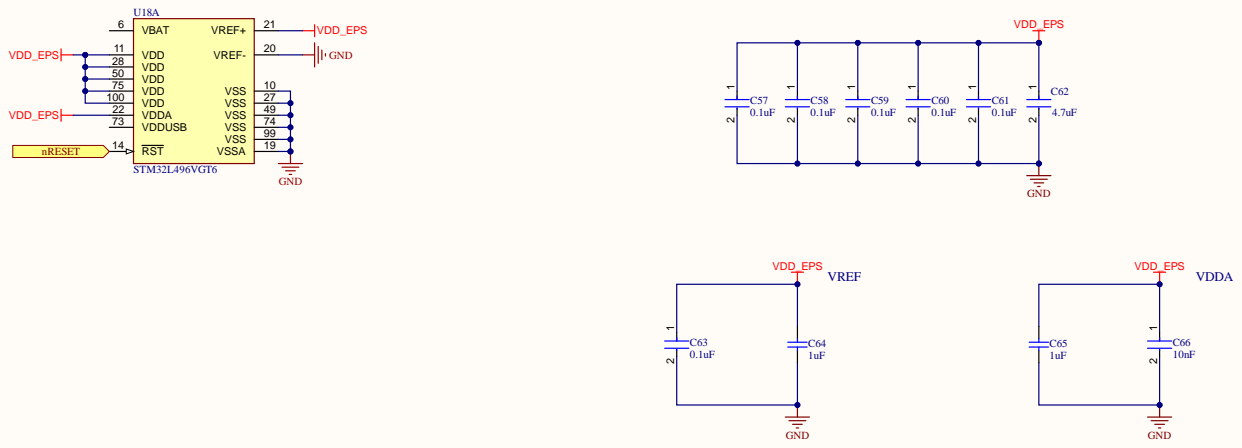
[picture p66: page 16]

DATE | PROJECT | * * APPROVALS * *

ENG: *

DSN: *

CHK: *

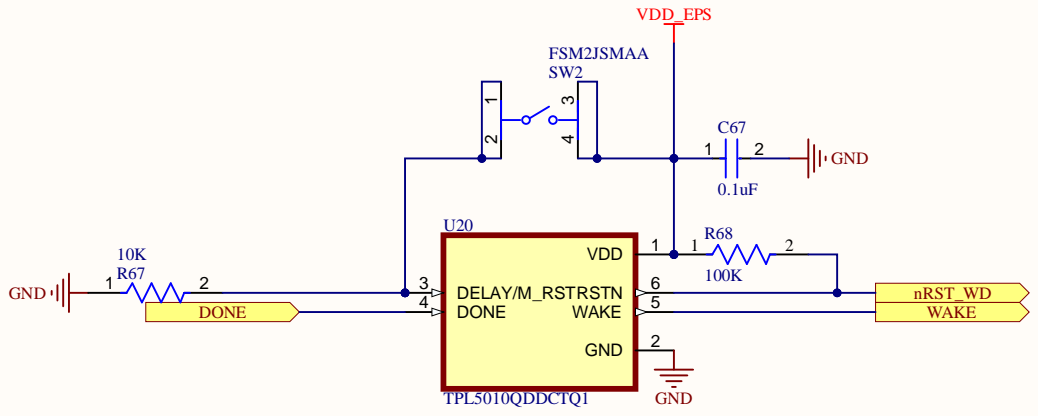
[picture p67: page 17]
PROJECT REVISION:; DOCUMENT REVISION:; DESIGN ITEM:; Version; control disabled Version control disabled; DELAY/M_RST 3 DONE 4

DWG NO: REV:

DATE | PROJECT | * * APPROVALS * *

ENG: *

DSN: *

CHK: *

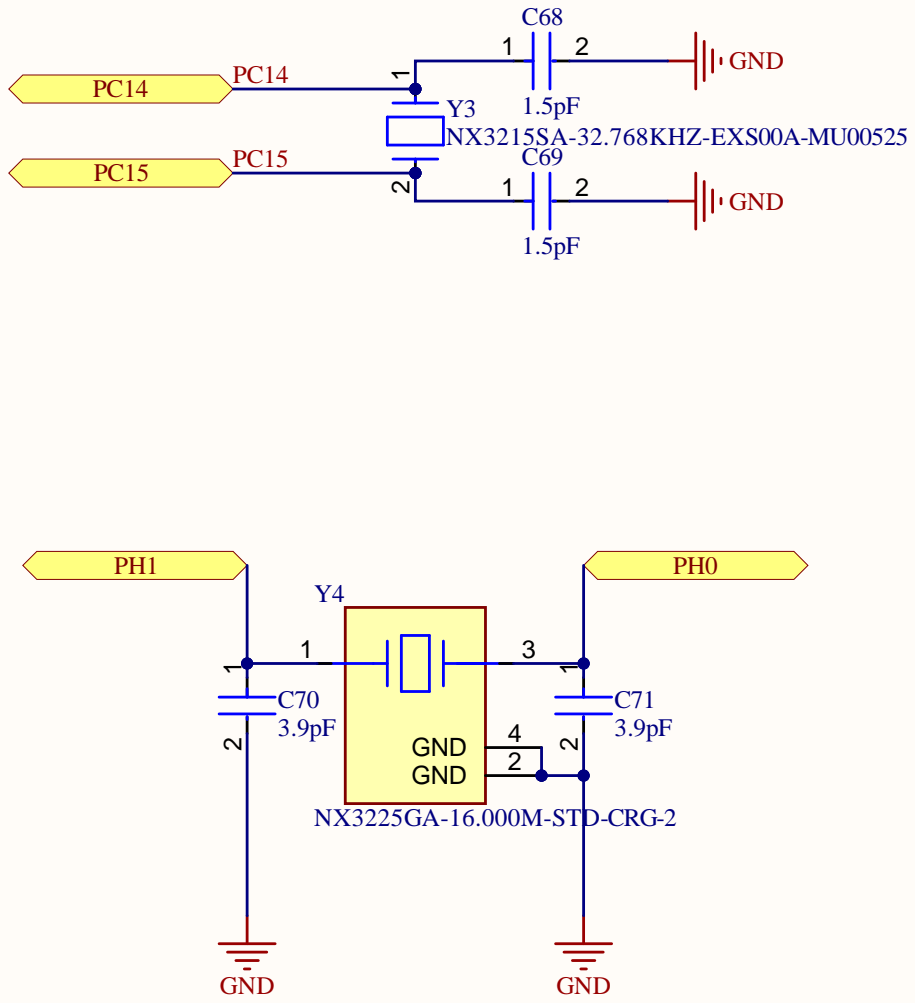
[picture p68: page 18]
PROJECT REVISION:; DOCUMENT REVISION:; DESIGN ITEM:; Version; control disabled Version control disabled; GND; 2 GND

DWG NO: REV:

DATE | PROJECT | * * APPROVALS * *

ENG: *

DSN: *

CHK: *

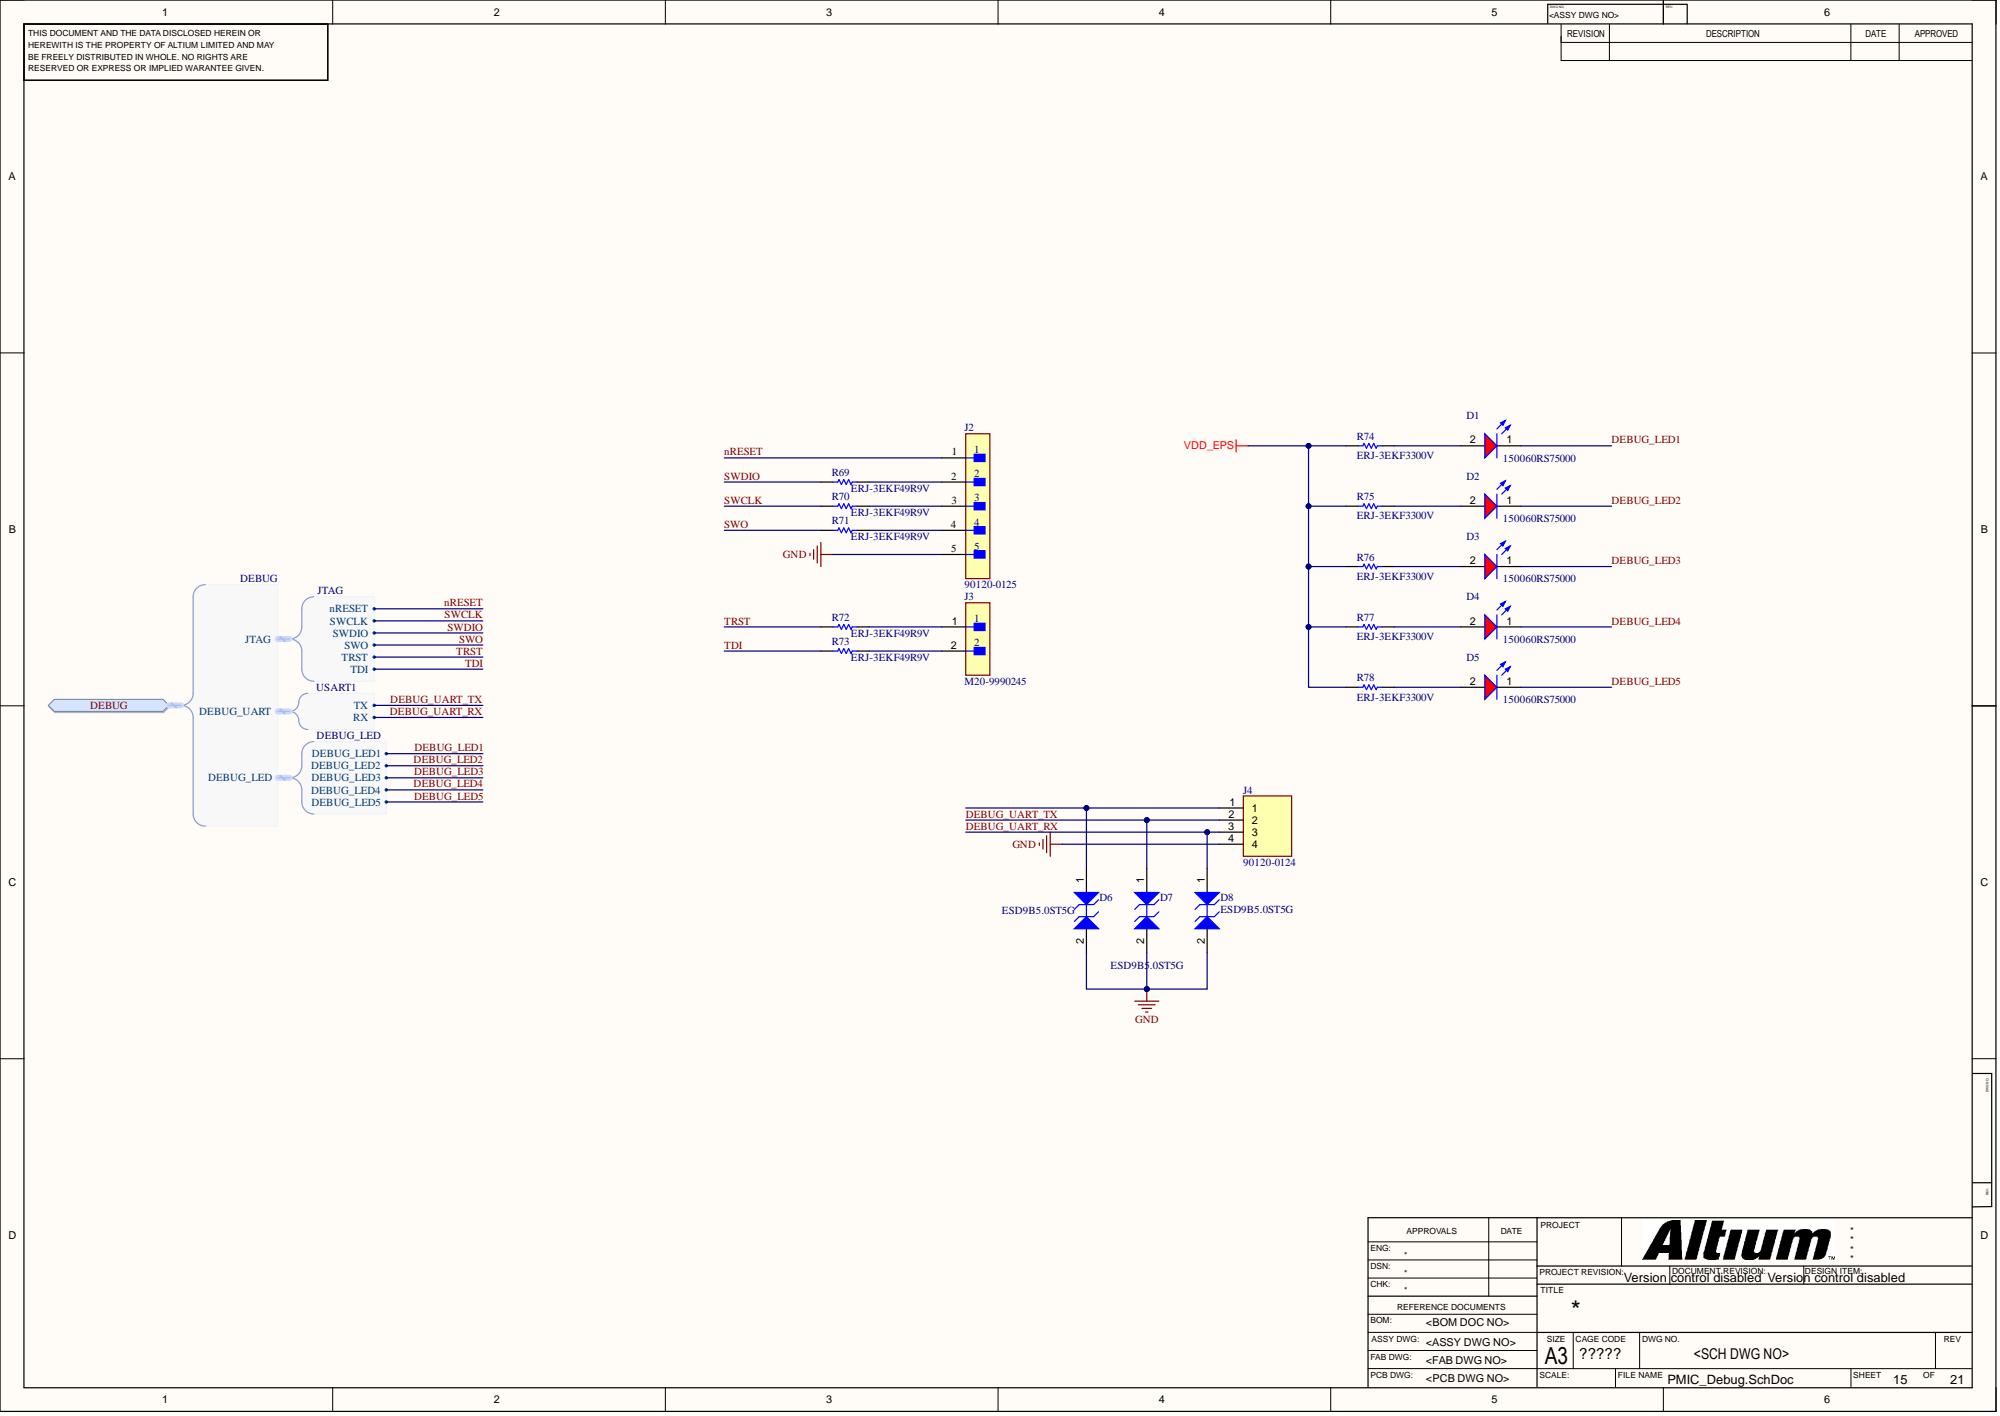
[picture p69: page 19]
JECT REVISION:; DOCUMENT REVISION:; DESIGN ITEM; Version; control disabled; V R70ERJ-3EKF49R9V R71ERJ-3EKF49R9V; V R73ERJ-3EKF49R9V

A DWG NO: REV:

D EBU G_ U A RT_T X | 2
D EBU G_ U A RT_RX | | 3

DATE | PRO JECT | **** APPROVALS

ENG :
** DSN:

CHK: *

Version control disabled

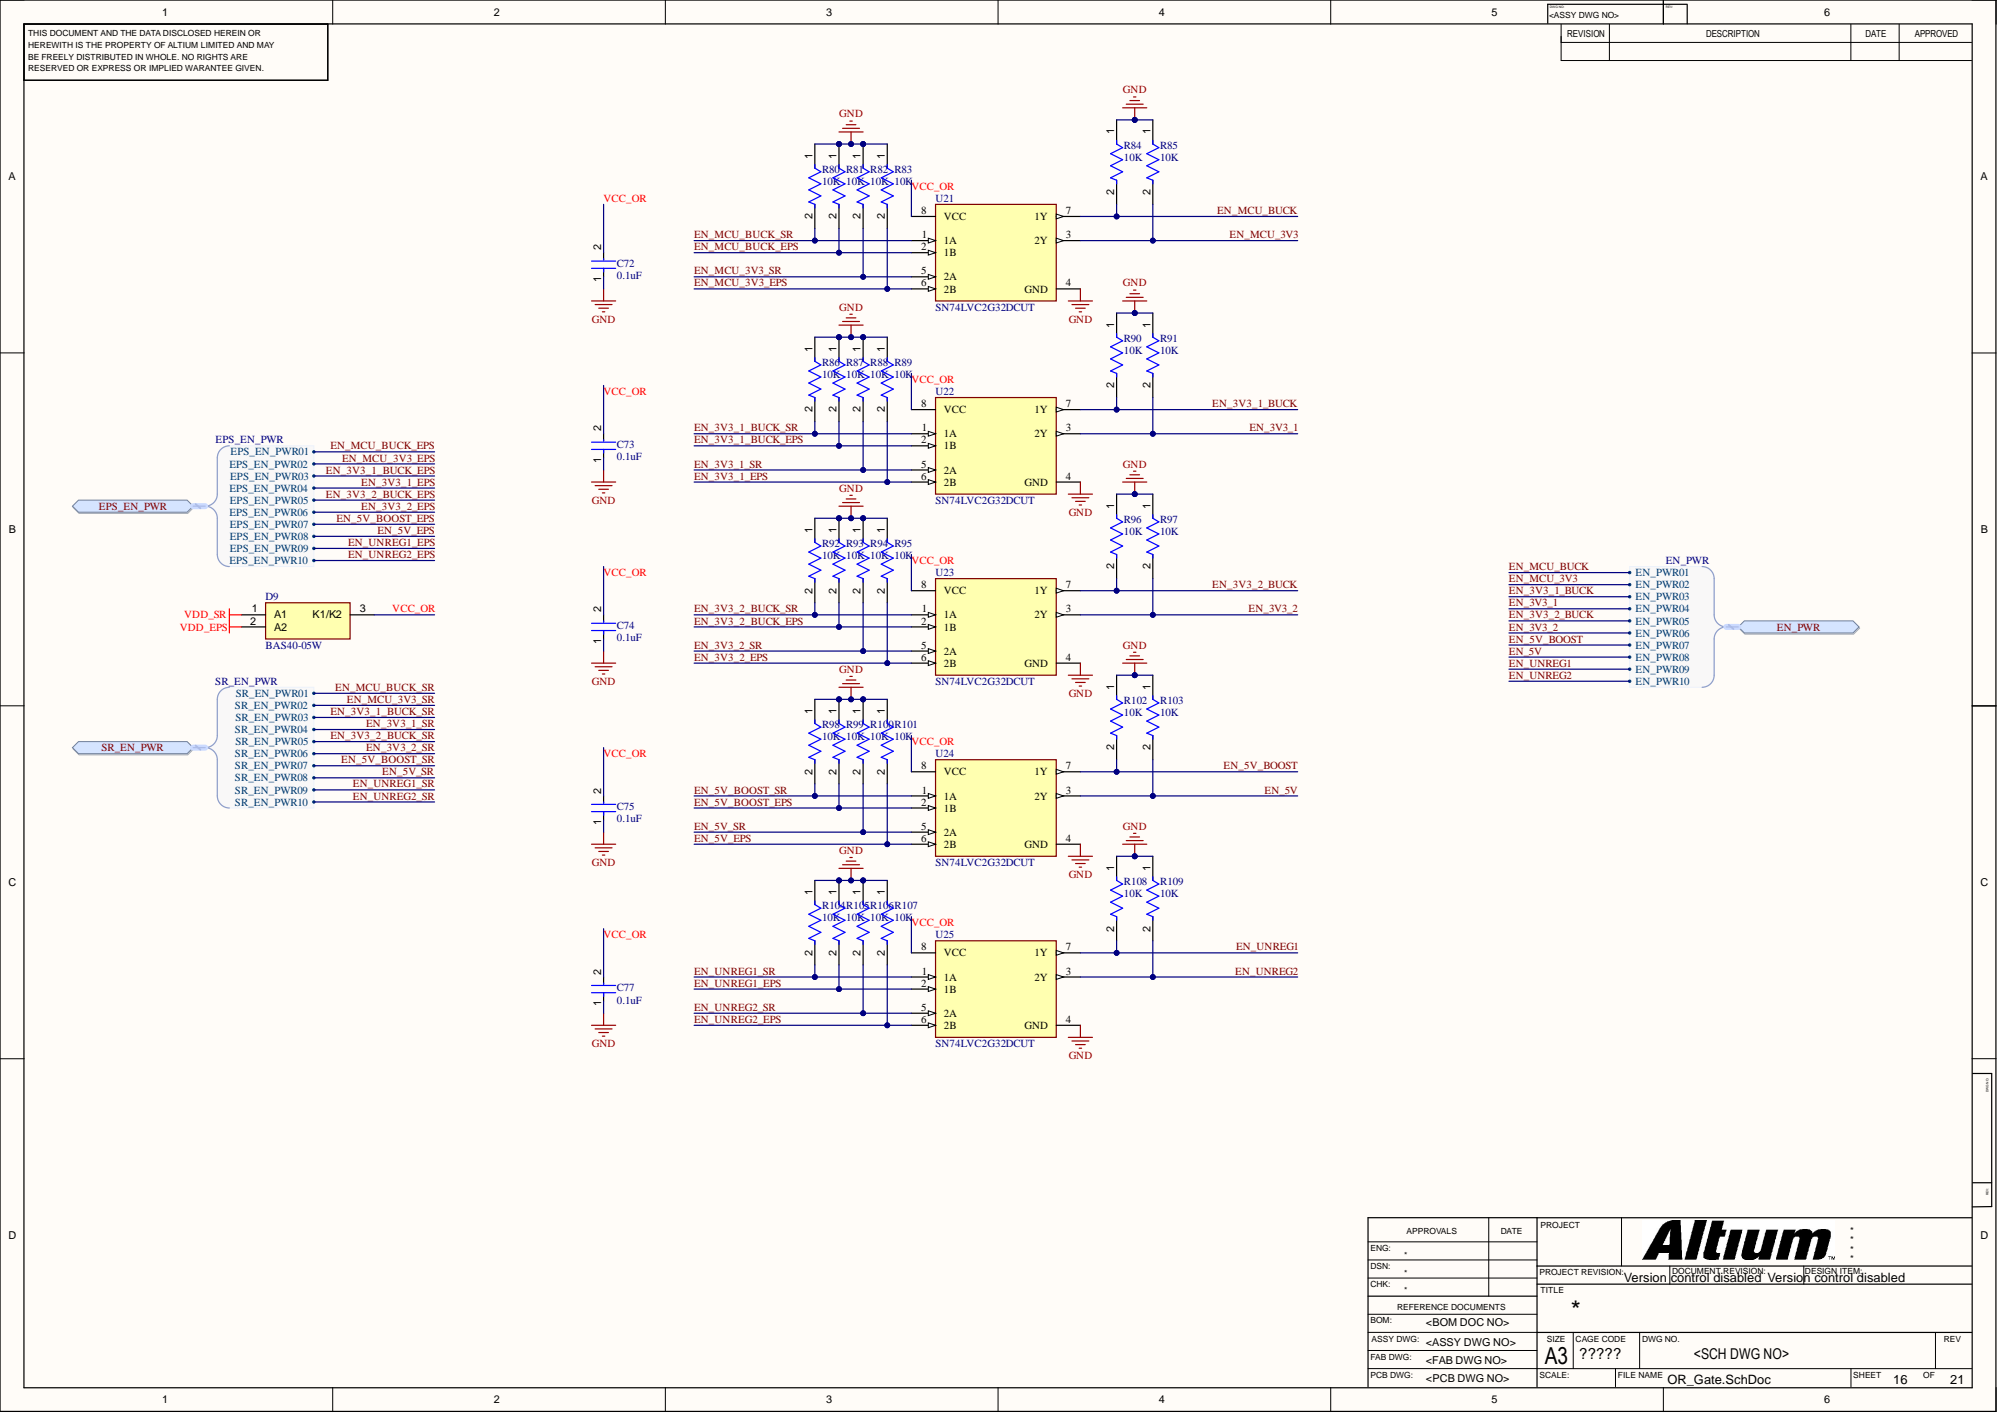
[picture p70: page 20]
JECT REVISION:; DOCUMENT REVISION:; DESIGN ITEM; Version; control disabled

A DWG NO: REV:

DATE | PRO JECT | **** APPROVALS

ENG :
** DSN:

CHK: *

Version control disabled

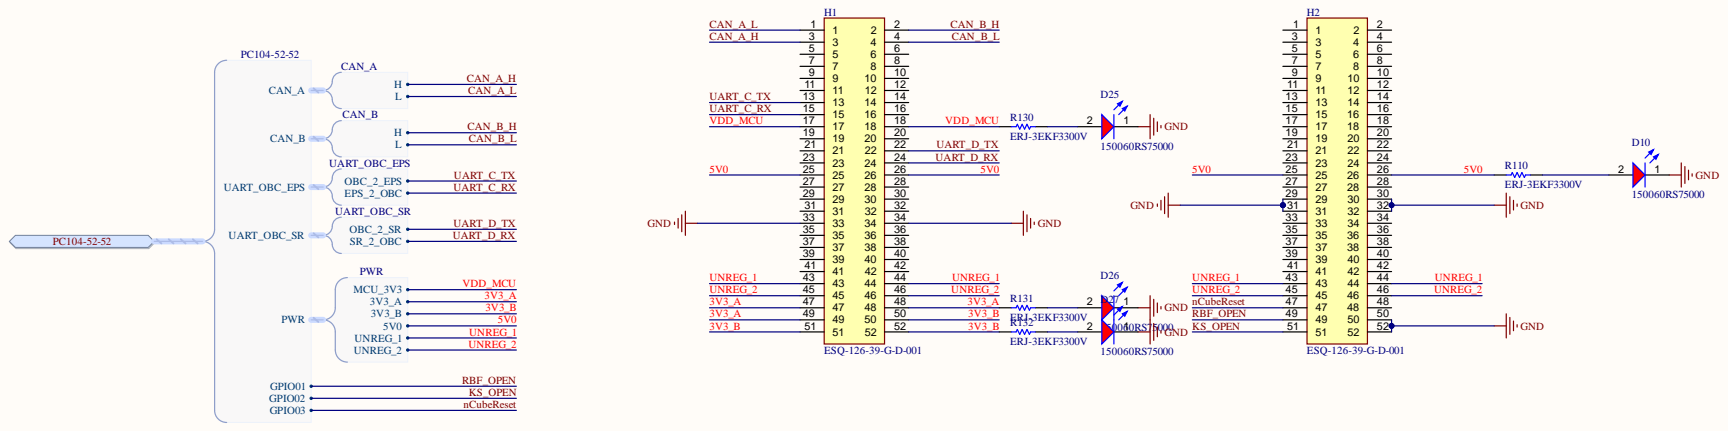
[picture p71: page 21]
JECT REVISION:; DOCUMENT REVISION:; DESIGN ITEM; Version; control disabled

A DWG NO: REV:

DATE | PRO JECT * | **** APPROVALS

ENG : | --/--/--
** DSN: | --/--/--

CHK: * | --/--/--

Version control disabled

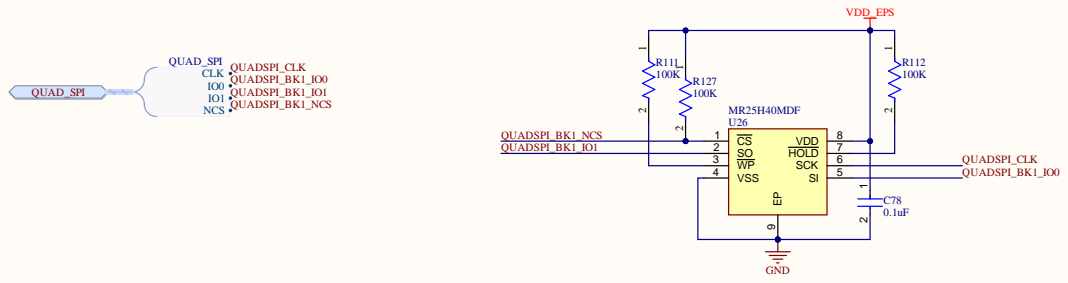
[picture p72: page 22]
JECT REVISION:; DOCUMENT REVISION:; DESIGN ITEM; Version; control disabled

A DWG NO: REV:

DATE | PRO JECT | **** APPROVALS

ENG :
** DSN:

CHK: *

Version control disabled

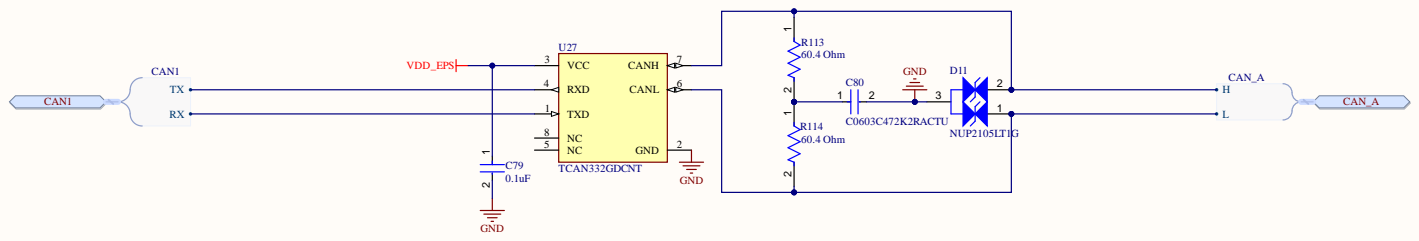
[picture p73: page 23]
JECT REVISION:; DOCUMENT REVISION:; DESIGN ITEM; Version; control disabled; 6 RXD

A DWG NO: REV:

DATE | PRO JECT | **** APPROVALS

ENG :
** DSN:

CHK: *

Version control disabled

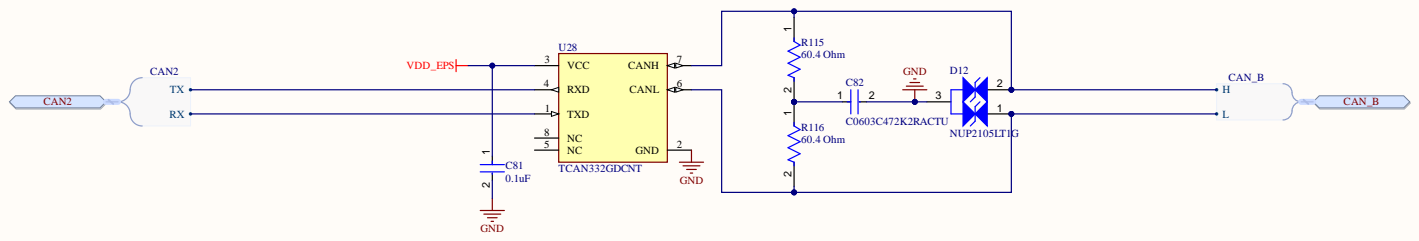
[picture p74: page 24]
JECT REVISION:; DOCUMENT REVISION:; DESIGN ITEM; Version; control disabled; 6 RXD

A DWG NO: REV:

DATE | PRO JECT | **** APPROVALS

ENG :
** DSN:

CHK: *

Version control disabled

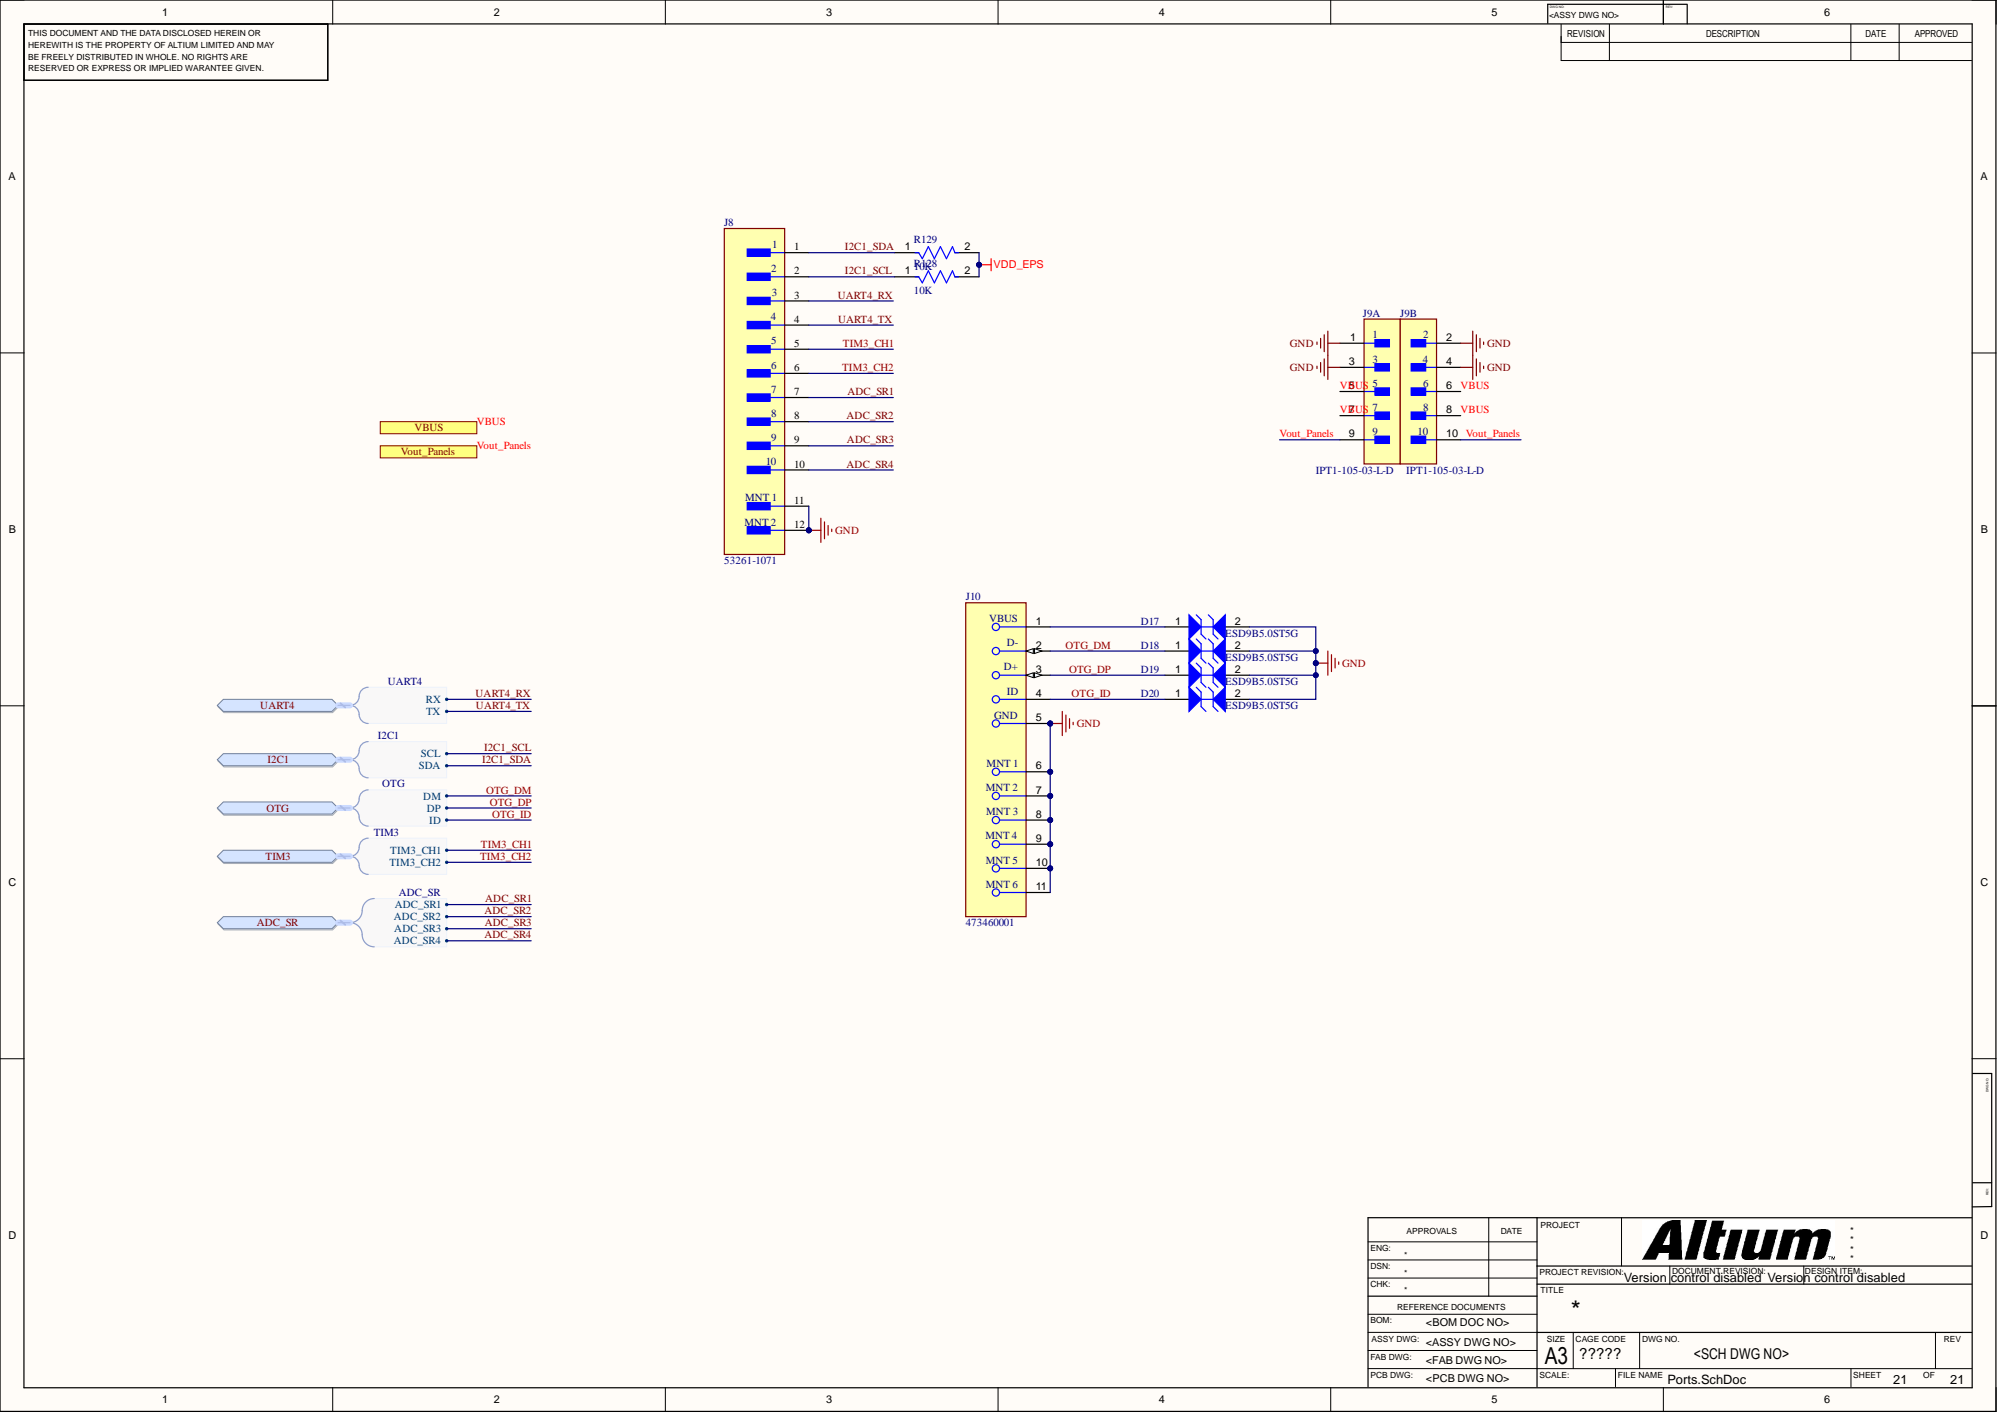
[picture p75: page 25]

DATE | PROJECT | * * APPROVALS * *

ENG: *

DSN: *

CHK: *
