hiteshbhoyar03/Cubesat/Battery Board/docs/Assembly Drawings battery board.pdf

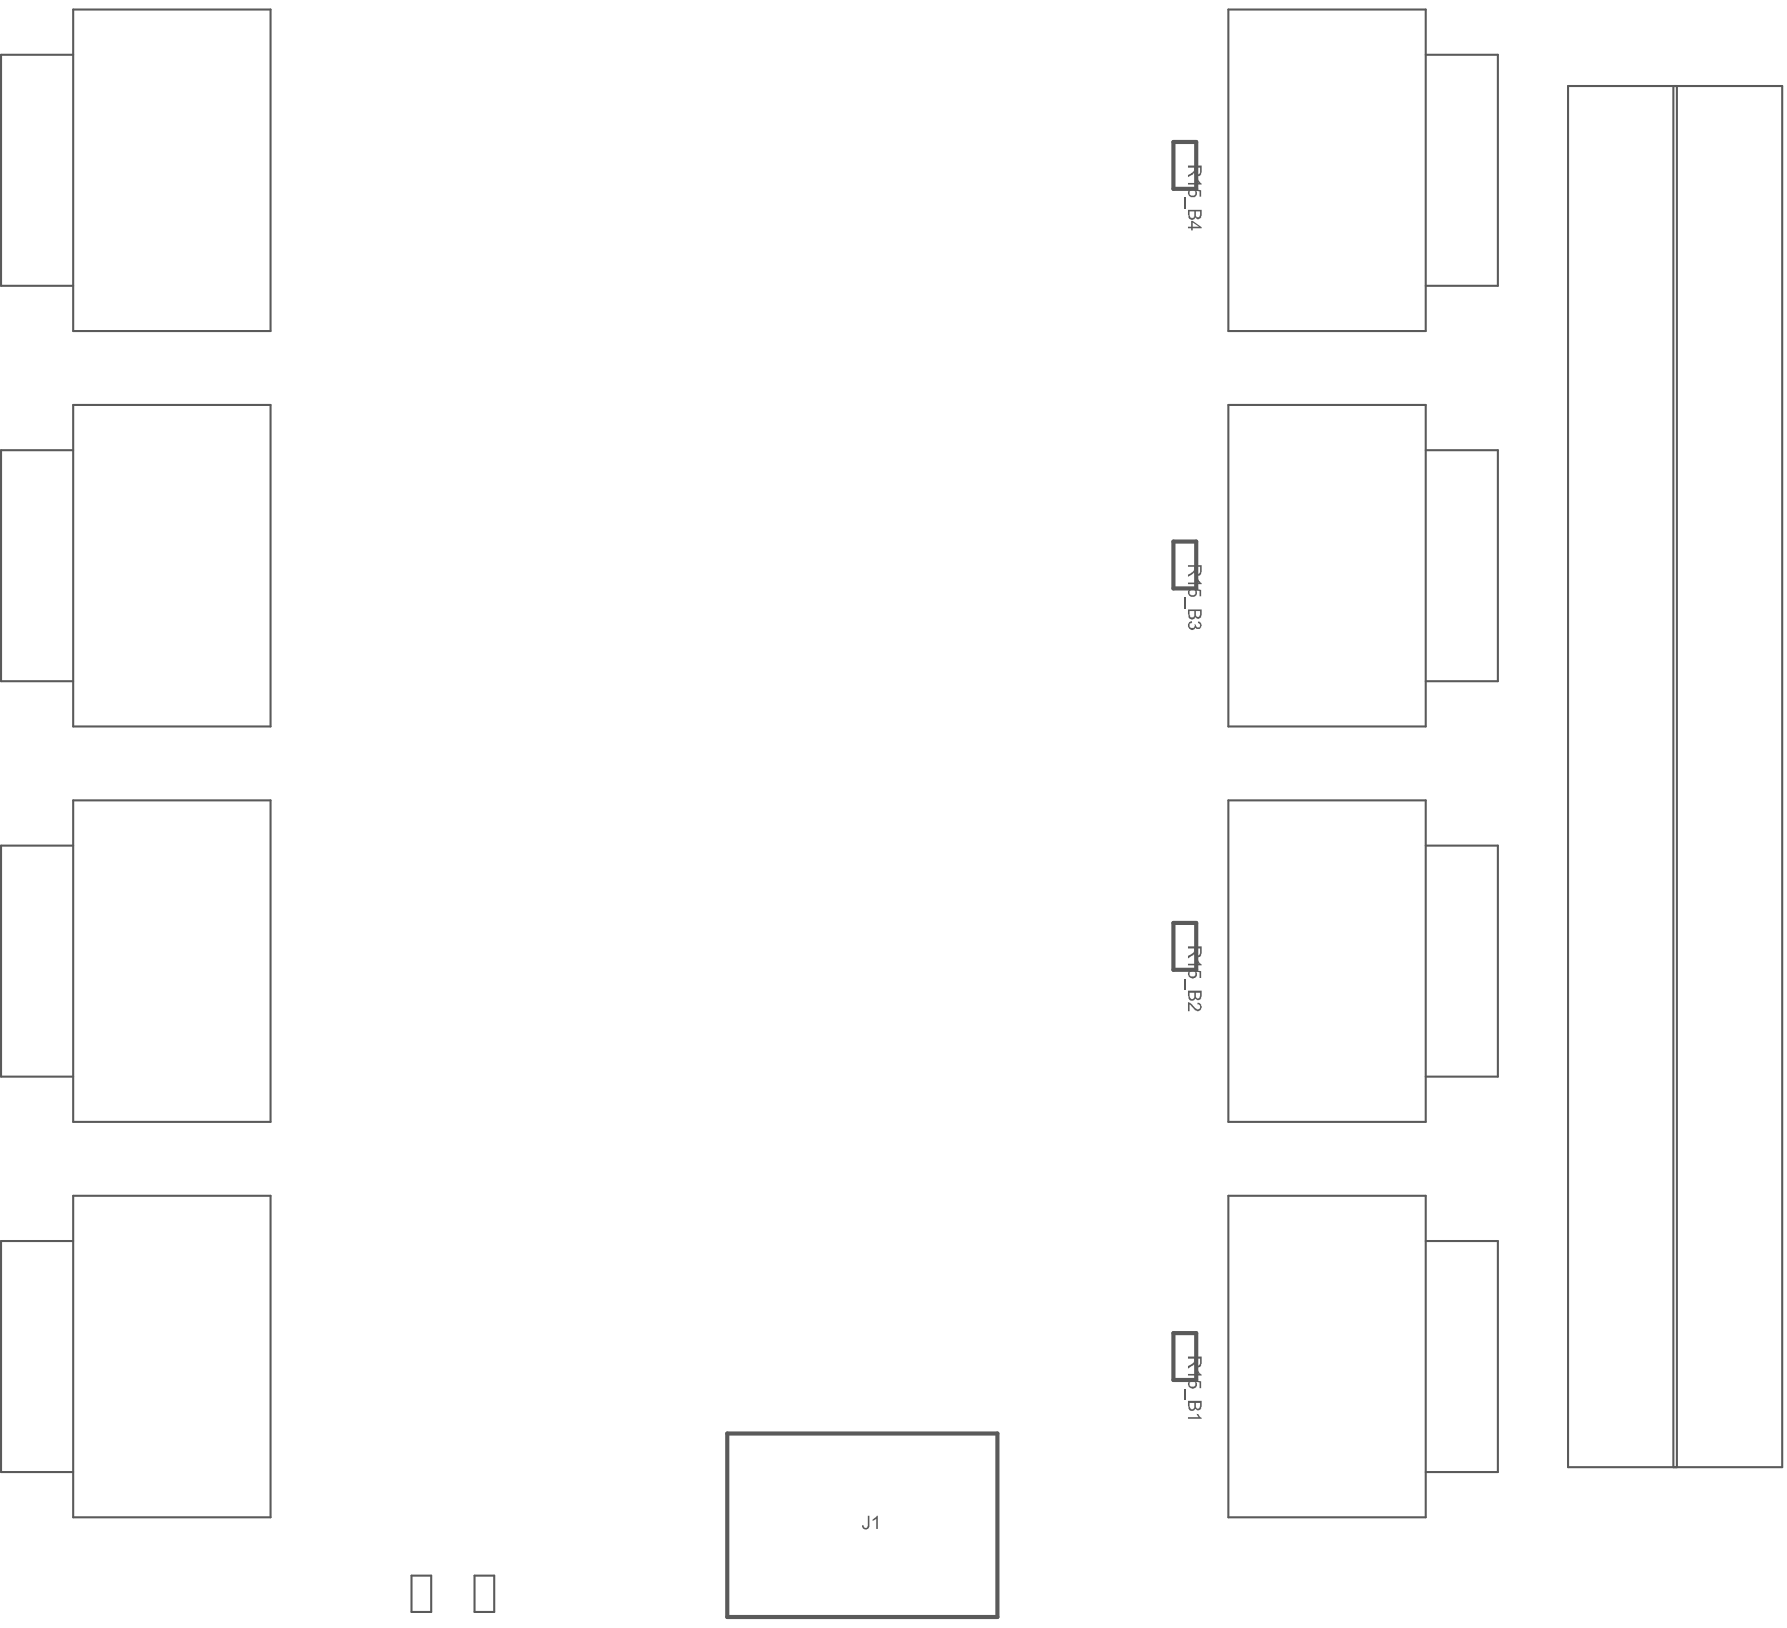
[picture p76: page 1]

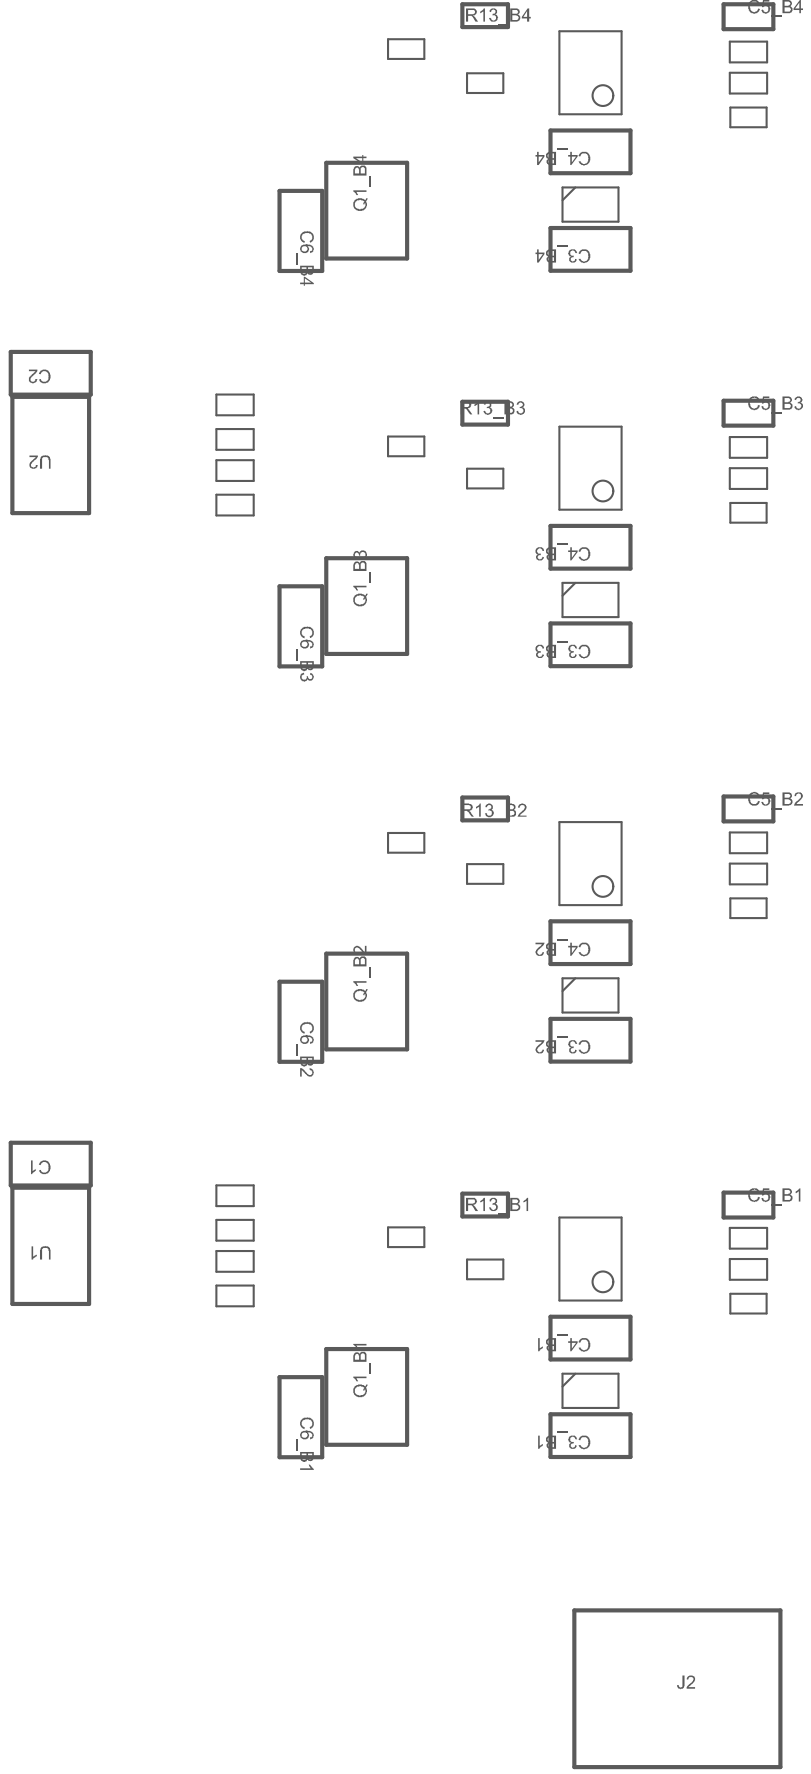
[picture p77: page 2]
