hiteshbhoyar03/Cubesat/Electrical Power System_EPS/docs/Assembly Drawings EPS.pdf

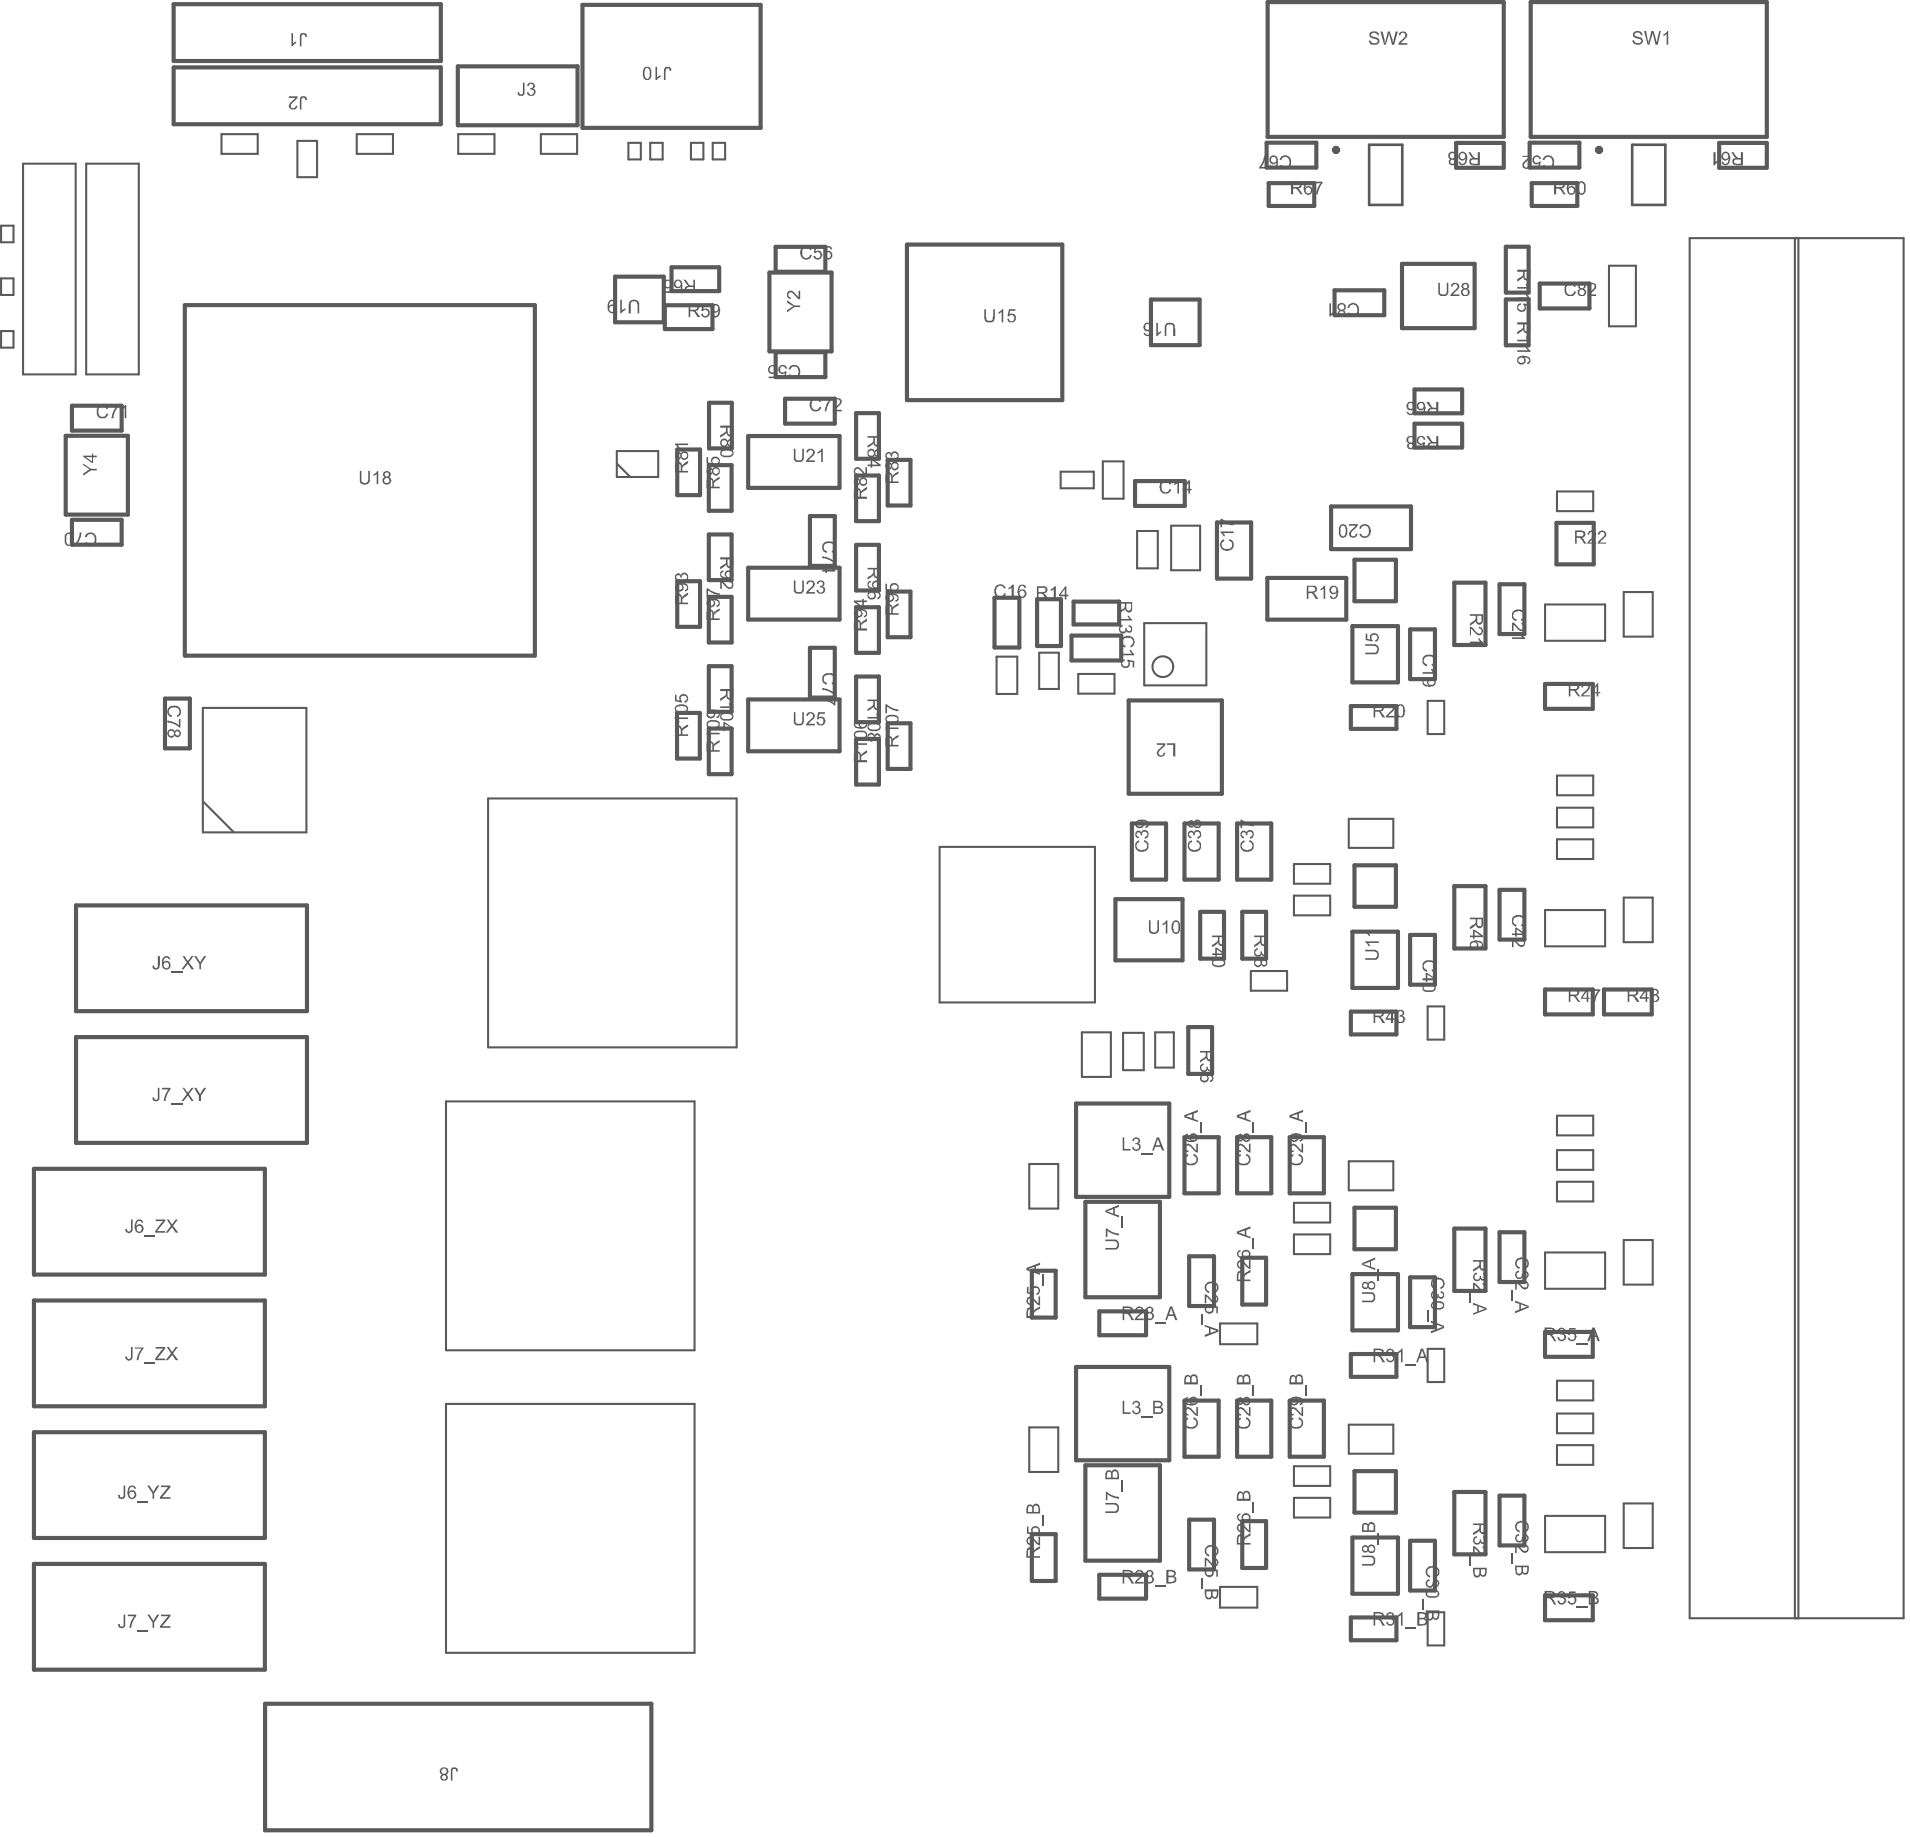
[picture p78: page 1]

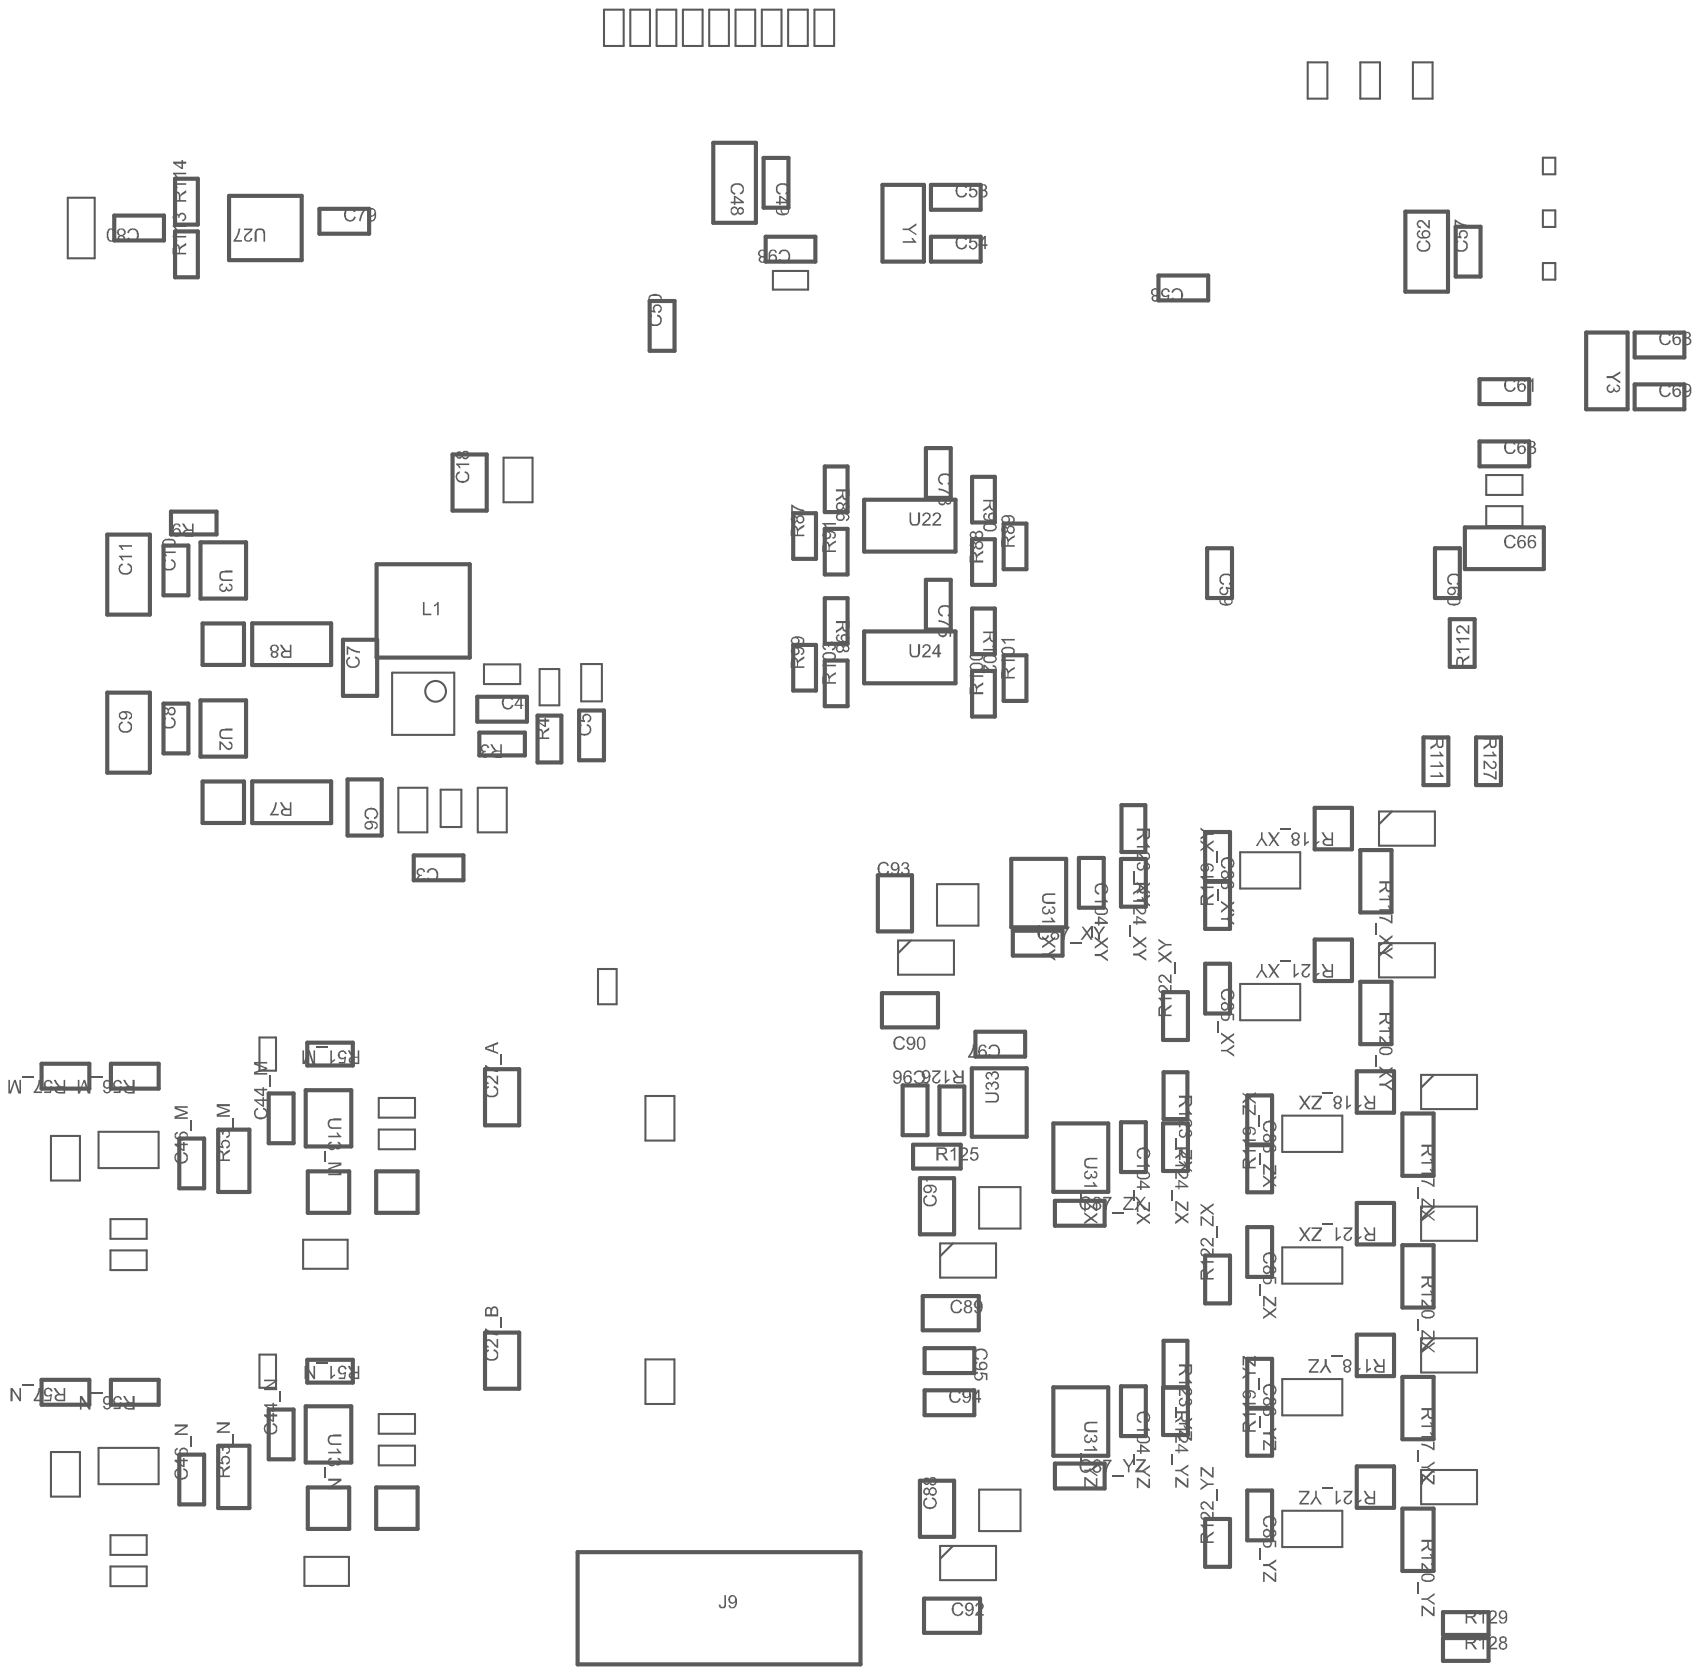
[picture p79: page 2]
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
