hiteshbhoyar03/Cubesat/OnBoard Computer_OBC/docs/Assembly Drawings On board Computer.pdf

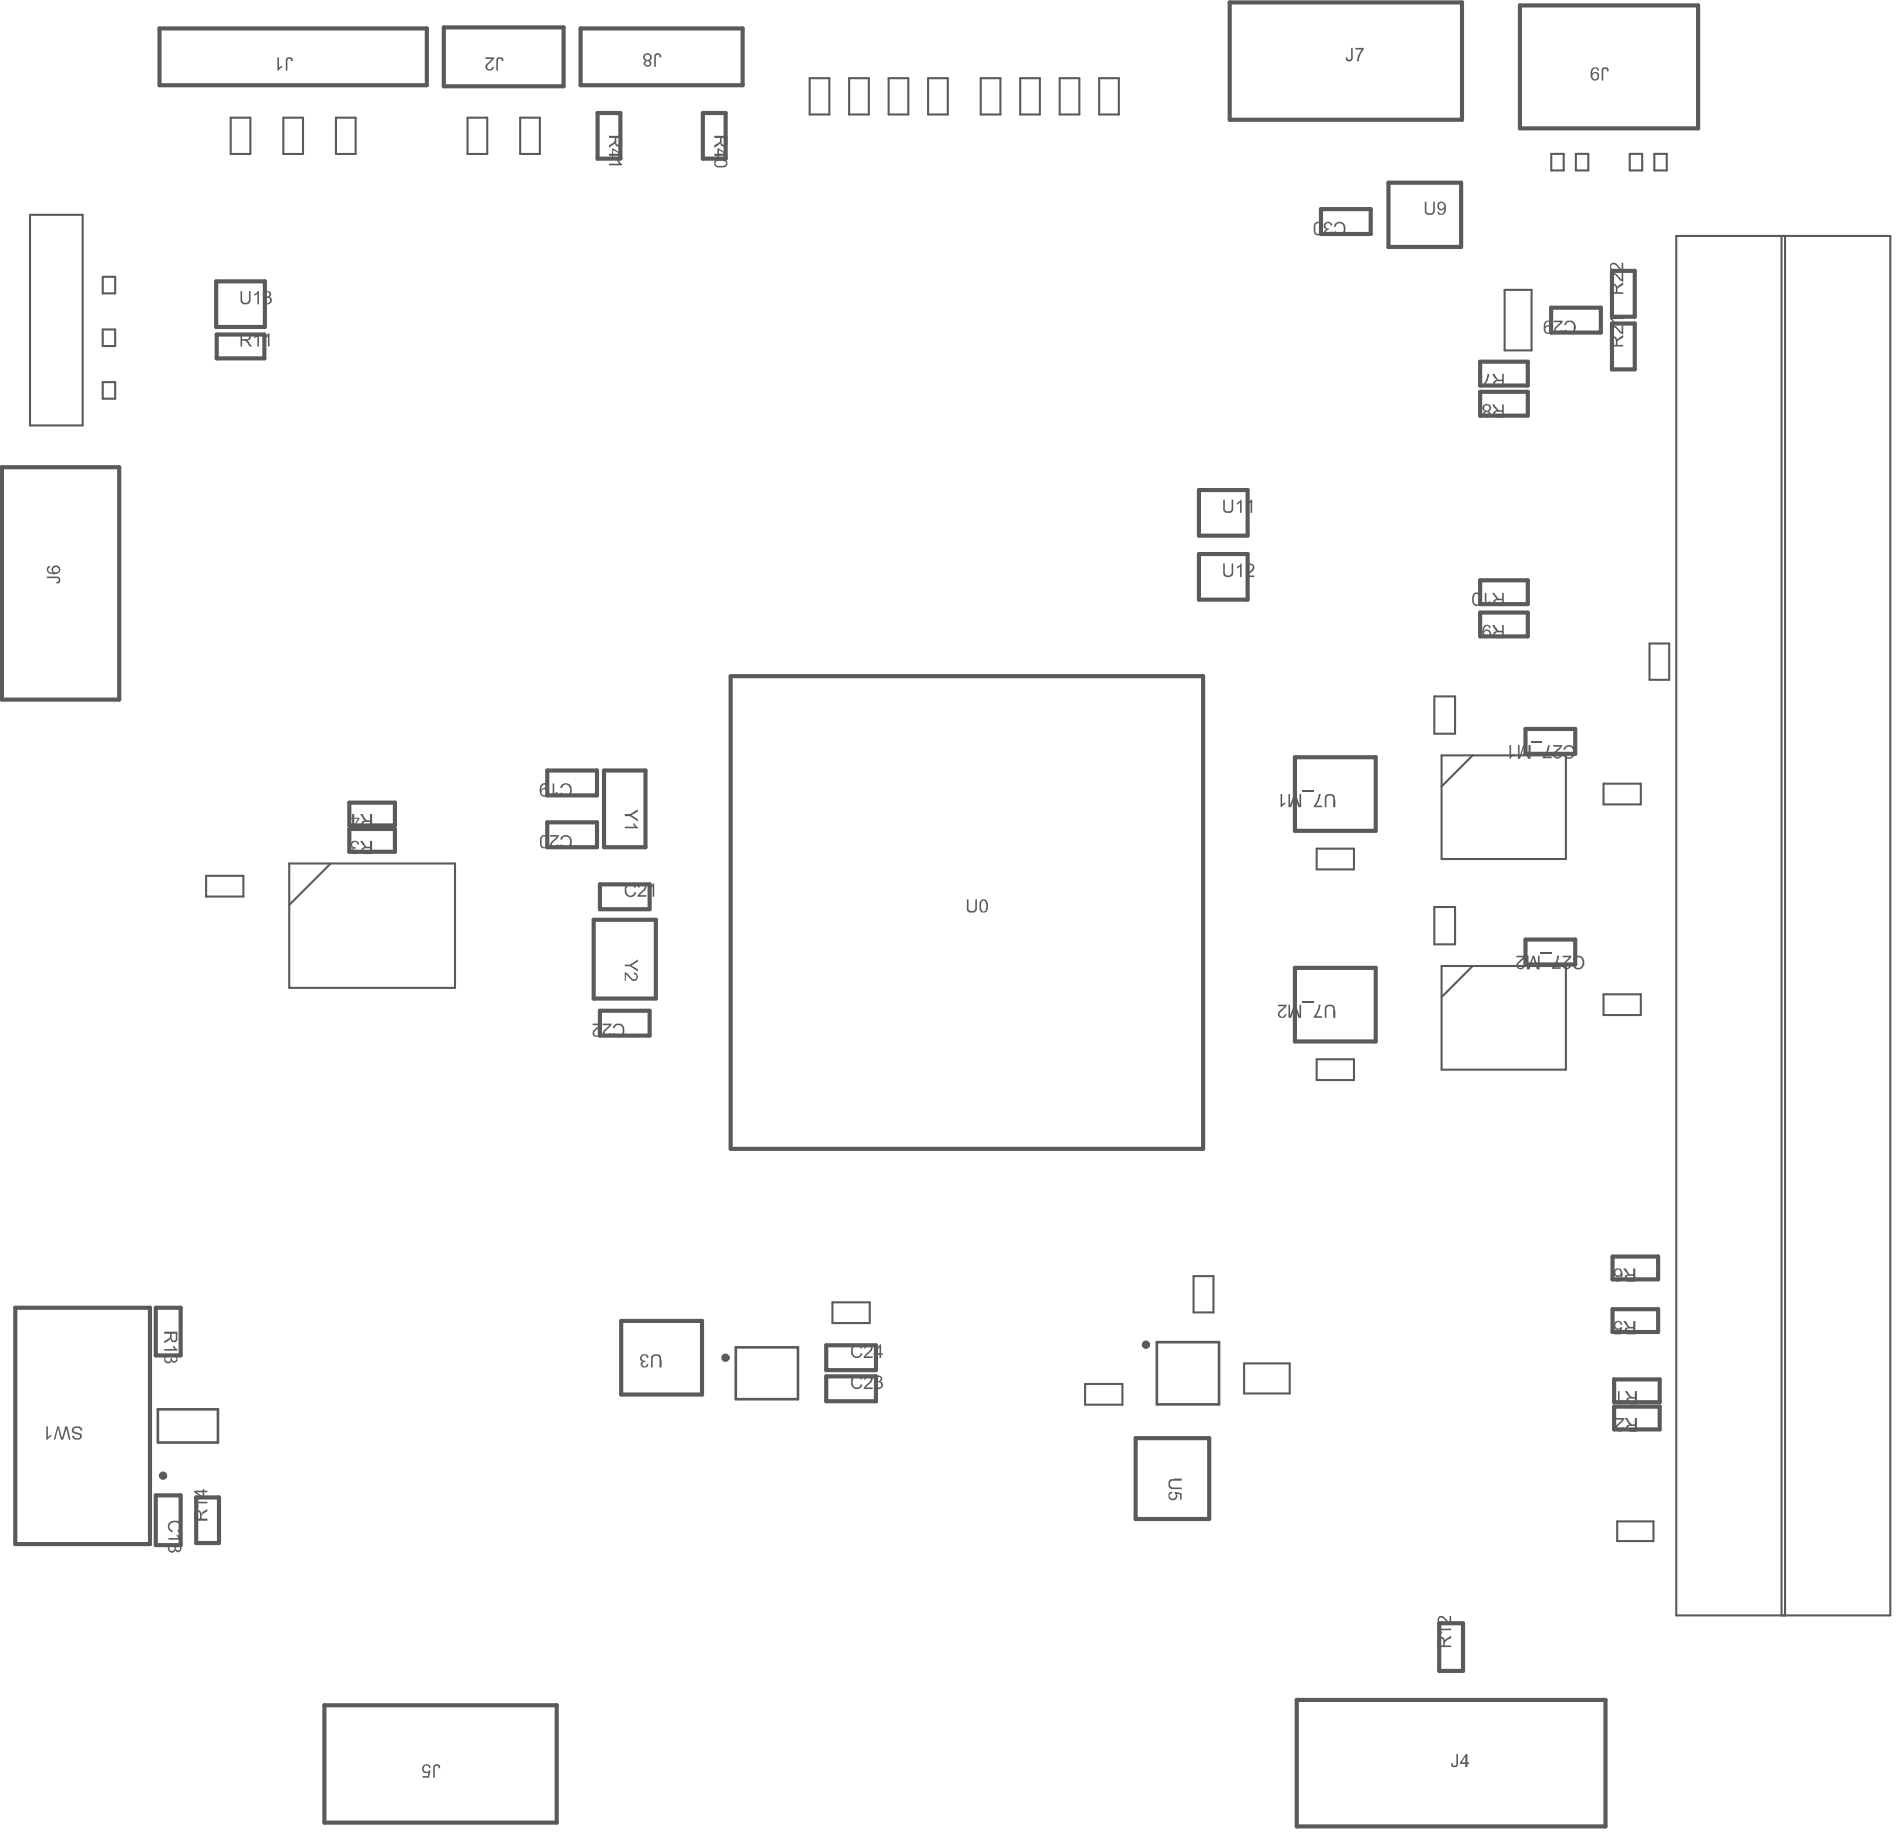
[picture p80: page 1]

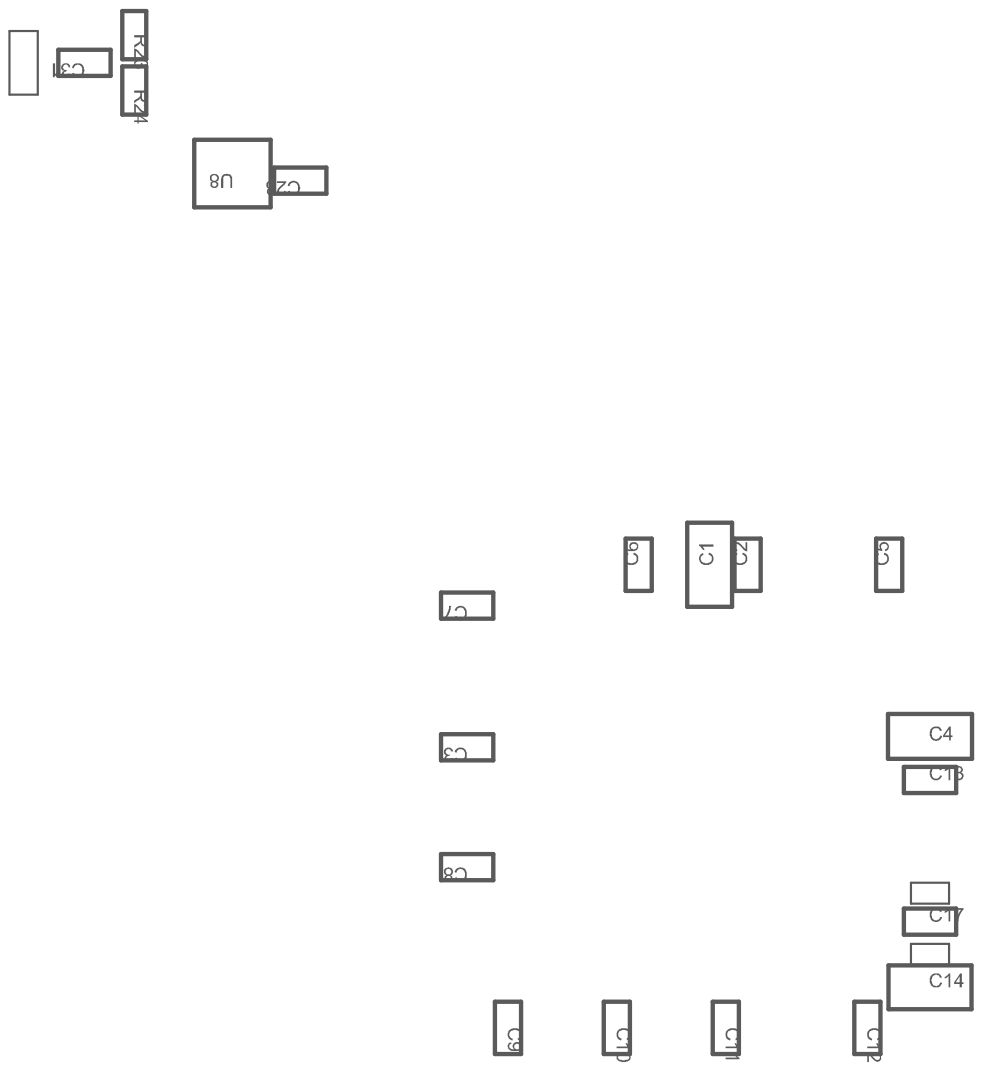
[picture p81: page 2]
