hiteshbhoyar03/Cubesat/Sun Sensor/docs/Assembly Drawings Sun Sensor.pdf

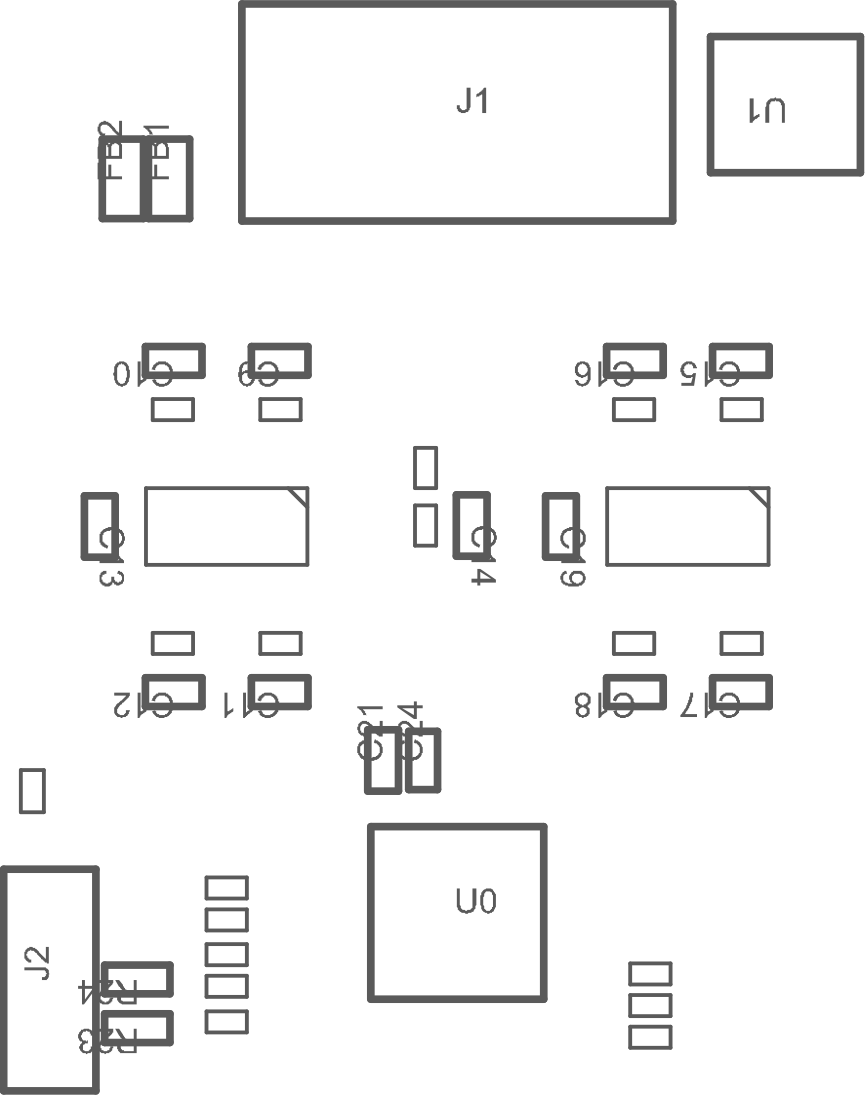
[picture p82: page 1]

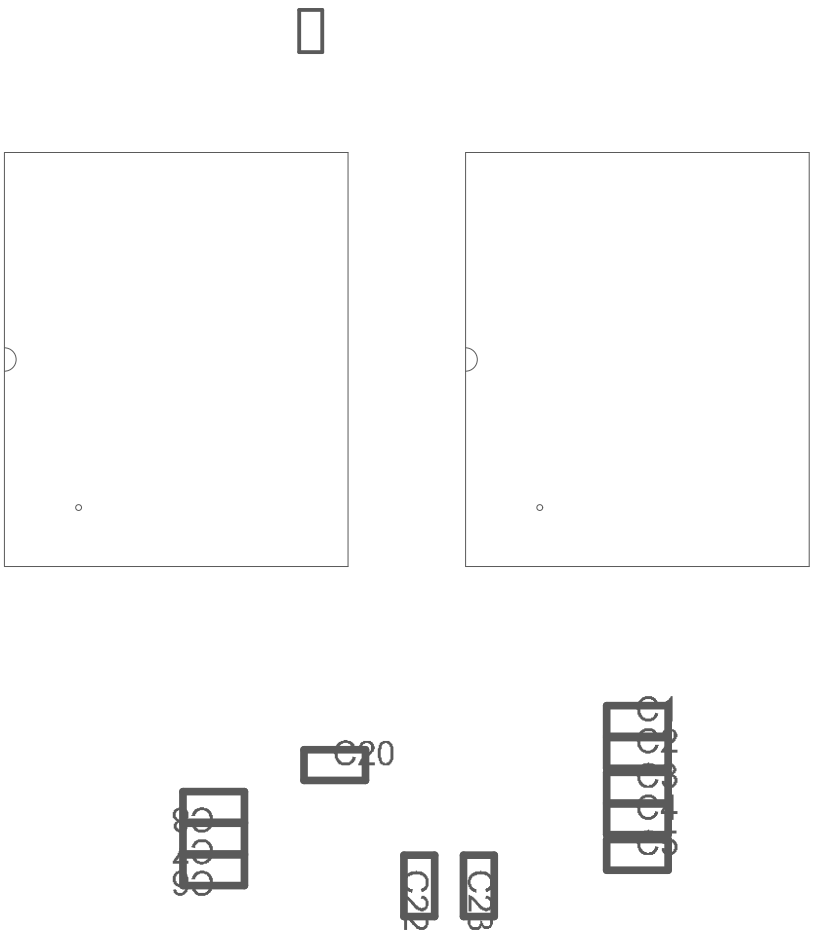
[picture p83: page 2]
