hiteshbhoyar03/Cubesat/(list of files, drawings)

Other design files:
Battery Board/hardware/Cubesat Battery Board/battery board.PcbDoc
Battery Board/hardware/Cubesat Battery Board/BatteryCharger.SchDoc
Battery Board/hardware/Cubesat Battery Board/batteryreversed.PcbDoc
Battery Board/hardware/Cubesat Battery Board/BMS.SchDoc
Battery Board/hardware/Cubesat Battery Board/Cubesat Battery Board.PrjPcb
Battery Board/hardware/Cubesat Battery Board/Top.SchDoc
Electrical Power System_EPS/hardware/Cubesat EPS/3V3_EPS.SchDoc
Electrical Power System_EPS/hardware/Cubesat EPS/3V3_MCU.SchDoc
Electrical Power System_EPS/hardware/Cubesat EPS/3V3_VoltageReg.SchDoc
Electrical Power System_EPS/hardware/Cubesat EPS/5V0_VoltageReg.SchDoc
Electrical Power System_EPS/hardware/Cubesat EPS/CAN1.SchDoc
Electrical Power System_EPS/hardware/Cubesat EPS/CAN2.SchDoc
Electrical Power System_EPS/hardware/Cubesat EPS/Cubesat EPS.PrjPcb
Electrical Power System_EPS/hardware/Cubesat EPS/Mram.SchDoc
Electrical Power System_EPS/hardware/Cubesat EPS/OR_Gate.SchDoc
Electrical Power System_EPS/hardware/Cubesat EPS/Panels.SchDoc
Electrical Power System_EPS/hardware/Cubesat EPS/PC104-52-52.SchDoc
Electrical Power System_EPS/hardware/Cubesat EPS/PMIC.SchDoc
Electrical Power System_EPS/hardware/Cubesat EPS/PMIC_Crystal.SchDoc
Electrical Power System_EPS/hardware/Cubesat EPS/PMIC_Debug.SchDoc
Electrical Power System_EPS/hardware/Cubesat EPS/PMIC_Power.SchDoc
Electrical Power System_EPS/hardware/Cubesat EPS/PMIC_Watchdog.SchDoc
Electrical Power System_EPS/hardware/Cubesat EPS/Ports.SchDoc
Electrical Power System_EPS/hardware/Cubesat EPS/SetResetIC.SchDoc
Electrical Power System_EPS/hardware/Cubesat EPS/SolarMppt.SchDoc
Electrical Power System_EPS/hardware/Cubesat EPS/SRIC_Peripherals.SchDoc
Electrical Power System_EPS/hardware/Cubesat EPS/Top.SchDoc
Electrical Power System_EPS/hardware/Cubesat EPS/UnRegPower.SchDoc
OnBoard Computer_OBC/hardware/Cubesat OBC/CAN1.SchDoc
OnBoard Computer_OBC/hardware/Cubesat OBC/CAN2.SchDoc
OnBoard Computer_OBC/hardware/Cubesat OBC/Crystals.SchDoc
OnBoard Computer_OBC/hardware/Cubesat OBC/Cubesat OBC.PrjPcb
OnBoard Computer_OBC/hardware/Cubesat OBC/IMU_ISM330ISN.SchDoc
OnBoard Computer_OBC/hardware/Cubesat OBC/MAG_MMC5983MA.SchDoc
OnBoard Computer_OBC/hardware/Cubesat OBC/MCU.SchDoc
OnBoard Computer_OBC/hardware/Cubesat OBC/MCU_Power.SchDoc
OnBoard Computer_OBC/hardware/Cubesat OBC/MRAM_MR25H40.SchDoc
OnBoard Computer_OBC/hardware/Cubesat OBC/NOR_FLASH.SchDoc
OnBoard Computer_OBC/hardware/Cubesat OBC/PC104_52-52.SchDoc
OnBoard Computer_OBC/hardware/Cubesat OBC/Ports.SchDoc
OnBoard Computer_OBC/hardware/Cubesat OBC/Top.SchDoc
OnBoard Computer_OBC/hardware/Cubesat OBC/Watchdog.SchDoc
Sun Sensor/hardware/Cubesat Sun Sensor/Cubesat Sun Sensor.PrjPcb
Sun Sensor/hardware/Cubesat Sun Sensor/sunsensor.PcbDoc
Sun Sensor/hardware/Cubesat Sun Sensor/sunsensor.SchDoc
