hiteshbhoyar03/Cubesat/Electrical Power System_EPS/firmware/EPS PMIC/Core/Src/main.c

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
/* Includes ------------------------------------------------------------------*/
#include "main.h"

/* USER CODE BEGIN Includes */
#include <stdio.h>
#include <string.h>
#include "pmic_functions.h"

/* USER CODE END Includes */

/* USER CODE BEGIN PTD */
int _write(int file, char* p, int len)
{
	for(int i=0;i<len;i++)
	{
		while(!LL_USART_IsActiveFlag_TXE(USART1));
		LL_USART_TransmitData8(USART1, *(p+i));
	}
	return len;
}

/* USER CODE END PTD */


CAN_HandleTypeDef hcan1;
CAN_HandleTypeDef hcan2;

I2C_HandleTypeDef hi2c1;

QSPI_HandleTypeDef hqspi;

/* USER CODE BEGIN PV */

extern uint8_t usart1_rx_flag;						// DEBUG
extern uint8_t usart1_rx_data;						// DEBUG

uint8_t  flagDMATC1 = 0;							// DMA TRANSFER COMPLETE CHANNEL 1 FLAG
uint8_t  flagDMATC3 = 0;							// DMA TRANSFER COMPLETE CHANNEL 3 FLAG
uint16_t adc1_Val[15];								// ADC1 VALUE
uint16_t adc3_Val[6];								// ADC3 VALUE

extern uint8_t sric_2_pmic_rx_buffer[20];			// SRIC-PMIC RX BUFFER
extern uint8_t sric_2_pmic_rx_complete_flag;		// SRIC-PMIC COMPLETE FLAG
extern uint8_t obc_2_pmic_rx_buffer[20];			// OBC-PMIC RX BUFFER
extern uint8_t obc_2_pmic_rx_complete_flag;			// OBC-PMIC COMPLETE FLAG

uint8_t pmic_2_sric_tx_buffer[20];					// PMIC-SR TX BUFFER
uint8_t pmic_2_obc_tx_buffer[20];					// PMIC-OBC TX BUFFER



/* USER CODE END PV */

void SystemClock_Config(void);
void PeriphCommonClock_Config(void);
static void MX_GPIO_Init(void);
static void MX_DMA_Init(void);
static void MX_CAN1_Init(void);
static void MX_CAN2_Init(void);
static void MX_QUADSPI_Init(void);
static void MX_RTC_Init(void);
static void MX_UART4_Init(void);
static void MX_USART1_UART_Init(void);
static void MX_USART2_UART_Init(void);
static void MX_USART3_UART_Init(void);
static void MX_ADC1_Init(void);
static void MX_ADC3_Init(void);
static void MX_USB_OTG_FS_USB_Init(void);
static void MX_I2C1_Init(void);
static void MX_SPI2_Init(void);
static void MX_TIM3_Init(void);
static void MX_TIM4_Init(void);
/**
  * @brief  The application entry point.
  * @retval int
  */
int main(void)
{

  /* MCU Configuration--------------------------------------------------------*/

  /* Reset of all peripherals, Initializes the Flash interface and the Systick. */
  HAL_Init();

  /* Configure the system clock */
  SystemClock_Config();

  /* Configure the peripherals common clocks */
  PeriphCommonClock_Config();

  /* Initialize all configured peripherals */
  MX_GPIO_Init();
  MX_DMA_Init();
  MX_CAN1_Init();
  MX_CAN2_Init();
  MX_QUADSPI_Init();
  MX_RTC_Init();
  MX_UART4_Init();
  MX_USART1_UART_Init();
  MX_USART2_UART_Init();
  MX_USART3_UART_Init();
  MX_ADC1_Init();
  MX_ADC3_Init();
  MX_USB_OTG_FS_USB_Init();
  MX_I2C1_Init();
  MX_SPI2_Init();
  MX_TIM3_Init();
  MX_TIM4_Init();
  /* USER CODE BEGIN 2 */

	LL_USART_EnableIT_RXNE(USART1);				// DEBUG
	LL_USART_EnableIT_RXNE(USART2);				// Uart  SR-PMIC
	LL_USART_EnableIT_RXNE(USART3);				// Uart  OBC-PMIC

	LL_DMA_ConfigAddresses(DMA1,				// DMA1_CHANNEL1 FOR ADC1
			LL_DMA_CHANNEL_1,
			LL_ADC_DMA_GetRegAddr(ADC1, LL_ADC_DMA_REG_REGULAR_DATA),
			(uint32_t)adc1_Val,
			LL_DMA_DIRECTION_PERIPH_TO_MEMORY);
	LL_DMA_SetDataLength(DMA1, LL_DMA_CHANNEL_1, 15);			// configure DMA length
	LL_DMA_EnableChannel(DMA1, LL_DMA_CHANNEL_1);				// enable DMA stream
	LL_ADC_Enable(ADC1);										// enable ADC
	LL_ADC_REG_StartConversion(ADC1);							// start conversion

	LL_DMA_ConfigAddresses(DMA1,								// DMA1_CHANNEL3 FOR ADC3
			LL_DMA_CHANNEL_3,
			LL_ADC_DMA_GetRegAddr(ADC3, LL_ADC_DMA_REG_REGULAR_DATA),
			(uint32_t)adc3_Val,
			LL_DMA_DIRECTION_PERIPH_TO_MEMORY);
	LL_DMA_SetDataLength(DMA1, LL_DMA_CHANNEL_3, 6);			// configure DMA length
	LL_DMA_EnableChannel(DMA1, LL_DMA_CHANNEL_3);				// enable DMA stream
	LL_ADC_Enable(ADC3);										// enable ADC
	LL_ADC_REG_StartConversion(ADC3);							// start conversion

	pmic_2_sric_tx_buffer[0]=0xEF;								// HEADER SETUP
	pmic_2_sric_tx_buffer[1]=0X00;
	pmic_2_obc_tx_buffer[0]=0xEB;
	pmic_2_obc_tx_buffer[1]=0X00;


  /* USER CODE END 2 */

  /* Infinite loop */
  /* USER CODE BEGIN WHILE */
  while (1)
  {

		while(!flagDMATC1);
		// clear flag
		flagDMATC1 = 0;
		while(!flagDMATC3);
		// clear flag
		flagDMATC3 = 0;

		/*--------------------------------------------------------------------------------------------*/
		/* UART SRIC_2_PMIC --------------------------------------------------------------------------*/
		/*--------------------------------------------------------------------------------------------*/
		if(sric_2_pmic_rx_complete_flag == 1)
		{
			sric_2_pmic_rx_complete_flag = 0;
			if(SRIC_2_PMIC_Check_CHKSUM(&sric_2_pmic_rx_buffer[0]) == 1){
				SRIC_2_PMIC_Parsing(&sric_2_pmic_rx_buffer[0], &sr2pm);
			}
		}
		/*--------------------------------------------------------------------------------------------*/
		/* UART OBC_2_PMIC ---------------------------------------------------------------------------*/
		/*--------------------------------------------------------------------------------------------*/
		if(obc_2_pmic_rx_complete_flag == 1)
		{
			obc_2_pmic_rx_complete_flag = 0;
			if(OBC_2_PMIC_Check_CHKSUM(&obc_2_pmic_rx_buffer[0]) == 1){
				OBC_2_PMIC_Parsing(&obc_2_pmic_rx_buffer[0], &obc2pm);
			}
		}
		/* CONFIGURE SATELLITE POWER -----------------------------------------------------------------*/
		PMIC_CONFIG_SAT_POWER( &obc2pm );






		/* SATELLITE PMIC TASKS HERE -----------------------------------------------------------------*/
		/* SATELLITE PMIC TASKS HERE -----------------------------------------------------------------*/
		/* SATELLITE PMIC TASKS HERE -----------------------------------------------------------------*/
		/* SATELLITE PMIC TASKS HERE -----------------------------------------------------------------*/
		/* SATELLITE PMIC TASKS HERE -----------------------------------------------------------------*/
		/* SATELLITE PMIC TASKS HERE -----------------------------------------------------------------*/
		/* SATELLITE PMIC TASKS HERE -----------------------------------------------------------------*/
		/* SATELLITE PMIC TASKS HERE -----------------------------------------------------------------*/
		/* SATELLITE PMIC TASKS HERE -----------------------------------------------------------------*/
		/* SATELLITE PMIC TASKS HERE -----------------------------------------------------------------*/










		/* SEND DATA PMIC_2_SRIC ---------------------------------------------------------------------*/
		SEND_DATA_UART(&pmic_2_sric_tx_buffer[0], USART2, 20);// CONTAINS CHKSUM GENRATOR
		/* SEND DATA PMIC_2_OBC ----------------------------------------------------------------------*/
		SEND_DATA_UART(&pmic_2_obc_tx_buffer[0], USART3, 20);


    /* USER CODE END WHILE */

    /* USER CODE BEGIN 3 */
  }
  /* USER CODE END 3 */
}

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
