hiteshbhoyar03/Cubesat/OnBoard Computer_OBC/firmware/OBC/OBC.ioc

Mcu.UserName=STM32L496ZGTx
PA0.Signal=ADCx_IN5
PA1.Signal=ADCx_IN6
PA10.Signal=USB_OTG_FS_ID
PA11.Signal=USB_OTG_FS_DM
PA12.Signal=USB_OTG_FS_DP
PA2.Signal=ADCx_IN7
PA3.Signal=ADCx_IN8
PA4.Signal=ADCx_IN9
PA5.Signal=ADCx_IN10
PA6.Signal=ADCx_IN11
PA7.Signal=ADCx_IN12
PA8.Signal=GPIO_Output
PA9.Signal=USART1_TX
PB0.GPIO_Label=nCS_ISM330ISN
PB0.Signal=GPIO_Output
PB1.Signal=USART3_RTS
PB10.Signal=SPI2_SCK
PB11.Signal=LPUART1_TX
PB12.Signal=CAN2_RX
PB13.Signal=CAN2_TX
PB14.Signal=SPI2_MISO
PB15.Signal=SPI2_MOSI
PB2.GPIO_Label=INT1_ISM330ISN
PB2.Signal=GPIO_Input
PB5.GPIO_Label=DEBUG_LED4
PB5.Signal=GPIO_Output
PB6.GPIO_Label=DEBUG_LED5
PB6.Signal=GPIO_Output
PB7.Signal=USART1_RX
PB8.GPIO_Label=DEBUG_LED6
PB8.Signal=GPIO_Output
PB9.GPIO_Label=DEBUG_LED7
PB9.Signal=GPIO_Output
PC0.Signal=ADCx_IN1
PC1.Signal=ADCx_IN2
PC10.Signal=UART4_TX
PC11.Signal=UART4_RX
PC12.Signal=UART5_TX
PC2.Signal=ADCx_IN3
PC3.Signal=ADCx_IN4
PC4.Signal=USART3_TX
PC5.Signal=USART3_RX
PC6.GPIO_Label=nCS_MRAM1
PC6.Signal=GPIO_Output
PC7.Signal=GPIO_Output
PC8.Signal=GPIO_Output
PC9.Signal=I2C3_SDA
PD0.Signal=CAN1_RX
PD1.Signal=CAN1_TX
PD10.Signal=GPIO_Output
PD11.Signal=USART3_CTS
PD12.Signal=GPIO_Output
PD13.Signal=GPIO_Output
PD14.GPIO_Label=nCS_MRAM2
PD14.Signal=GPIO_Output
PD15.Signal=GPIO_Output
PD2.Signal=UART5_RX
PD3.Signal=USART2_CTS
PD4.Signal=USART2_RTS
PD5.Signal=USART2_TX
PD6.Signal=USART2_RX
PD7.GPIO_Label=DEBUG_LED1
PD7.Signal=GPIO_Output
PD8.GPIO_Label=DRDY_MMC5983MA
PD8.Signal=GPIO_Input
PD9.GPIO_Label=nCS_MMC5983MA
PD9.Signal=GPIO_Output
PE0.GPIO_Label=DEBUG_LED8
PE0.Signal=GPIO_Output
PE11.Signal=QUADSPI_BK1_NCS
PE13.Signal=SPI1_SCK
PE14.Signal=SPI1_MISO
PE15.Signal=SPI1_MOSI
PE2.GPIO_Label=SPI1_nCS3
PE2.Signal=GPIO_Output
PE3.GPIO_Label=SPI1_nCS2
PE3.Signal=GPIO_Output
PE7.Signal=GPIO_Output
PE8.Signal=GPIO_Output
PE9.Signal=GPIO_Output
PF0.Signal=I2C2_SDA
PF1.Signal=I2C2_SCL
PF10.Signal=QUADSPI_CLK
PF11.GPIO_Label=INT2_ISM330ISN
PF11.Signal=GPIO_Input
PF12.GPIO_Label=nRESET_GPS
PF12.Signal=GPIO_Output
PF3.GPIO_Label=SPI1_nCS1
PF3.Signal=GPIO_Output
PF4.GPIO_Label=WAKE
PF4.Signal=GPIO_Output
PF5.GPIO_Label=DONE
PF5.Signal=GPIO_Output
PF6.Signal=QUADSPI_BK1_IO3
PF7.Signal=QUADSPI_BK1_IO2
PF8.Signal=QUADSPI_BK1_IO0
PF9.Signal=QUADSPI_BK1_IO1
PG1.Signal=GPIO_Output
PG10.Signal=SPI3_MISO
PG11.Signal=SPI3_MOSI
PG12.GPIO_Label=DEBUG_LED2
PG12.Signal=GPIO_Output
PG13.Signal=I2C1_SDA
PG14.Signal=I2C1_SCL
PG15.GPIO_Label=DEBUG_LED3
PG15.Signal=GPIO_Output
PG2.Signal=GPIO_Output
PG3.Signal=GPIO_Output
PG4.Signal=GPIO_Output
PG5.Signal=GPIO_Output
PG6.Signal=GPIO_Output
PG7.Signal=I2C3_SCL
PG8.Signal=LPUART1_RX
PG9.Signal=SPI3_SCK
