hiteshbhoyar03/Cubesat/Sun Sensor/firmware/sunsensor/Core/Src/main.c

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
/* Includes ------------------------------------------------------------------*/
#include "main.h"


void SystemClock_Config(void);
static void MX_GPIO_Init(void);
static void MX_DMA_Init(void);
static void MX_ADC_Init(void);
static void MX_SPI1_Init(void);
/* USER CODE BEGIN 0 */
uint8_t  flagDMATC = 0;
uint16_t adcVal[10];
uint16_t regmap[16];
uint8_t  spi_rx_data = 0;
uint8_t  spi_tx_data = 0;
//int __io_putchar (int ch)
//{
//  while (!LL_USART_IsActiveFlag_TXE(USARTx));
//  LL_USART_TransmitData8(USARTx, (char)ch);
//  return ch;
//}
/* USER CODE END 0 */

/**
 * @brief  The application entry point.
 * @retval int
 */
int main(void)
{

	/* MCU Configuration--------------------------------------------------------*/

	/* Reset of all peripherals, Initializes the Flash interface and the Systick. */
	LL_APB2_GRP1_EnableClock(LL_APB2_GRP1_PERIPH_SYSCFG);
	LL_APB1_GRP1_EnableClock(LL_APB1_GRP1_PERIPH_PWR);

	/* SysTick_IRQn interrupt configuration */
	NVIC_SetPriority(SysTick_IRQn, 3);

	/* Configure the system clock */
	SystemClock_Config();

	/* Initialize all configured peripherals */
	MX_GPIO_Init();
	MX_DMA_Init();
	MX_ADC_Init();
	MX_SPI1_Init();
	/* USER CODE BEGIN 2 */

	// configure DMA source & target
	LL_DMA_ConfigAddresses(DMA1,
			LL_DMA_CHANNEL_1,
			LL_ADC_DMA_GetRegAddr(ADC1, LL_ADC_DMA_REG_REGULAR_DATA),
			(uint32_t)adcVal,
			LL_DMA_DIRECTION_PERIPH_TO_MEMORY);
	// configure DMA length
	LL_DMA_SetDataLength(DMA1, LL_DMA_CHANNEL_1, 10);
	// enable DMA stream
	LL_DMA_EnableChannel(DMA1, LL_DMA_CHANNEL_1);
	// enable ADC
	LL_ADC_Enable(ADC1);
	// start conversion
	LL_ADC_REG_StartConversion(ADC1);

	/* USER CODE END 2 */

	/* Infinite loop */
	/* USER CODE BEGIN WHILE */
	while (1)
	{
		while(!flagDMATC);
		// clear flag
		flagDMATC = 0;

		int16_t sum_psd1 = adcVal[1]+adcVal[3]+adcVal[2]+adcVal[0];
		int16_t a1 = (int16_t)(adcVal[3]+adcVal[2]) - (int16_t)(adcVal[1]+adcVal[0]);
		int16_t b1 = (int16_t)(adcVal[3]+adcVal[0]) - (int16_t)(adcVal[1]+adcVal[2]);
		int16_t position_x_psd1 = a1/sum_psd1;
		int16_t position_y_psd1 = b1/sum_psd1;
		int16_t intensity_psd1 = sum_psd1;


		int16_t sum_psd2 = adcVal[5]+adcVal[7]+adcVal[6]+adcVal[4];
		int16_t a2 = (int16_t)(adcVal[7]+adcVal[6]) - (int16_t)(adcVal[5]+adcVal[4]);
		int16_t b2 = (int16_t)(adcVal[7]+adcVal[4]) - (int16_t)(adcVal[5]+adcVal[6]);
		int16_t position_x_psd2 = a2/sum_psd2;
		int16_t position_y_psd2 = b2/sum_psd2;
		int16_t intensity_psd2 = sum_psd2;


		//	    // convert to temperature & Vdd
		//	    float temp = (float)adcVal[8] * 3.3f / 4096.0f;
		//	    temp = (temp - 0.76) / 0.0025 + 25;
		//
		//	    // Vdd = 3.3V * Vrefint_cal / Vrefint
		//	    float Vdd = 3.3f * (*VREFINT_CAL_ADDR) / (float)adcVal[9];

		// print results
		//	    printf("psd1 x1: %d, psd1 x2: %d, psd1 y1: %d, psd1 y2: %d,"
		//	    	   "psd2 x1: %d, psd2 x2: %d, psd2 y1: %d, psd2 y2: %d,"
		//	    	   " TEMP: %2.1f, Vdd: %1.2f\r\n",
		//			   adcVal[1],adcVal[3],adcVal[2],adcVal[0],
		//			   adcVal[5],adcVal[7],adcVal[6],adcVal[4], temp, Vdd);

		for(uint16_t i=0;i<10;i++){
			regmap[i] = adcVal[i];
		}
		regmap[10]=position_x_psd1;
		regmap[11]=position_y_psd1;
		regmap[12]=intensity_psd1;
		regmap[13]=position_x_psd2;
		regmap[14]=position_y_psd2;
		regmap[15]=intensity_psd2;
		//	    regmap[16]=temp;
		//	    regmap[17]=Vdd;


		if(LL_GPIO_IsInputPinSet(NCS_GPIO_Port, NCS_Pin) == 0){

			while (!LL_SPI_IsActiveFlag_RXNE(SPI1));
			spi_rx_data = LL_SPI_ReceiveData8(SPI1);

			uint8_t spi_tx_high_byte = ((regmap)[spi_rx_data] >> 8) & 0xFF;
			uint8_t spi_tx_low_byte  =  (regmap)[spi_rx_data] & 0xFF;

			while (!LL_SPI_IsActiveFlag_TXE(SPI1));
			LL_SPI_TransmitData8(SPI1, spi_tx_high_byte);
			while (!LL_SPI_IsActiveFlag_TXE(SPI1));
			LL_SPI_TransmitData8(SPI1, spi_tx_low_byte);
		}



		/* USER CODE END WHILE */

		/* USER CODE BEGIN 3 */
	}
	/* USER CODE END 3 */
}

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
