hiteshbhoyar03/Cubesat/Electrical Power System_EPS/firmware/EPS PMIC/Core/Inc/main.h

#define DEBUG_LED2_Pin LL_GPIO_PIN_2
#define DEBUG_LED2_GPIO_Port GPIOE
#define DEBUG_LED3_Pin LL_GPIO_PIN_3
#define DEBUG_LED3_GPIO_Port GPIOE
#define DEBUG_LED4_Pin LL_GPIO_PIN_4
#define DEBUG_LED4_GPIO_Port GPIOE
#define DEBUG_LED5_Pin LL_GPIO_PIN_5
#define DEBUG_LED5_GPIO_Port GPIOE
#define EN_5V_BOOST_PM_Pin LL_GPIO_PIN_2
#define EN_5V_BOOST_PM_GPIO_Port GPIOB
#define EN_5V_PM_Pin LL_GPIO_PIN_7
#define EN_5V_PM_GPIO_Port GPIOE
#define EN_UNREG1_PM_Pin LL_GPIO_PIN_8
#define EN_UNREG1_PM_GPIO_Port GPIOE
#define EN_UNREG2_PM_Pin LL_GPIO_PIN_9
#define EN_UNREG2_PM_GPIO_Port GPIOE
#define EN_3V3_1_PM_Pin LL_GPIO_PIN_14
#define EN_3V3_1_PM_GPIO_Port GPIOE
#define EN_3V3_2_BUCK_PM_Pin LL_GPIO_PIN_15
#define EN_3V3_2_BUCK_PM_GPIO_Port GPIOE
#define EN_MCU_3V3_PM_Pin LL_GPIO_PIN_8
#define EN_MCU_3V3_PM_GPIO_Port GPIOD
#define EN_MCU_BUCK_PM_Pin LL_GPIO_PIN_9
#define EN_MCU_BUCK_PM_GPIO_Port GPIOD
#define EN_3V3_2_PM_Pin LL_GPIO_PIN_10
#define EN_3V3_2_PM_GPIO_Port GPIOD
#define EN_3V3_1_BUCK_PM_Pin LL_GPIO_PIN_11
#define EN_3V3_1_BUCK_PM_GPIO_Port GPIOD
#define DONE_Pin LL_GPIO_PIN_8
#define DONE_GPIO_Port GPIOC
#define WAKE_Pin LL_GPIO_PIN_9
#define WAKE_GPIO_Port GPIOC
#define DEBUG_LED1_Pin LL_GPIO_PIN_1
#define DEBUG_LED1_GPIO_Port GPIOE
