hiteshbhoyar03/Cubesat/(commit log)

2025-05-26 sun sensor updated
2025-05-29 added sch
    [3V3_EPS.SchDoc, 3V3_MCU.SchDoc, 3V3_VoltageReg.SchDoc, 5V0_VoltageReg.SchDoc, BMS.SchDoc, BatteryCharger.SchDoc, CAN1.SchDoc, CAN2.SchDoc]
2025-05-30 added sun sensor images
2025-05-30 updated pcb
    [batterypack_A.PcbDoc, batterypack_B.PcbDoc]
2025-05-31 added pcb progress
2025-06-11 added firmware
    [eps pinout.xlsx, obc pinout.xlsx, sun sensor pinout.xlsx]
